Shawez17/iseg_6kV_controlSystem/data/README.md

# Data

This folder contains the information about calibration and characterization measurements made while building the supply.

```
calibration/ # Contains the calibration data for vmon, imon and vset
stability/   # Stability characterization of the power supply with analog and remote control settings.
```
