Shawez17/iseg_6kV_controlSystem/pico-raspi/plot.md

Vset expected  : 2.52828 V
Vdac measured  : 2.48955 V
Vset - Vdac    : 0.03873 V

Vset expected  : 2.53096 V
Vdac measured  : 2.49222 V
Vset - Vdac    : 0.03874 V

Vset expected  : 2.53106 V
Vdac measured  : 2.49195 V
Vset - Vdac    : 0.03911 V

Vset expected  : 2.53162 V
Vdac measured  : 2.49264 V
Vset - Vdac    : 0.03898 V

Vset expected  : 2.53133 V
Vdac measured  : 2.49225 V
Vset - Vdac    : 0.03908 V

Vset expected  : 2.53127 V
Vdac measured  : 2.49279 V
Vset - Vdac    : 0.03848 V

Vset expected  : 2.53156 V
Vdac measured  : 2.49267 V
Vset - Vdac    : 0.03889 V

Vset expected  : 2.53184 V
Vdac measured  : 2.49276 V
Vset - Vdac    : 0.03908 V

Vset expected  : 2.53172 V
Vdac measured  : 2.49255 V
Vset - Vdac    : 0.03917 V

Vset expected  : 2.53184 V
Vdac measured  : 2.49303 V
Vset - Vdac    : 0.03881 V

Vset expected  : 2.53172 V
Vdac measured  : 2.49315 V
Vset - Vdac    : 0.03857 V

Vset expected  : 2.53160 V
Vdac measured  : 2.49264 V
Vset - Vdac    : 0.03896 V

Vset expected  : 2.53199 V
Vdac measured  : 2.49318 V
Vset - Vdac    : 0.03881 V

Vset expected  : 2.53182 V
Vdac measured  : 2.49300 V
Vset - Vdac    : 0.03882 V

Vset expected  : 2.53166 V
Vdac measured  : 2.49288 V
Vset - Vdac    : 0.03878 V

Vset expected  : 2.53121 V
Vdac measured  : 2.49279 V
Vset - Vdac    : 0.03842 V

Vset expected  : 2.53106 V
Vdac measured  : 2.49294 V
Vset - Vdac    : 0.03812 V

Vset expected  : 2.53177 V
Vdac measured  : 2.49318 V
Vset - Vdac    : 0.03859 V

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
Vset - Vdac    : 0.03888 V

Vset expected  : 2.53206 V
Vdac measured  : 2.49369 V
Vset - Vdac    : 0.03837 V

Vset expected  : 2.53187 V
Vdac measured  : 2.49309 V
Vset - Vdac    : 0.03878 V

Vset expected  : 2.53196 V
Vdac measured  : 2.49390 V
Vset - Vdac    : 0.03806 V
