Shawez17/iseg_6kV_controlSystem/data/blockdiagram.png

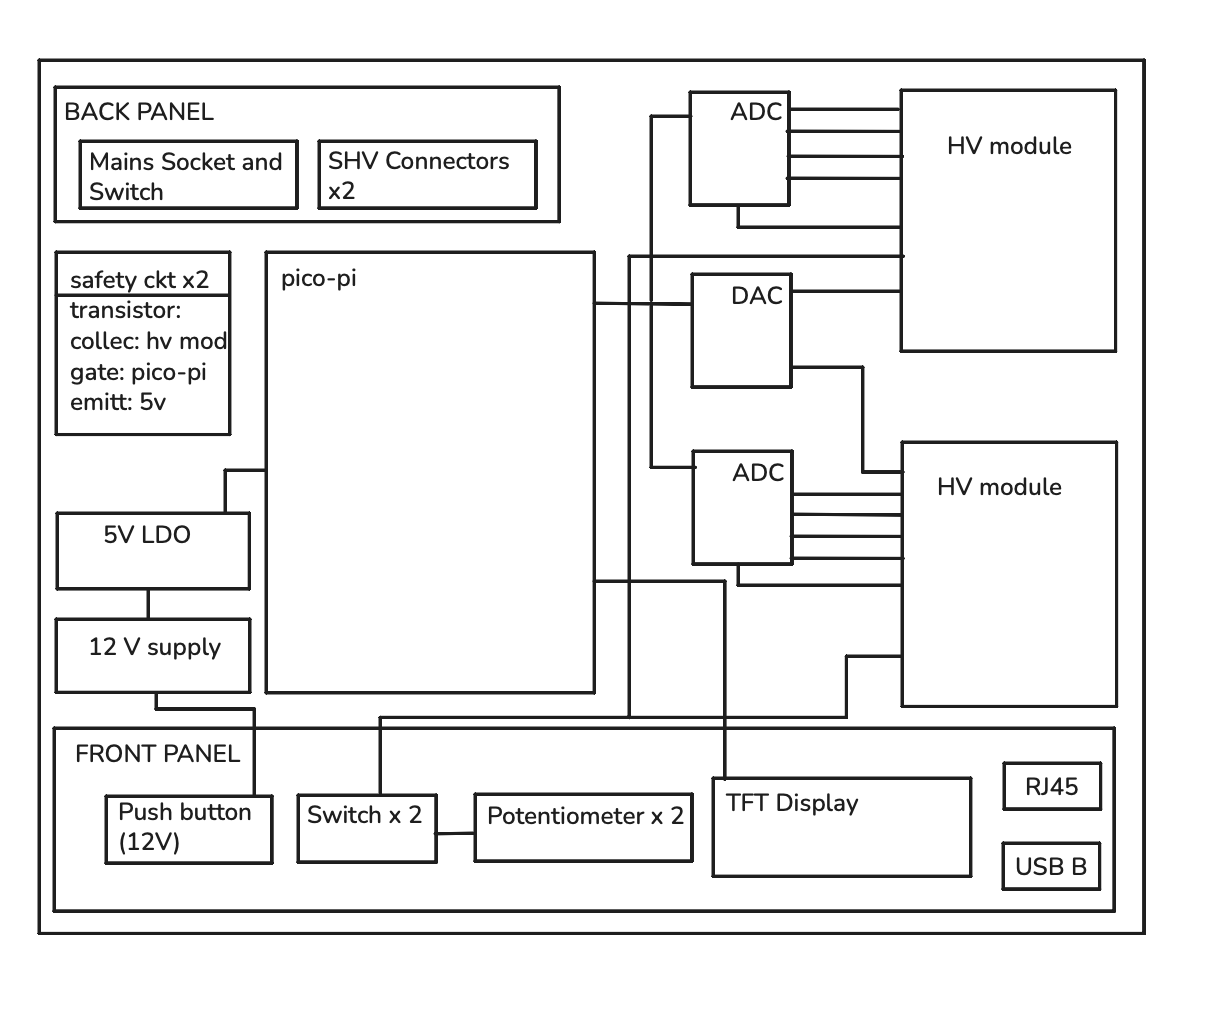
data/blockdiagram.png
