Shawez17/iseg_6kV_controlSystem/images/pinout.png

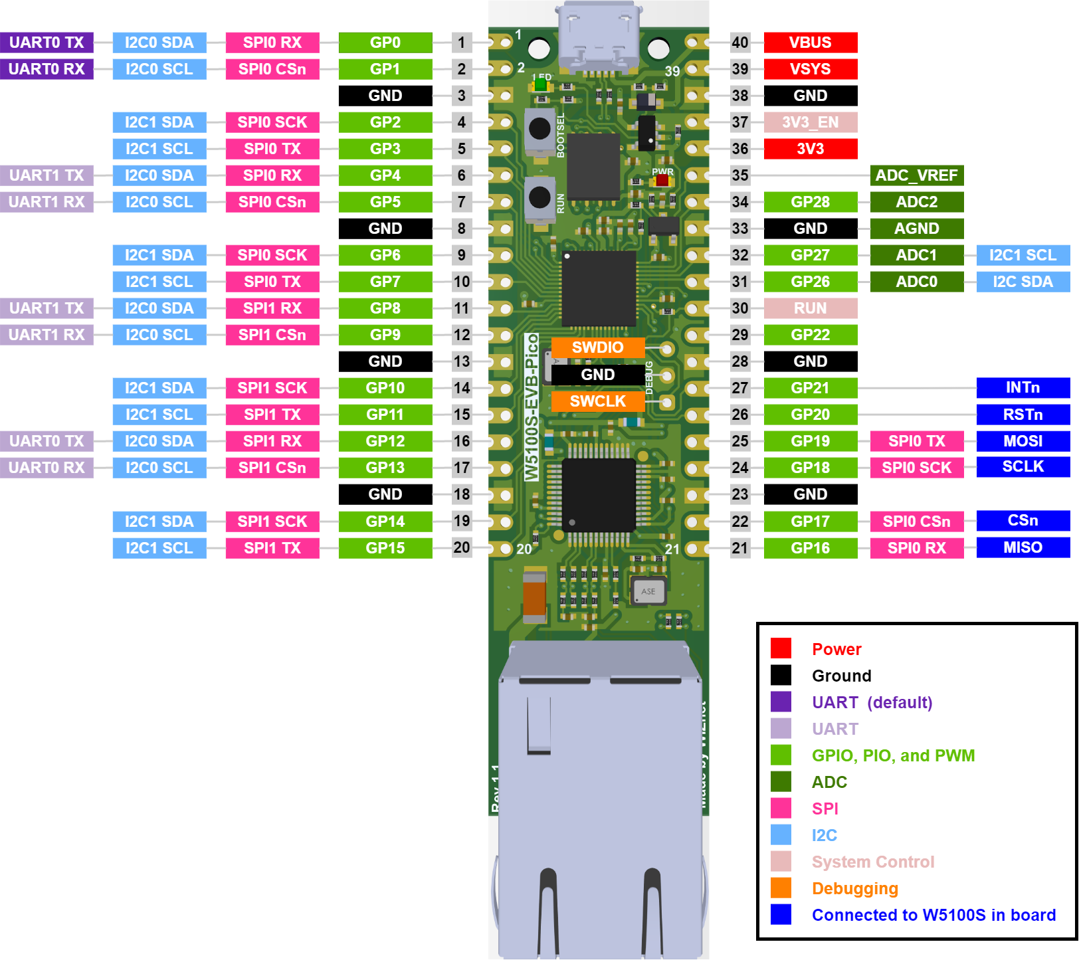
images/pinout.png
