Shawez17/iseg_6kV_controlSystem/references/shq222-front-panel.png

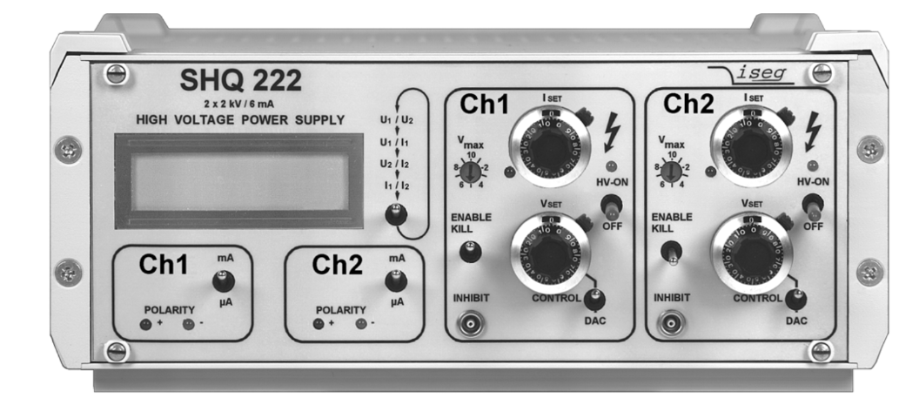
references/shq222-front-panel.png
