Shawez17/iseg_6kV_controlSystem/references/shq222_schematic.png

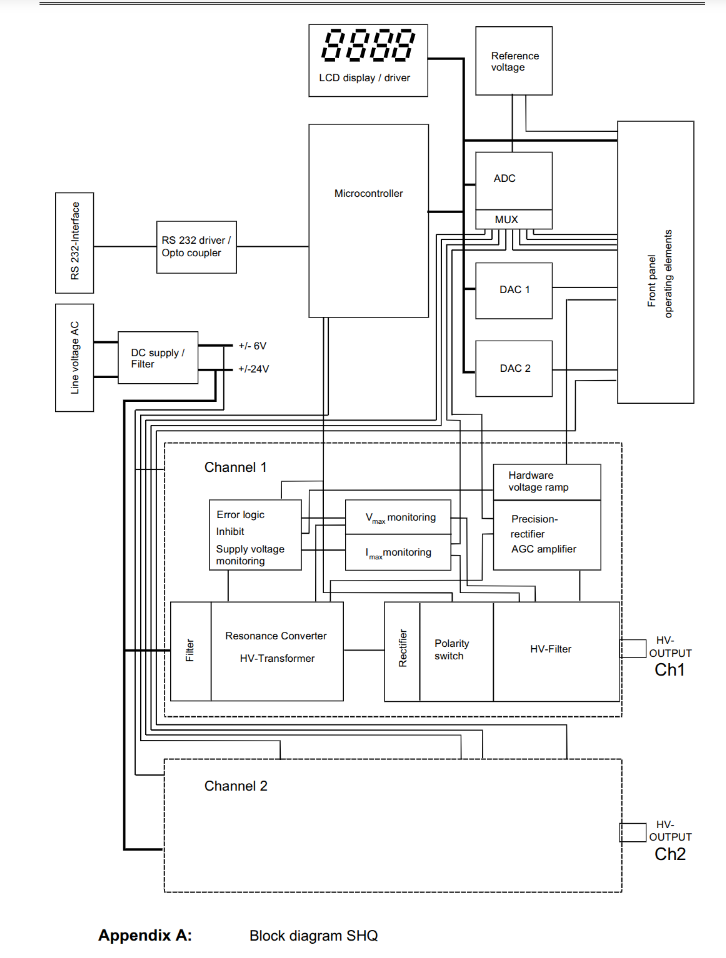
references/shq222_schematic.png
