Shawez17/iseg_6kV_controlSystem/references/shr_back_panel.png

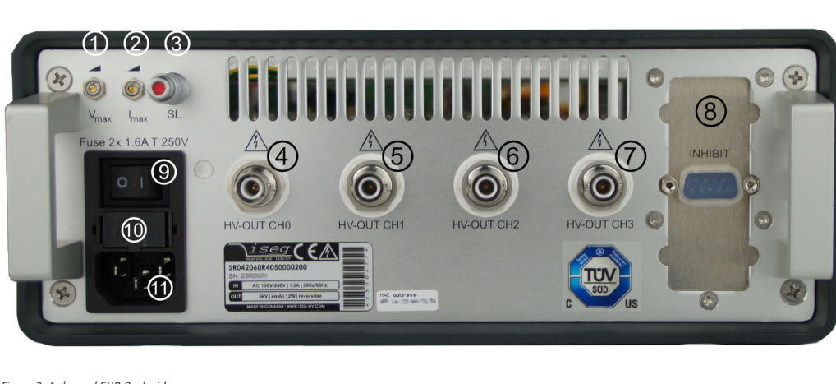
references/shr_back_panel.png
