Shawez17/iseg_6kV_controlSystem/references/shr_lcd_front_panel.png

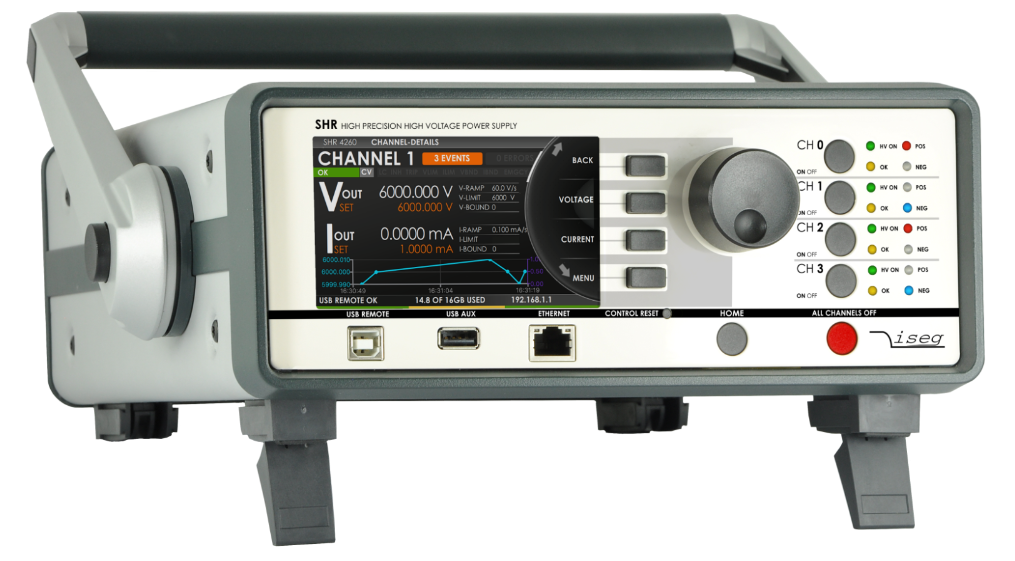
references/shr_lcd_front_panel.png
