Shawez17/iseg_6kV_controlSystem/meta/2.4inch_SPI_Module_ILI9341_MSP2402_V1.1/1-Demo/Demo_Arduino/Install libraries/LCDWIKI_SPI/Document/LCDWIKI SPI lib Supported display modules&controllers.pdf

# LCDWIKI KBV lib Supported display modules&controllers

### 1. IMPORTANT

Please note that if you use this library with display modules that are not on this

list,it won't work.so when using display modules,you should confirm it is on this list

or not.

### 2. Supported display modules&controllers

controller Mode for LCDWIKI KBV

Supported mode

SPI
ILI9325 | ID_932x | YES
ILI9328 | ID_932x | YES
ILI9341 | ID_9341 | YES
HX8357D | ID_HX8357D | YES
HX8347G | ID_7575 | YES
HX8347I | ID_7575 | YES
ILI9486 | ID_9486 | YES
ST7735S | ID_7735 | YES
SSD1283A | ID_1283 | YES
