Shawez17/iseg_6kV_controlSystem/meta/test_from_scratch/README.md

# Control System Code

### W5100S-EVB-Pico

Ethernet module pins

```
PIN 16: SPI RX 
PIN 17: Chip-select SPI
PIN 18: SPI SCK 
PIN 19: SPI TX 
PIN 20: Reset pin 
PIN 21: Interrupt pin 
```

Pinout diagram
