Shawez17/iseg_6kV_controlSystem/mcu_tests/pico-raspi/plot_data_1000.md

Vset expected  : 1.26499 V
Vdac measured  : 1.24323 V
Vset - Vdac    : 0.02176 V

Vset expected  : 1.26537 V
Vdac measured  : 1.24278 V
Vset - Vdac    : 0.02259 V
