Shawez17/iseg_6kV_controlSystem/mcu_tests/pico-raspi/plot_data_3000.md

V_mm : 3.750V

Vset expected  : 3.79593 V
Vdac measured  : 3.75906 V
Vset - Vdac    : 0.03687 V

Vset expected  : 3.79569 V
Vdac measured  : 3.75927 V
Vset - Vdac    : 0.03642 V

Vset expected  : 3.79207 V
Vdac measured  : 3.75576 V
Vset - Vdac    : 0.03631 V
