Shawez17/iseg_6kV_controlSystem/mcu_tests/pico-raspi/plot_data_4095.md

Vset expected  : 5.18202 V
Vdac measured  : 5.15835 V
Vset - Vdac    : 0.02367 V

Vset expected  : 5.18133 V
Vdac measured  : 5.15607 V
Vset - Vdac    : 0.02526 V

Vset expected  : 5.18124 V
Vdac measured  : 5.15688 V
Vset - Vdac    : 0.02436 V
