Shawez17/iseg_6kV_controlSystem/mcu_tests/pico-raspi/plot_data_span.md

Vset expected  : 0.11359 V
Vdac measured  : 0.11202 V
Vset - Vdac    : 0.00157 V
Dac bits       : 90

Vset expected  : 0.17043 V
Vdac measured  : 0.16707 V
Vset - Vdac    : 0.00336 V
Dac bits       : 135

Vset expected  : 0.22725 V
Vdac measured  : 0.22359 V
Vset - Vdac    : 0.00366 V
Dac bits       : 180

Vset expected  : 0.28405 V
Vdac measured  : 0.27882 V
Vset - Vdac    : 0.00523 V
Dac bits       : 225

Vset expected  : 0.34076 V
Vdac measured  : 0.33585 V
Vset - Vdac    : 0.00491 V
Dac bits       : 270

Vset expected  : 0.39763 V
Vdac measured  : 0.39036 V
Vset - Vdac    : 0.00727 V
Dac bits       : 315

Vset expected  : 0.45444 V
Vdac measured  : 0.44676 V
Vset - Vdac    : 0.00768 V
Dac bits       : 360

Vset expected  : 0.51115 V
Vdac measured  : 0.50067 V
Vset - Vdac    : 0.01048 V
Dac bits       : 405

Vset expected  : 0.56810 V
Vdac measured  : 0.55563 V
Vset - Vdac    : 0.01247 V
Dac bits       : 450

Vset expected  : 0.62468 V
Vdac measured  : 0.61383 V
Vset - Vdac    : 0.01085 V
Dac bits       : 495

Vset expected  : 0.68173 V
Vdac measured  : 0.66960 V
Vset - Vdac    : 0.01213 V
Dac bits       : 540

Vset expected  : 0.73847 V
Vdac measured  : 0.72582 V
Vset - Vdac    : 0.01265 V
Dac bits       : 585

Vset expected  : 0.79546 V
Vdac measured  : 0.78147 V
Vset - Vdac    : 0.01399 V
Dac bits       : 630

Vset expected  : 0.85206 V
Vdac measured  : 0.83739 V
Vset - Vdac    : 0.01467 V
Dac bits       : 675

Vset expected  : 0.90867 V
Vdac measured  : 0.89190 V
Vset - Vdac    : 0.01677 V
Dac bits       : 720

Vset expected  : 0.96572 V
Vdac measured  : 0.94797 V
Vset - Vdac    : 0.01775 V
Dac bits       : 765

Vset expected  : 1.02233 V
Vdac measured  : 1.00305 V
Vset - Vdac    : 0.01928 V
Dac bits       : 810
