Shawez17/iseg_6kV_controlSystem/mcu_tests/pico-raspi/plot_data_span_trice.md

Panther,~/D/k/c/c/m/pico-raspi>arduino-cli monitor -p /dev/cu.usbmodem11201 -c baudrate=9600            17:39:59
Monitor port settings:
  baudrate=9600
  bits=8
  dtr=on
  parity=none
  rts=on
  stop_bits=1

Connecting to /dev/cu.usbmodem11201. Press CTRL-C to exit.
Vset expected  : 0.11392 V
Vdac measured  : 0.11175 V
Vset - Vdac    : 0.00217 V
Dac bits       : 90

Vset expected  : 0.17084 V
Vdac measured  : 0.16743 V
Vset - Vdac    : 0.00341 V
Dac bits       : 135

Vset expected  : 0.22788 V
Vdac measured  : 0.22524 V
Vset - Vdac    : 0.00264 V
Dac bits       : 180

Vset expected  : 0.28486 V
Vdac measured  : 0.28005 V
Vset - Vdac    : 0.00481 V
Dac bits       : 225

Vset expected  : 0.34180 V
Vdac measured  : 0.33669 V
Vset - Vdac    : 0.00511 V
Dac bits       : 270

Vset expected  : 0.39877 V
Vdac measured  : 0.39234 V
Vset - Vdac    : 0.00643 V
Dac bits       : 315

Vset expected  : 0.45563 V
Vdac measured  : 0.44829 V
Vset - Vdac    : 0.00734 V
Dac bits       : 360

Vset expected  : 0.51268 V
Vdac measured  : 0.50241 V
Vset - Vdac    : 0.01027 V
Dac bits       : 405

Vset expected  : 0.56841 V
Vdac measured  : 0.55575 V
Vset - Vdac    : 0.01266 V
Dac bits       : 450

Vset expected  : 0.62560 V
Vdac measured  : 0.61461 V
Vset - Vdac    : 0.01099 V
Dac bits       : 495

Vset expected  : 0.68269 V
Vdac measured  : 0.67050 V
Vset - Vdac    : 0.01219 V
Dac bits       : 540

Vset expected  : 0.73946 V
Vdac measured  : 0.72702 V
Vset - Vdac    : 0.01244 V
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
Vdac measured  : 5.08371 V
Vset - Vdac    : 0.03051 V
Dac bits       : 4050

Vset expected  : 0.05682 V
Vdac measured  : 0.05493 V
Vset - Vdac    : 0.00189 V
Dac bits       : 45

Vset expected  : 0.11367 V
Vdac measured  : 0.11175 V
Vset - Vdac    : 0.00192 V
Dac bits       : 90
