Shawez17/iseg_6kV_controlSystem/mcu_tests/pico-raspi/final_final_dac_stability_2_60minute.md

Connecting to /dev/cu.usbmodem11301. Press CTRL-C to exit.
ADS1(0x48) A0 avg raw: 13474.85	V: 2.52653 V	Diff_vs_DAC: 0.08453 V
ADS2(0x49) A0 avg raw: 13236.32	V: 2.48181 V	Diff_vs_DAC: 0.03981 V
V_set_dac: 2.4420 V

ADS1(0x48) A0 avg raw: 13475.03	V: 2.52657 V	Diff_vs_DAC: 0.08457 V
ADS2(0x49) A0 avg raw: 13236.82	V: 2.48190 V	Diff_vs_DAC: 0.03990 V
V_set_dac: 2.4420 V
ADS1(0x48) A0 avg raw: 13462.91	V: 2.52430 V	Diff_vs_DAC: 0.08229 V
ADS2(0x49) A0 avg raw: 13233.76	V: 2.48133 V	Diff_vs_DAC: 0.03933 V
V_set_dac: 2.4420 V

ADS1(0x48) A0 avg raw: 13465.80	V: 2.52484 V	Diff_vs_DAC: 0.08284 V
ADS2(0x49) A0 avg raw: 13236.43	V: 2.48183 V	Diff_vs_DAC: 0.03983 V
V_set_dac: 2.4420 V

ADS1(0x48) A0 avg raw: 13465.83	V: 2.52484 V	Diff_vs_DAC: 0.08284 V
ADS2(0x49) A0 avg raw: 13236.48	V: 2.48184 V	Diff_vs_DAC: 0.03984 V
V_set_dac: 2.4420 V

ADS1(0x48) A0 avg raw: 13465.98	V: 2.52487 V	Diff_vs_DAC: 0.08287 V
ADS2(0x49) A0 avg raw: 13236.32	V: 2.48181 V	Diff_vs_DAC: 0.03981 V
V_set_dac: 2.4420 V

ADS1(0x48) A0 avg raw: 13465.93	V: 2.52486 V	Diff_vs_DAC: 0.08286 V
ADS2(0x49) A0 avg raw: 13237.20	V: 2.48198 V	Diff_vs_DAC: 0.03997 V
V_set_dac: 2.4420 V

ADS1(0x48) A0 avg raw: 13466.16	V: 2.52490 V	Diff_vs_DAC: 0.08290 V
ADS2(0x49) A0 avg raw: 13236.42	V: 2.48183 V	Diff_vs_DAC: 0.03983 V
V_set_dac: 2.4420 V

ADS1(0x48) A0 avg raw: 13466.24	V: 2.52492 V	Diff_vs_DAC: 0.08292 V
ADS2(0x49) A0 avg raw: 13236.24	V: 2.48180 V	Diff_vs_DAC: 0.03979 V
V_set_dac: 2.4420 V

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
ADS2(0x49) A0 avg raw: 13236.56	V: 2.48185 V	Diff_vs_DAC: 0.03985 V
V_set_dac: 2.4420 V

ADS1(0x48) A0 avg raw: 13467.51	V: 2.52516 V	Diff_vs_DAC: 0.08316 V
ADS2(0x49) A0 avg raw: 13236.88	V: 2.48191 V	Diff_vs_DAC: 0.03991 V
V_set_dac: 2.4420 V
