Shawez17/iseg_6kV_controlSystem/mcu_tests/esp32-dev1/Data_map_pot_dac.md

________________________________________________________
Executed in  242.06 secs    fish           external
   usr time    1.14 secs    0.35 millis    1.14 secs
   sys time    1.25 secs    1.69 millis    1.25 secs

Position: 72	DAC_Bits: 2978	V_set_dac: 3.636 V	V_set_pot: 3.636 V	ADC_A0_raw: 19489	V_adc_a0: 3.654 V	ADC_A1_raw: 19402	V_adc_a1: 3.638 V
Position: 71	DAC_Bits: 2936	V_set_dac: 3.585 V	V_set_pot: 3.586 V	ADC_A0_raw: 19223	V_adc_a0: 3.604 V	ADC_A1_raw: 19131	V_adc_a1: 3.587 V
Position: 70	DAC_Bits: 2895	V_set_dac: 3.535 V	V_set_pot: 3.535 V	ADC_A0_raw: 18952	V_adc_a0: 3.553 V	ADC_A1_raw: 18865	V_adc_a1: 3.537 V
Position: 69	DAC_Bits: 2854	V_set_dac: 3.485 V	V_set_pot: 3.485 V	ADC_A0_raw: 18678	V_adc_a0: 3.502 V	ADC_A1_raw: 18601	V_adc_a1: 3.488 V
Position: 68	DAC_Bits: 2812	V_set_dac: 3.433 V	V_set_pot: 3.434 V	ADC_A0_raw: 18407	V_adc_a0: 3.451 V	ADC_A1_raw: 18330	V_adc_a1: 3.437 V
Position: 67	DAC_Bits: 2771	V_set_dac: 3.383 V	V_set_pot: 3.384 V	ADC_A0_raw: 18134	V_adc_a0: 3.400 V	ADC_A1_raw: 18064	V_adc_a1: 3.387 V
Position: 66	DAC_Bits: 2730	V_set_dac: 3.333 V	V_set_pot: 3.333 V	ADC_A0_raw: 17868	V_adc_a0: 3.350 V	ADC_A1_raw: 17796	V_adc_a1: 3.337 V
Position: 65	DAC_Bits: 2688	V_set_dac: 3.282 V	V_set_pot: 3.283 V	ADC_A0_raw: 17593	V_adc_a0: 3.299 V	ADC_A1_raw: 17518	V_adc_a1: 3.285 V
Position: 64	DAC_Bits: 2647	V_set_dac: 3.232 V	V_set_pot: 3.232 V	ADC_A0_raw: 17321	V_adc_a0: 3.248 V	ADC_A1_raw: 17250	V_adc_a1: 3.234 V
Position: 63	DAC_Bits: 2605	V_set_dac: 3.181 V	V_set_pot: 3.182 V	ADC_A0_raw: 17049	V_adc_a0: 3.197 V	ADC_A1_raw: 16975	V_adc_a1: 3.183 V
Position: 62	DAC_Bits: 2564	V_set_dac: 3.131 V	V_set_pot: 3.131 V	ADC_A0_raw: 16782	V_adc_a0: 3.147 V	ADC_A1_raw: 16710	V_adc_a1: 3.133 V
Position: 61	DAC_Bits: 2523	V_set_dac: 3.081 V	V_set_pot: 3.081 V	ADC_A0_raw: 16511	V_adc_a0: 3.096 V	ADC_A1_raw: 16433	V_adc_a1: 3.081 V
Position: 60	DAC_Bits: 2481	V_set_dac: 3.029 V	V_set_pot: 3.030 V	ADC_A0_raw: 16237	V_adc_a0: 3.044 V	ADC_A1_raw: 16153	V_adc_a1: 3.029 V
Position: 59	DAC_Bits: 2440	V_set_dac: 2.979 V	V_set_pot: 2.980 V	ADC_A0_raw: 15966	V_adc_a0: 2.994 V	ADC_A1_raw: 15882	V_adc_a1: 2.978 V
Position: 58	DAC_Bits: 2399	V_set_dac: 2.929 V	V_set_pot: 2.929 V	ADC_A0_raw: 15698	V_adc_a0: 2.943 V	ADC_A1_raw: 15611	V_adc_a1: 2.927 V
Position: 57	DAC_Bits: 2357	V_set_dac: 2.878 V	V_set_pot: 2.879 V	ADC_A0_raw: 15423	V_adc_a0: 2.892 V	ADC_A1_raw: 15339	V_adc_a1: 2.876 V
Position: 56	DAC_Bits: 2316	V_set_dac: 2.828 V	V_set_pot: 2.828 V	ADC_A0_raw: 15149	V_adc_a0: 2.840 V	ADC_A1_raw: 15074	V_adc_a1: 2.826 V
Position: 55	DAC_Bits: 2275	V_set_dac: 2.778 V	V_set_pot: 2.778 V	ADC_A0_raw: 14883	V_adc_a0: 2.791 V	ADC_A1_raw: 14808	V_adc_a1: 2.776 V
Position: 54	DAC_Bits: 2233	V_set_dac: 2.726 V	V_set_pot: 2.727 V	ADC_A0_raw: 14616	V_adc_a0: 2.740 V	ADC_A1_raw: 14537	V_adc_a1: 2.726 V
Position: 53	DAC_Bits: 2192	V_set_dac: 2.676 V	V_set_pot: 2.677 V	ADC_A0_raw: 14347	V_adc_a0: 2.690 V	ADC_A1_raw: 14274	V_adc_a1: 2.676 V
Position: 52	DAC_Bits: 2150	V_set_dac: 2.625 V	V_set_pot: 2.626 V	ADC_A0_raw: 14072	V_adc_a0: 2.638 V	ADC_A1_raw: 13999	V_adc_a1: 2.625 V
Position: 51	DAC_Bits: 2109	V_set_dac: 2.575 V	V_set_pot: 2.576 V	ADC_A0_raw: 13801	V_adc_a0: 2.588 V	ADC_A1_raw: 13728	V_adc_a1: 2.574 V
Position: 50	DAC_Bits: 2068	V_set_dac: 2.525 V	V_set_pot: 2.525 V	ADC_A0_raw: 13528	V_adc_a0: 2.536 V	ADC_A1_raw: 13459	V_adc_a1: 2.524 V
Position: 49	DAC_Bits: 2026	V_set_dac: 2.474 V	V_set_pot: 2.475 V	ADC_A0_raw: 13258	V_adc_a0: 2.486 V	ADC_A1_raw: 13180	V_adc_a1: 2.471 V
Position: 48	DAC_Bits: 1985	V_set_dac: 2.424 V	V_set_pot: 2.424 V	ADC_A0_raw: 12990	V_adc_a0: 2.436 V	ADC_A1_raw: 12906	V_adc_a1: 2.420 V
Position: 47	DAC_Bits: 1944	V_set_dac: 2.374 V	V_set_pot: 2.374 V	ADC_A0_raw: 12717	V_adc_a0: 2.384 V	ADC_A1_raw: 12641	V_adc_a1: 2.370 V
Position: 46	DAC_Bits: 1902	V_set_dac: 2.322 V	V_set_pot: 2.323 V	ADC_A0_raw: 12447	V_adc_a0: 2.334 V	ADC_A1_raw: 12369	V_adc_a1: 2.319 V
Position: 45	DAC_Bits: 1861	V_set_dac: 2.272 V	V_set_pot: 2.273 V	ADC_A0_raw: 12176	V_adc_a0: 2.283 V	ADC_A1_raw: 12103	V_adc_a1: 2.269 V
Position: 44	DAC_Bits: 1820	V_set_dac: 2.222 V	V_set_pot: 2.222 V	ADC_A0_raw: 11902	V_adc_a0: 2.232 V	ADC_A1_raw: 11834	V_adc_a1: 2.219 V
Position: 43	DAC_Bits: 1778	V_set_dac: 2.171 V	V_set_pot: 2.172 V	ADC_A0_raw: 11633	V_adc_a0: 2.181 V	ADC_A1_raw: 11560	V_adc_a1: 2.168 V
Position: 42	DAC_Bits: 1737	V_set_dac: 2.121 V	V_set_pot: 2.121 V	ADC_A0_raw: 11362	V_adc_a0: 2.130 V	ADC_A1_raw: 11296	V_adc_a1: 2.118 V
Position: 41	DAC_Bits: 1695	V_set_dac: 2.070 V	V_set_pot: 2.071 V	ADC_A0_raw: 11095	V_adc_a0: 2.080 V	ADC_A1_raw: 11023	V_adc_a1: 2.067 V
Position: 40	DAC_Bits: 1654	V_set_dac: 2.020 V	V_set_pot: 2.020 V	ADC_A0_raw: 10821	V_adc_a0: 2.029 V	ADC_A1_raw: 10755	V_adc_a1: 2.017 V
Position: 39	DAC_Bits: 1613	V_set_dac: 1.969 V	V_set_pot: 1.970 V	ADC_A0_raw: 10554	V_adc_a0: 1.979 V	ADC_A1_raw: 10491	V_adc_a1: 1.967 V
Position: 38	DAC_Bits: 1571	V_set_dac: 1.918 V	V_set_pot: 1.919 V	ADC_A0_raw: 10285	V_adc_a0: 1.928 V	ADC_A1_raw: 10225	V_adc_a1: 1.917 V
Position: 37	DAC_Bits: 1530	V_set_dac: 1.868 V	V_set_pot: 1.869 V	ADC_A0_raw: 10013	V_adc_a0: 1.877 V	ADC_A1_raw: 9960	V_adc_a1: 1.868 V
Position: 36	DAC_Bits: 1489	V_set_dac: 1.818 V	V_set_pot: 1.818 V	ADC_A0_raw: 9745	V_adc_a0: 1.827 V	ADC_A1_raw: 9688	V_adc_a1: 1.817 V
Position: 35	DAC_Bits: 1447	V_set_dac: 1.767 V	V_set_pot: 1.768 V	ADC_A0_raw: 9475	V_adc_a0: 1.777 V	ADC_A1_raw: 9413	V_adc_a1: 1.765 V
Position: 34	DAC_Bits: 1406	V_set_dac: 1.717 V	V_set_pot: 1.717 V	ADC_A0_raw: 9204	V_adc_a0: 1.726 V	ADC_A1_raw: 9145	V_adc_a1: 1.715 V
Position: 33	DAC_Bits: 1365	V_set_dac: 1.667 V	V_set_pot: 1.667 V	ADC_A0_raw: 8932	V_adc_a0: 1.675 V	ADC_A1_raw: 8877	V_adc_a1: 1.664 V
Position: 32	DAC_Bits: 1323	V_set_dac: 1.615 V	V_set_pot: 1.616 V	ADC_A0_raw: 8657	V_adc_a0: 1.623 V	ADC_A1_raw: 8603	V_adc_a1: 1.613 V
Position: 31	DAC_Bits: 1282	V_set_dac: 1.565 V	V_set_pot: 1.566 V	ADC_A0_raw: 8386	V_adc_a0: 1.572 V	ADC_A1_raw: 8338	V_adc_a1: 1.563 V
Position: 30	DAC_Bits: 1240	V_set_dac: 1.514 V	V_set_pot: 1.515 V	ADC_A0_raw: 8114	V_adc_a0: 1.521 V	ADC_A1_raw: 8066	V_adc_a1: 1.512 V
Position: 29	DAC_Bits: 1199	V_set_dac: 1.464 V	V_set_pot: 1.465 V	ADC_A0_raw: 7847	V_adc_a0: 1.471 V	ADC_A1_raw: 7802	V_adc_a1: 1.463 V
Position: 28	DAC_Bits: 1158	V_set_dac: 1.414 V	V_set_pot: 1.414 V	ADC_A0_raw: 7577	V_adc_a0: 1.421 V	ADC_A1_raw: 7537	V_adc_a1: 1.413 V
Position: 27	DAC_Bits: 1116	V_set_dac: 1.363 V	V_set_pot: 1.364 V	ADC_A0_raw: 7307	V_adc_a0: 1.370 V	ADC_A1_raw: 7263	V_adc_a1: 1.362 V
Position: 26	DAC_Bits: 1075	V_set_dac: 1.313 V	V_set_pot: 1.313 V	ADC_A0_raw: 7032	V_adc_a0: 1.319 V	ADC_A1_raw: 6997	V_adc_a1: 1.312 V
Position: 25	DAC_Bits: 1034	V_set_dac: 1.263 V	V_set_pot: 1.263 V	ADC_A0_raw: 6763	V_adc_a0: 1.268 V	ADC_A1_raw: 6727	V_adc_a1: 1.261 V
Position: 24	DAC_Bits: 992	V_set_dac: 1.211 V	V_set_pot: 1.212 V	ADC_A0_raw: 6496	V_adc_a0: 1.218 V	ADC_A1_raw: 6446	V_adc_a1: 1.209 V
Position: 23	DAC_Bits: 951	V_set_dac: 1.161 V	V_set_pot: 1.162 V	ADC_A0_raw: 6225	V_adc_a0: 1.167 V	ADC_A1_raw: 6173	V_adc_a1: 1.157 V
Position: 22	DAC_Bits: 910	V_set_dac: 1.111 V	V_set_pot: 1.111 V	ADC_A0_raw: 5954	V_adc_a0: 1.116 V	ADC_A1_raw: 5910	V_adc_a1: 1.108 V
Position: 21	DAC_Bits: 868	V_set_dac: 1.060 V	V_set_pot: 1.061 V	ADC_A0_raw: 5686	V_adc_a0: 1.066 V	ADC_A1_raw: 5636	V_adc_a1: 1.057 V
Position: 20	DAC_Bits: 827	V_set_dac: 1.010 V	V_set_pot: 1.010 V	ADC_A0_raw: 5409	V_adc_a0: 1.014 V	ADC_A1_raw: 5365	V_adc_a1: 1.006 V
Position: 19	DAC_Bits: 785	V_set_dac: 0.958 V	V_set_pot: 0.960 V	ADC_A0_raw: 5141	V_adc_a0: 0.964 V	ADC_A1_raw: 5092	V_adc_a1: 0.955 V
Position: 18	DAC_Bits: 744	V_set_dac: 0.908 V	V_set_pot: 0.909 V	ADC_A0_raw: 4868	V_adc_a0: 0.913 V	ADC_A1_raw: 4826	V_adc_a1: 0.905 V
Position: 17	DAC_Bits: 703	V_set_dac: 0.858 V	V_set_pot: 0.859 V	ADC_A0_raw: 4597	V_adc_a0: 0.862 V	ADC_A1_raw: 4562	V_adc_a1: 0.855 V
Position: 16	DAC_Bits: 661	V_set_dac: 0.807 V	V_set_pot: 0.808 V	ADC_A0_raw: 4327	V_adc_a0: 0.811 V	ADC_A1_raw: 4293	V_adc_a1: 0.805 V
Position: 15	DAC_Bits: 620	V_set_dac: 0.757 V	V_set_pot: 0.758 V	ADC_A0_raw: 4057	V_adc_a0: 0.761 V	ADC_A1_raw: 4027	V_adc_a1: 0.755 V
Position: 14	DAC_Bits: 579	V_set_dac: 0.707 V	V_set_pot: 0.707 V	ADC_A0_raw: 3786	V_adc_a0: 0.710 V	ADC_A1_raw: 3761	V_adc_a1: 0.705 V
Position: 13	DAC_Bits: 537	V_set_dac: 0.656 V	V_set_pot: 0.657 V	ADC_A0_raw: 3512	V_adc_a0: 0.659 V	ADC_A1_raw: 3489	V_adc_a1: 0.654 V
Position: 12	DAC_Bits: 496	V_set_dac: 0.606 V	V_set_pot: 0.606 V	ADC_A0_raw: 3246	V_adc_a0: 0.609 V	ADC_A1_raw: 3220	V_adc_a1: 0.604 V
Position: 11	DAC_Bits: 455	V_set_dac: 0.556 V	V_set_pot: 0.556 V	ADC_A0_raw: 2974	V_adc_a0: 0.558 V	ADC_A1_raw: 2946	V_adc_a1: 0.552 V
Position: 10	DAC_Bits: 413	V_set_dac: 0.504 V	V_set_pot: 0.505 V	ADC_A0_raw: 2703	V_adc_a0: 0.507 V	ADC_A1_raw: 2675	V_adc_a1: 0.502 V
Position: 9	DAC_Bits: 372	V_set_dac: 0.454 V	V_set_pot: 0.455 V	ADC_A0_raw: 2432	V_adc_a0: 0.456 V	ADC_A1_raw: 2412	V_adc_a1: 0.452 V
Position: 8	DAC_Bits: 330	V_set_dac: 0.403 V	V_set_pot: 0.404 V	ADC_A0_raw: 2162	V_adc_a0: 0.405 V	ADC_A1_raw: 2142	V_adc_a1: 0.402 V
Position: 7	DAC_Bits: 289	V_set_dac: 0.353 V	V_set_pot: 0.354 V	ADC_A0_raw: 1891	V_adc_a0: 0.355 V	ADC_A1_raw: 1877	V_adc_a1: 0.352 V
Position: 6	DAC_Bits: 248	V_set_dac: 0.303 V	V_set_pot: 0.303 V	ADC_A0_raw: 1619	V_adc_a0: 0.304 V	ADC_A1_raw: 1611	V_adc_a1: 0.302 V
Position: 5	DAC_Bits: 206	V_set_dac: 0.252 V	V_set_pot: 0.253 V	ADC_A0_raw: 1348	V_adc_a0: 0.253 V	ADC_A1_raw: 1338	V_adc_a1: 0.251 V
Position: 4	DAC_Bits: 165	V_set_dac: 0.201 V	V_set_pot: 0.202 V	ADC_A0_raw: 1078	V_adc_a0: 0.202 V	ADC_A1_raw: 1069	V_adc_a1: 0.200 V
Position: 3	DAC_Bits: 124	V_set_dac: 0.151 V	V_set_pot: 0.152 V	ADC_A0_raw: 808	V_adc_a0: 0.152 V	ADC_A1_raw: 798	V_adc_a1: 0.150 V
Position: 2	DAC_Bits: 82	V_set_dac: 0.100 V	V_set_pot: 0.101 V	ADC_A0_raw: 535	V_adc_a0: 0.100 V	ADC_A1_raw: 527	V_adc_a1: 0.099 V
Position: 1	DAC_Bits: 41	V_set_dac: 0.050 V	V_set_pot: 0.051 V	ADC_A0_raw: 263	V_adc_a0: 0.049 V	ADC_A1_raw: 262	V_adc_a1: 0.049 V
Position: 0	DAC_Bits: 0	V_set_dac: 0.000 V	V_set_pot: 0.000 V	ADC_A0_raw: -6	V_adc_a0: -0.001 V	ADC_A1_raw: -1	V_adc_a1: -0.000 V
Position: 0	DAC_Bits: 0	V_set_dac: 0.000 V	V_set_pot: 0.000 V	ADC_A0_raw: -7	V_adc_a0: -0.001 V	ADC_A1_raw: 0	V_adc_a1: 0.000 V
Position: 1	DAC_Bits: 41	V_set_dac: 0.050 V	V_set_pot: 0.051 V	ADC_A0_raw: 263	V_adc_a0: 0.049 V	ADC_A1_raw: 262	V_adc_a1: 0.049 V
Position: 2	DAC_Bits: 82	V_set_dac: 0.100 V	V_set_pot: 0.101 V	ADC_A0_raw: 536	V_adc_a0: 0.101 V	ADC_A1_raw: 526	V_adc_a1: 0.099 V
Position: 3	DAC_Bits: 124	V_set_dac: 0.151 V	V_set_pot: 0.152 V	ADC_A0_raw: 807	V_adc_a0: 0.151 V	ADC_A1_raw: 798	V_adc_a1: 0.150 V
Position: 4	DAC_Bits: 165	V_set_dac: 0.201 V	V_set_pot: 0.202 V	ADC_A0_raw: 1079	V_adc_a0: 0.202 V	ADC_A1_raw: 1069	V_adc_a1: 0.200 V
Position: 5	DAC_Bits: 206	V_set_dac: 0.252 V	V_set_pot: 0.253 V	ADC_A0_raw: 1349	V_adc_a0: 0.253 V	ADC_A1_raw: 1338	V_adc_a1: 0.251 V
Position: 6	DAC_Bits: 248	V_set_dac: 0.303 V	V_set_pot: 0.303 V	ADC_A0_raw: 1622	V_adc_a0: 0.304 V	ADC_A1_raw: 1610	V_adc_a1: 0.302 V
Position: 7	DAC_Bits: 289	V_set_dac: 0.353 V	V_set_pot: 0.354 V	ADC_A0_raw: 1891	V_adc_a0: 0.355 V	ADC_A1_raw: 1877	V_adc_a1: 0.352 V
Position: 8	DAC_Bits: 330	V_set_dac: 0.403 V	V_set_pot: 0.404 V	ADC_A0_raw: 2160	V_adc_a0: 0.405 V	ADC_A1_raw: 2142	V_adc_a1: 0.402 V
Position: 9	DAC_Bits: 372	V_set_dac: 0.454 V	V_set_pot: 0.455 V	ADC_A0_raw: 2436	V_adc_a0: 0.457 V	ADC_A1_raw: 2412	V_adc_a1: 0.452 V
Position: 10	DAC_Bits: 413	V_set_dac: 0.504 V	V_set_pot: 0.505 V	ADC_A0_raw: 2702	V_adc_a0: 0.507 V	ADC_A1_raw: 2675	V_adc_a1: 0.502 V
Position: 11	DAC_Bits: 455	V_set_dac: 0.556 V	V_set_pot: 0.556 V	ADC_A0_raw: 2974	V_adc_a0: 0.558 V	ADC_A1_raw: 2946	V_adc_a1: 0.552 V
Position: 12	DAC_Bits: 496	V_set_dac: 0.606 V	V_set_pot: 0.606 V	ADC_A0_raw: 3248	V_adc_a0: 0.609 V	ADC_A1_raw: 3220	V_adc_a1: 0.604 V
Position: 13	DAC_Bits: 537	V_set_dac: 0.656 V	V_set_pot: 0.657 V	ADC_A0_raw: 3514	V_adc_a0: 0.659 V	ADC_A1_raw: 3489	V_adc_a1: 0.654 V
Position: 14	DAC_Bits: 579	V_set_dac: 0.707 V	V_set_pot: 0.707 V	ADC_A0_raw: 3783	V_adc_a0: 0.709 V	ADC_A1_raw: 3762	V_adc_a1: 0.705 V
Position: 15	DAC_Bits: 620	V_set_dac: 0.757 V	V_set_pot: 0.758 V	ADC_A0_raw: 4055	V_adc_a0: 0.760 V	ADC_A1_raw: 4026	V_adc_a1: 0.755 V
Position: 16	DAC_Bits: 661	V_set_dac: 0.807 V	V_set_pot: 0.808 V	ADC_A0_raw: 4328	V_adc_a0: 0.812 V	ADC_A1_raw: 4292	V_adc_a1: 0.805 V
Position: 17	DAC_Bits: 703	V_set_dac: 0.858 V	V_set_pot: 0.859 V	ADC_A0_raw: 4598	V_adc_a0: 0.862 V	ADC_A1_raw: 4562	V_adc_a1: 0.855 V
Position: 18	DAC_Bits: 744	V_set_dac: 0.908 V	V_set_pot: 0.909 V	ADC_A0_raw: 4870	V_adc_a0: 0.913 V	ADC_A1_raw: 4827	V_adc_a1: 0.905 V
Position: 19	DAC_Bits: 785	V_set_dac: 0.958 V	V_set_pot: 0.960 V	ADC_A0_raw: 5142	V_adc_a0: 0.964 V	ADC_A1_raw: 5093	V_adc_a1: 0.955 V
Position: 20	DAC_Bits: 827	V_set_dac: 1.010 V	V_set_pot: 1.010 V	ADC_A0_raw: 5408	V_adc_a0: 1.014 V	ADC_A1_raw: 5366	V_adc_a1: 1.006 V
Position: 21	DAC_Bits: 868	V_set_dac: 1.060 V	V_set_pot: 1.061 V	ADC_A0_raw: 5683	V_adc_a0: 1.066 V	ADC_A1_raw: 5635	V_adc_a1: 1.057 V
Position: 22	DAC_Bits: 910	V_set_dac: 1.111 V	V_set_pot: 1.111 V	ADC_A0_raw: 5954	V_adc_a0: 1.116 V	ADC_A1_raw: 5910	V_adc_a1: 1.108 V
Position: 23	DAC_Bits: 951	V_set_dac: 1.161 V	V_set_pot: 1.162 V	ADC_A0_raw: 6225	V_adc_a0: 1.167 V	ADC_A1_raw: 6174	V_adc_a1: 1.158 V
Position: 24	DAC_Bits: 992	V_set_dac: 1.211 V	V_set_pot: 1.212 V	ADC_A0_raw: 6496	V_adc_a0: 1.218 V	ADC_A1_raw: 6446	V_adc_a1: 1.209 V
Position: 25	DAC_Bits: 1034	V_set_dac: 1.263 V	V_set_pot: 1.263 V	ADC_A0_raw: 6768	V_adc_a0: 1.269 V	ADC_A1_raw: 6729	V_adc_a1: 1.262 V
Position: 26	DAC_Bits: 1075	V_set_dac: 1.313 V	V_set_pot: 1.313 V	ADC_A0_raw: 7033	V_adc_a0: 1.319 V	ADC_A1_raw: 6997	V_adc_a1: 1.312 V
Position: 27	DAC_Bits: 1116	V_set_dac: 1.363 V	V_set_pot: 1.364 V	ADC_A0_raw: 7305	V_adc_a0: 1.370 V	ADC_A1_raw: 7264	V_adc_a1: 1.362 V
Position: 28	DAC_Bits: 1158	V_set_dac: 1.414 V	V_set_pot: 1.414 V	ADC_A0_raw: 7578	V_adc_a0: 1.421 V	ADC_A1_raw: 7538	V_adc_a1: 1.413 V
Position: 29	DAC_Bits: 1199	V_set_dac: 1.464 V	V_set_pot: 1.465 V	ADC_A0_raw: 7846	V_adc_a0: 1.471 V	ADC_A1_raw: 7803	V_adc_a1: 1.463 V
Position: 30	DAC_Bits: 1240	V_set_dac: 1.514 V	V_set_pot: 1.515 V	ADC_A0_raw: 8116	V_adc_a0: 1.522 V	ADC_A1_raw: 8068	V_adc_a1: 1.513 V
Position: 31	DAC_Bits: 1282	V_set_dac: 1.565 V	V_set_pot: 1.566 V	ADC_A0_raw: 8389	V_adc_a0: 1.573 V	ADC_A1_raw: 8338	V_adc_a1: 1.563 V
Position: 32	DAC_Bits: 1323	V_set_dac: 1.615 V	V_set_pot: 1.616 V	ADC_A0_raw: 8655	V_adc_a0: 1.623 V	ADC_A1_raw: 8604	V_adc_a1: 1.613 V
Position: 33	DAC_Bits: 1365	V_set_dac: 1.667 V	V_set_pot: 1.667 V	ADC_A0_raw: 8930	V_adc_a0: 1.674 V	ADC_A1_raw: 8877	V_adc_a1: 1.664 V
Position: 34	DAC_Bits: 1406	V_set_dac: 1.717 V	V_set_pot: 1.717 V	ADC_A0_raw: 9203	V_adc_a0: 1.726 V	ADC_A1_raw: 9146	V_adc_a1: 1.715 V
Position: 35	DAC_Bits: 1447	V_set_dac: 1.767 V	V_set_pot: 1.768 V	ADC_A0_raw: 9473	V_adc_a0: 1.776 V	ADC_A1_raw: 9414	V_adc_a1: 1.765 V
Position: 36	DAC_Bits: 1489	V_set_dac: 1.818 V	V_set_pot: 1.818 V	ADC_A0_raw: 9744	V_adc_a0: 1.827 V	ADC_A1_raw: 9690	V_adc_a1: 1.817 V
Position: 37	DAC_Bits: 1530	V_set_dac: 1.868 V	V_set_pot: 1.869 V	ADC_A0_raw: 10014	V_adc_a0: 1.878 V	ADC_A1_raw: 9960	V_adc_a1: 1.868 V
Position: 38	DAC_Bits: 1571	V_set_dac: 1.918 V	V_set_pot: 1.919 V	ADC_A0_raw: 10285	V_adc_a0: 1.928 V	ADC_A1_raw: 10225	V_adc_a1: 1.917 V
Position: 39	DAC_Bits: 1613	V_set_dac: 1.969 V	V_set_pot: 1.970 V	ADC_A0_raw: 10555	V_adc_a0: 1.979 V	ADC_A1_raw: 10493	V_adc_a1: 1.967 V
Position: 40	DAC_Bits: 1654	V_set_dac: 2.020 V	V_set_pot: 2.020 V	ADC_A0_raw: 10826	V_adc_a0: 2.030 V	ADC_A1_raw: 10756	V_adc_a1: 2.017 V
Position: 41	DAC_Bits: 1695	V_set_dac: 2.070 V	V_set_pot: 2.071 V	ADC_A0_raw: 11092	V_adc_a0: 2.080 V	ADC_A1_raw: 11022	V_adc_a1: 2.067 V
Position: 42	DAC_Bits: 1737	V_set_dac: 2.121 V	V_set_pot: 2.121 V	ADC_A0_raw: 11362	V_adc_a0: 2.130 V	ADC_A1_raw: 11296	V_adc_a1: 2.118 V
Position: 43	DAC_Bits: 1778	V_set_dac: 2.171 V	V_set_pot: 2.172 V	ADC_A0_raw: 11635	V_adc_a0: 2.182 V	ADC_A1_raw: 11560	V_adc_a1: 2.168 V
Position: 44	DAC_Bits: 1820	V_set_dac: 2.222 V	V_set_pot: 2.222 V	ADC_A0_raw: 11905	V_adc_a0: 2.232 V	ADC_A1_raw: 11835	V_adc_a1: 2.219 V
Position: 45	DAC_Bits: 1861	V_set_dac: 2.272 V	V_set_pot: 2.273 V	ADC_A0_raw: 12175	V_adc_a0: 2.283 V	ADC_A1_raw: 12103	V_adc_a1: 2.269 V
Position: 46	DAC_Bits: 1902	V_set_dac: 2.322 V	V_set_pot: 2.323 V	ADC_A0_raw: 12449	V_adc_a0: 2.334 V	ADC_A1_raw: 12370	V_adc_a1: 2.319 V
Position: 47	DAC_Bits: 1944	V_set_dac: 2.374 V	V_set_pot: 2.374 V	ADC_A0_raw: 12715	V_adc_a0: 2.384 V	ADC_A1_raw: 12642	V_adc_a1: 2.370 V
Position: 48	DAC_Bits: 1985	V_set_dac: 2.424 V	V_set_pot: 2.424 V	ADC_A0_raw: 12988	V_adc_a0: 2.435 V	ADC_A1_raw: 12906	V_adc_a1: 2.420 V
Position: 49	DAC_Bits: 2026	V_set_dac: 2.474 V	V_set_pot: 2.475 V	ADC_A0_raw: 13260	V_adc_a0: 2.486 V	ADC_A1_raw: 13182	V_adc_a1: 2.472 V
Position: 50	DAC_Bits: 2068	V_set_dac: 2.525 V	V_set_pot: 2.525 V	ADC_A0_raw: 13533	V_adc_a0: 2.537 V	ADC_A1_raw: 13460	V_adc_a1: 2.524 V
Position: 51	DAC_Bits: 2109	V_set_dac: 2.575 V	V_set_pot: 2.576 V	ADC_A0_raw: 13807	V_adc_a0: 2.589 V	ADC_A1_raw: 13730	V_adc_a1: 2.574 V
Position: 52	DAC_Bits: 2150	V_set_dac: 2.625 V	V_set_pot: 2.626 V	ADC_A0_raw: 14077	V_adc_a0: 2.639 V	ADC_A1_raw: 14002	V_adc_a1: 2.625 V
Position: 53	DAC_Bits: 2192	V_set_dac: 2.676 V	V_set_pot: 2.677 V	ADC_A0_raw: 14350	V_adc_a0: 2.691 V	ADC_A1_raw: 14276	V_adc_a1: 2.677 V
Position: 54	DAC_Bits: 2233	V_set_dac: 2.726 V	V_set_pot: 2.727 V	ADC_A0_raw: 14624	V_adc_a0: 2.742 V	ADC_A1_raw: 14541	V_adc_a1: 2.726 V
Position: 55	DAC_Bits: 2275	V_set_dac: 2.778 V	V_set_pot: 2.778 V	ADC_A0_raw: 14890	V_adc_a0: 2.792 V	ADC_A1_raw: 14815	V_adc_a1: 2.778 V
Position: 56	DAC_Bits: 2316	V_set_dac: 2.828 V	V_set_pot: 2.828 V	ADC_A0_raw: 15161	V_adc_a0: 2.843 V	ADC_A1_raw: 15086	V_adc_a1: 2.829 V
Position: 57	DAC_Bits: 2357	V_set_dac: 2.878 V	V_set_pot: 2.879 V	ADC_A0_raw: 15434	V_adc_a0: 2.894 V	ADC_A1_raw: 15354	V_adc_a1: 2.879 V
Position: 58	DAC_Bits: 2399	V_set_dac: 2.929 V	V_set_pot: 2.929 V	ADC_A0_raw: 15710	V_adc_a0: 2.946 V	ADC_A1_raw: 15626	V_adc_a1: 2.930 V
Position: 59	DAC_Bits: 2440	V_set_dac: 2.979 V	V_set_pot: 2.980 V	ADC_A0_raw: 15983	V_adc_a0: 2.997 V	ADC_A1_raw: 15896	V_adc_a1: 2.980 V
Position: 60	DAC_Bits: 2481	V_set_dac: 3.029 V	V_set_pot: 3.030 V	ADC_A0_raw: 16251	V_adc_a0: 3.047 V	ADC_A1_raw: 16167	V_adc_a1: 3.031 V
Position: 61	DAC_Bits: 2523	V_set_dac: 3.081 V	V_set_pot: 3.081 V	ADC_A0_raw: 16523	V_adc_a0: 3.098 V	ADC_A1_raw: 16448	V_adc_a1: 3.084 V
Position: 62	DAC_Bits: 2564	V_set_dac: 3.131 V	V_set_pot: 3.131 V	ADC_A0_raw: 16795	V_adc_a0: 3.149 V	ADC_A1_raw: 16724	V_adc_a1: 3.136 V
Position: 63	DAC_Bits: 2605	V_set_dac: 3.181 V	V_set_pot: 3.182 V	ADC_A0_raw: 17066	V_adc_a0: 3.200 V	ADC_A1_raw: 16992	V_adc_a1: 3.186 V
Position: 64	DAC_Bits: 2647	V_set_dac: 3.232 V	V_set_pot: 3.232 V	ADC_A0_raw: 17336	V_adc_a0: 3.250 V	ADC_A1_raw: 17265	V_adc_a1: 3.237 V
Position: 65	DAC_Bits: 2688	V_set_dac: 3.282 V	V_set_pot: 3.283 V	ADC_A0_raw: 17609	V_adc_a0: 3.302 V	ADC_A1_raw: 17535	V_adc_a1: 3.288 V
Position: 66	DAC_Bits: 2730	V_set_dac: 3.333 V	V_set_pot: 3.333 V	ADC_A0_raw: 17880	V_adc_a0: 3.352 V	ADC_A1_raw: 17810	V_adc_a1: 3.339 V
Position: 67	DAC_Bits: 2771	V_set_dac: 3.383 V	V_set_pot: 3.384 V	ADC_A0_raw: 18153	V_adc_a0: 3.404 V	ADC_A1_raw: 18079	V_adc_a1: 3.390 V
Position: 68	DAC_Bits: 2812	V_set_dac: 3.433 V	V_set_pot: 3.434 V	ADC_A0_raw: 18427	V_adc_a0: 3.455 V	ADC_A1_raw: 18349	V_adc_a1: 3.440 V
Position: 69	DAC_Bits: 2854	V_set_dac: 3.485 V	V_set_pot: 3.485 V	ADC_A0_raw: 18698	V_adc_a0: 3.506 V	ADC_A1_raw: 18619	V_adc_a1: 3.491 V
Position: 70	DAC_Bits: 2895	V_set_dac: 3.535 V	V_set_pot: 3.535 V	ADC_A0_raw: 18969	V_adc_a0: 3.557 V	ADC_A1_raw: 18884	V_adc_a1: 3.541 V
Position: 71	DAC_Bits: 2936	V_set_dac: 3.585 V	V_set_pot: 3.586 V	ADC_A0_raw: 19240	V_adc_a0: 3.608 V	ADC_A1_raw: 19150	V_adc_a1: 3.591 V
Position: 72	DAC_Bits: 2978	V_set_dac: 3.636 V	V_set_pot: 3.636 V	ADC_A0_raw: 19503	V_adc_a0: 3.657 V	ADC_A1_raw: 19421	V_adc_a1: 3.641 V
Position: 73	DAC_Bits: 3019	V_set_dac: 3.686 V	V_set_pot: 3.687 V	ADC_A0_raw: 19759	V_adc_a0: 3.705 V	ADC_A1_raw: 19685	V_adc_a1: 3.691 V
Position: 74	DAC_Bits: 3060	V_set_dac: 3.736 V	V_set_pot: 3.737 V	ADC_A0_raw: 19968	V_adc_a0: 3.744 V	ADC_A1_raw: 19928	V_adc_a1: 3.737 V
Position: 75	DAC_Bits: 3102	V_set_dac: 3.788 V	V_set_pot: 3.788 V	ADC_A0_raw: 20110	V_adc_a0: 3.771 V	ADC_A1_raw: 20117	V_adc_a1: 3.772 V
Position: 76	DAC_Bits: 3143	V_set_dac: 3.838 V	V_set_pot: 3.838 V	ADC_A0_raw: 20184	V_adc_a0: 3.785 V	ADC_A1_raw: 20217	V_adc_a1: 3.791 V
Position: 77	DAC_Bits: 3185	V_set_dac: 3.889 V	V_set_pot: 3.889 V	ADC_A0_raw: 20230	V_adc_a0: 3.793 V	ADC_A1_raw: 20250	V_adc_a1: 3.797 V
Position: 78	DAC_Bits: 3226	V_set_dac: 3.939 V	V_set_pot: 3.939 V	ADC_A0_raw: 20250	V_adc_a0: 3.797 V	ADC_A1_raw: 20250	V_adc_a1: 3.797 V
Position: 79	DAC_Bits: 3267	V_set_dac: 3.989 V	V_set_pot: 3.990 V	ADC_A0_raw: 20230	V_adc_a0: 3.793 V	ADC_A1_raw: 20230	V_adc_a1: 3.793 V
Position: 80	DAC_Bits: 3309	V_set_dac: 4.040 V	V_set_pot: 4.040 V	ADC_A0_raw: 20189	V_adc_a0: 3.785 V	ADC_A1_raw: 20149	V_adc_a1: 3.778 V
Position: 81	DAC_Bits: 3350	V_set_dac: 4.090 V	V_set_pot: 4.091 V	ADC_A0_raw: 20169	V_adc_a0: 3.782 V	ADC_A1_raw: 20108	V_adc_a1: 3.770 V
Position: 82	DAC_Bits: 3391	V_set_dac: 4.140 V	V_set_pot: 4.141 V	ADC_A0_raw: 20149	V_adc_a0: 3.778 V	ADC_A1_raw: 20007	V_adc_a1: 3.751 V
Position: 83	DAC_Bits: 3433	V_set_dac: 4.192 V	V_set_pot: 4.192 V	ADC_A0_raw: 20149	V_adc_a0: 3.778 V	ADC_A1_raw: 19987	V_adc_a1: 3.748 V
Position: 84	DAC_Bits: 3474	V_set_dac: 4.242 V	V_set_pot: 4.242 V	ADC_A0_raw: 20149	V_adc_a0: 3.778 V	ADC_A1_raw: 19967	V_adc_a1: 3.744 V
Position: 85	DAC_Bits: 3515	V_set_dac: 4.292 V	V_set_pot: 4.293 V	ADC_A0_raw: 20129	V_adc_a0: 3.774 V	ADC_A1_raw: 19946	V_adc_a1: 3.740 V
Position: 86	DAC_Bits: 3557	V_set_dac: 4.343 V	V_set_pot: 4.343 V	ADC_A0_raw: 20108	V_adc_a0: 3.770 V	ADC_A1_raw: 19946	V_adc_a1: 3.740 V
Position: 87	DAC_Bits: 3598	V_set_dac: 4.393 V	V_set_pot: 4.394 V	ADC_A0_raw: 20088	V_adc_a0: 3.766 V	ADC_A1_raw: 19926	V_adc_a1: 3.736 V
Position: 88	DAC_Bits: 3640	V_set_dac: 4.444 V	V_set_pot: 4.444 V	ADC_A0_raw: 20088	V_adc_a0: 3.766 V	ADC_A1_raw: 19926	V_adc_a1: 3.736 V
Position: 89	DAC_Bits: 3681	V_set_dac: 4.495 V	V_set_pot: 4.495 V	ADC_A0_raw: 20088	V_adc_a0: 3.766 V	ADC_A1_raw: 19906	V_adc_a1: 3.732 V
Position: 90	DAC_Bits: 3722	V_set_dac: 4.545 V	V_set_pot: 4.545 V	ADC_A0_raw: 20088	V_adc_a0: 3.766 V	ADC_A1_raw: 19906	V_adc_a1: 3.732 V
Position: 91	DAC_Bits: 3764	V_set_dac: 4.596 V	V_set_pot: 4.596 V	ADC_A0_raw: 20048	V_adc_a0: 3.759 V	ADC_A1_raw: 19886	V_adc_a1: 3.729 V
Position: 92	DAC_Bits: 3805	V_set_dac: 4.646 V	V_set_pot: 4.646 V	ADC_A0_raw: 20027	V_adc_a0: 3.755 V	ADC_A1_raw: 19865	V_adc_a1: 3.725 V
Position: 93	DAC_Bits: 3846	V_set_dac: 4.696 V	V_set_pot: 4.697 V	ADC_A0_raw: 19987	V_adc_a0: 3.748 V	ADC_A1_raw: 19865	V_adc_a1: 3.725 V
Position: 94	DAC_Bits: 3888	V_set_dac: 4.747 V	V_set_pot: 4.747 V	ADC_A0_raw: 19967	V_adc_a0: 3.744 V	ADC_A1_raw: 19865	V_adc_a1: 3.725 V
Position: 95	DAC_Bits: 3929	V_set_dac: 4.797 V	V_set_pot: 4.798 V	ADC_A0_raw: 19946	V_adc_a0: 3.740 V	ADC_A1_raw: 19845	V_adc_a1: 3.721 V
Position: 96	DAC_Bits: 3970	V_set_dac: 4.847 V	V_set_pot: 4.848 V	ADC_A0_raw: 19926	V_adc_a0: 3.736 V	ADC_A1_raw: 19825	V_adc_a1: 3.717 V
Position: 97	DAC_Bits: 4012	V_set_dac: 4.899 V	V_set_pot: 4.899 V	ADC_A0_raw: 19886	V_adc_a0: 3.729 V	ADC_A1_raw: 19805	V_adc_a1: 3.713 V
Position: 98	DAC_Bits: 4053	V_set_dac: 4.949 V	V_set_pot: 4.949 V	ADC_A0_raw: 19825	V_adc_a0: 3.717 V	ADC_A1_raw: 19784	V_adc_a1: 3.710 V
Position: 99	DAC_Bits: 4095	V_set_dac: 5.000 V	V_set_pot: 5.000 V	ADC_A0_raw: 19541	V_adc_a0: 3.664 V	ADC_A1_raw: 19703	V_adc_a1: 3.694 V
Position: 99	DAC_Bits: 4095	V_set_dac: 5.000 V	V_set_pot: 5.000 V	ADC_A0_raw: 19602	V_adc_a0: 3.675 V	ADC_A1_raw: 19724	V_adc_a1: 3.698 V
Position: 98	DAC_Bits: 4053	V_set_dac: 4.949 V	V_set_pot: 4.949 V	ADC_A0_raw: 19805	V_adc_a0: 3.713 V	ADC_A1_raw: 19784	V_adc_a1: 3.710 V
Position: 97	DAC_Bits: 4012	V_set_dac: 4.899 V	V_set_pot: 4.899 V	ADC_A0_raw: 19865	V_adc_a0: 3.725 V	ADC_A1_raw: 19784	V_adc_a1: 3.710 V
Position: 96	DAC_Bits: 3970	V_set_dac: 4.847 V	V_set_pot: 4.848 V	ADC_A0_raw: 19886	V_adc_a0: 3.729 V	ADC_A1_raw: 19825	V_adc_a1: 3.717 V
Position: 95	DAC_Bits: 3929	V_set_dac: 4.797 V	V_set_pot: 4.798 V	ADC_A0_raw: 19926	V_adc_a0: 3.736 V	ADC_A1_raw: 19845	V_adc_a1: 3.721 V
Position: 94	DAC_Bits: 3888	V_set_dac: 4.747 V	V_set_pot: 4.747 V	ADC_A0_raw: 19967	V_adc_a0: 3.744 V	ADC_A1_raw: 19845	V_adc_a1: 3.721 V
Position: 93	DAC_Bits: 3846	V_set_dac: 4.696 V	V_set_pot: 4.697 V	ADC_A0_raw: 19987	V_adc_a0: 3.748 V	ADC_A1_raw: 19845	V_adc_a1: 3.721 V
Position: 92	DAC_Bits: 3805	V_set_dac: 4.646 V	V_set_pot: 4.646 V	ADC_A0_raw: 20007	V_adc_a0: 3.751 V	ADC_A1_raw: 19865	V_adc_a1: 3.725 V
Position: 91	DAC_Bits: 3764	V_set_dac: 4.596 V	V_set_pot: 4.596 V	ADC_A0_raw: 20048	V_adc_a0: 3.759 V	ADC_A1_raw: 19886	V_adc_a1: 3.729 V
Position: 90	DAC_Bits: 3722	V_set_dac: 4.545 V	V_set_pot: 4.545 V	ADC_A0_raw: 20088	V_adc_a0: 3.766 V	ADC_A1_raw: 19886	V_adc_a1: 3.729 V
Position: 89	DAC_Bits: 3681	V_set_dac: 4.495 V	V_set_pot: 4.495 V	ADC_A0_raw: 20088	V_adc_a0: 3.766 V	ADC_A1_raw: 19906	V_adc_a1: 3.732 V
Position: 88	DAC_Bits: 3640	V_set_dac: 4.444 V	V_set_pot: 4.444 V	ADC_A0_raw: 20088	V_adc_a0: 3.766 V	ADC_A1_raw: 19906	V_adc_a1: 3.732 V
Position: 87	DAC_Bits: 3598	V_set_dac: 4.393 V	V_set_pot: 4.394 V	ADC_A0_raw: 20068	V_adc_a0: 3.763 V	ADC_A1_raw: 19926	V_adc_a1: 3.736 V
Position: 86	DAC_Bits: 3557	V_set_dac: 4.343 V	V_set_pot: 4.343 V	ADC_A0_raw: 20048	V_adc_a0: 3.759 V	ADC_A1_raw: 19926	V_adc_a1: 3.736 V
Position: 85	DAC_Bits: 3515	V_set_dac: 4.292 V	V_set_pot: 4.293 V	ADC_A0_raw: 20088	V_adc_a0: 3.766 V	ADC_A1_raw: 19946	V_adc_a1: 3.740 V
Position: 84	DAC_Bits: 3474	V_set_dac: 4.242 V	V_set_pot: 4.242 V	ADC_A0_raw: 20088	V_adc_a0: 3.766 V	ADC_A1_raw: 19946	V_adc_a1: 3.740 V
Position: 83	DAC_Bits: 3433	V_set_dac: 4.192 V	V_set_pot: 4.192 V	ADC_A0_raw: 20129	V_adc_a0: 3.774 V	ADC_A1_raw: 19967	V_adc_a1: 3.744 V
Position: 82	DAC_Bits: 3391	V_set_dac: 4.140 V	V_set_pot: 4.141 V	ADC_A0_raw: 20129	V_adc_a0: 3.774 V	ADC_A1_raw: 19987	V_adc_a1: 3.748 V
Position: 81	DAC_Bits: 3350	V_set_dac: 4.090 V	V_set_pot: 4.091 V	ADC_A0_raw: 20129	V_adc_a0: 3.774 V	ADC_A1_raw: 20088	V_adc_a1: 3.766 V
Position: 80	DAC_Bits: 3309	V_set_dac: 4.040 V	V_set_pot: 4.040 V	ADC_A0_raw: 20169	V_adc_a0: 3.782 V	ADC_A1_raw: 20129	V_adc_a1: 3.774 V
Position: 79	DAC_Bits: 3267	V_set_dac: 3.989 V	V_set_pot: 3.990 V	ADC_A0_raw: 20210	V_adc_a0: 3.789 V	ADC_A1_raw: 20189	V_adc_a1: 3.785 V
Position: 78	DAC_Bits: 3226	V_set_dac: 3.939 V	V_set_pot: 3.939 V	ADC_A0_raw: 20210	V_adc_a0: 3.789 V	ADC_A1_raw: 20230	V_adc_a1: 3.793 V
Position: 77	DAC_Bits: 3185	V_set_dac: 3.889 V	V_set_pot: 3.889 V	ADC_A0_raw: 20189	V_adc_a0: 3.785 V	ADC_A1_raw: 20230	V_adc_a1: 3.793 V
Position: 76	DAC_Bits: 3143	V_set_dac: 3.838 V	V_set_pot: 3.838 V	ADC_A0_raw: 20168	V_adc_a0: 3.782 V	ADC_A1_raw: 20204	V_adc_a1: 3.788 V
Position: 75	DAC_Bits: 3102	V_set_dac: 3.788 V	V_set_pot: 3.788 V	ADC_A0_raw: 20098	V_adc_a0: 3.768 V	ADC_A1_raw: 20108	V_adc_a1: 3.770 V
Position: 74	DAC_Bits: 3060	V_set_dac: 3.736 V	V_set_pot: 3.737 V	ADC_A0_raw: 19963	V_adc_a0: 3.743 V	ADC_A1_raw: 19926	V_adc_a1: 3.736 V
Position: 73	DAC_Bits: 3019	V_set_dac: 3.686 V	V_set_pot: 3.687 V	ADC_A0_raw: 19757	V_adc_a0: 3.704 V	ADC_A1_raw: 19685	V_adc_a1: 3.691 V
Position: 72	DAC_Bits: 2978	V_set_dac: 3.636 V	V_set_pot: 3.636 V	ADC_A0_raw: 19505	V_adc_a0: 3.657 V	ADC_A1_raw: 19424	V_adc_a1: 3.642 V
Position: 71	DAC_Bits: 2936	V_set_dac: 3.585 V	V_set_pot: 3.586 V	ADC_A0_raw: 19239	V_adc_a0: 3.607 V	ADC_A1_raw: 19151	V_adc_a1: 3.591 V
Position: 70	DAC_Bits: 2895	V_set_dac: 3.535 V	V_set_pot: 3.535 V	ADC_A0_raw: 18967	V_adc_a0: 3.556 V	ADC_A1_raw: 18885	V_adc_a1: 3.541 V
Position: 69	DAC_Bits: 2854	V_set_dac: 3.485 V	V_set_pot: 3.485 V	ADC_A0_raw: 18696	V_adc_a0: 3.506 V	ADC_A1_raw: 18620	V_adc_a1: 3.491 V
Position: 68	DAC_Bits: 2812	V_set_dac: 3.433 V	V_set_pot: 3.434 V	ADC_A0_raw: 18425	V_adc_a0: 3.455 V	ADC_A1_raw: 18349	V_adc_a1: 3.440 V
Position: 67	DAC_Bits: 2771	V_set_dac: 3.383 V	V_set_pot: 3.384 V	ADC_A0_raw: 18153	V_adc_a0: 3.404 V	ADC_A1_raw: 18081	V_adc_a1: 3.390 V
Position: 66	DAC_Bits: 2730	V_set_dac: 3.333 V	V_set_pot: 3.333 V	ADC_A0_raw: 17881	V_adc_a0: 3.353 V	ADC_A1_raw: 17814	V_adc_a1: 3.340 V
Position: 65	DAC_Bits: 2688	V_set_dac: 3.282 V	V_set_pot: 3.283 V	ADC_A0_raw: 17613	V_adc_a0: 3.302 V	ADC_A1_raw: 17536	V_adc_a1: 3.288 V
Position: 64	DAC_Bits: 2647	V_set_dac: 3.232 V	V_set_pot: 3.232 V	ADC_A0_raw: 17343	V_adc_a0: 3.252 V	ADC_A1_raw: 17267	V_adc_a1: 3.238 V
Position: 63	DAC_Bits: 2605	V_set_dac: 3.181 V	V_set_pot: 3.182 V	ADC_A0_raw: 17066	V_adc_a0: 3.200 V	ADC_A1_raw: 16993	V_adc_a1: 3.186 V
Position: 62	DAC_Bits: 2564	V_set_dac: 3.131 V	V_set_pot: 3.131 V	ADC_A0_raw: 16795	V_adc_a0: 3.149 V	ADC_A1_raw: 16724	V_adc_a1: 3.136 V
Position: 61	DAC_Bits: 2523	V_set_dac: 3.081 V	V_set_pot: 3.081 V	ADC_A0_raw: 16529	V_adc_a0: 3.099 V	ADC_A1_raw: 16451	V_adc_a1: 3.085 V
Position: 60	DAC_Bits: 2481	V_set_dac: 3.029 V	V_set_pot: 3.030 V	ADC_A0_raw: 16251	V_adc_a0: 3.047 V	ADC_A1_raw: 16168	V_adc_a1: 3.032 V
Position: 59	DAC_Bits: 2440	V_set_dac: 2.979 V	V_set_pot: 2.980 V	ADC_A0_raw: 15982	V_adc_a0: 2.997 V	ADC_A1_raw: 15897	V_adc_a1: 2.981 V
Position: 58	DAC_Bits: 2399	V_set_dac: 2.929 V	V_set_pot: 2.929 V	ADC_A0_raw: 15714	V_adc_a0: 2.946 V	ADC_A1_raw: 15628	V_adc_a1: 2.930 V
Position: 57	DAC_Bits: 2357	V_set_dac: 2.878 V	V_set_pot: 2.879 V	ADC_A0_raw: 15437	V_adc_a0: 2.894 V	ADC_A1_raw: 15351	V_adc_a1: 2.878 V
Position: 56	DAC_Bits: 2316	V_set_dac: 2.828 V	V_set_pot: 2.828 V	ADC_A0_raw: 15164	V_adc_a0: 2.843 V	ADC_A1_raw: 15087	V_adc_a1: 2.829 V
Position: 55	DAC_Bits: 2275	V_set_dac: 2.778 V	V_set_pot: 2.778 V	ADC_A0_raw: 14894	V_adc_a0: 2.793 V	ADC_A1_raw: 14818	V_adc_a1: 2.778 V
Position: 54	DAC_Bits: 2233	V_set_dac: 2.726 V	V_set_pot: 2.727 V	ADC_A0_raw: 14620	V_adc_a0: 2.741 V	ADC_A1_raw: 14542	V_adc_a1: 2.727 V
Position: 53	DAC_Bits: 2192	V_set_dac: 2.676 V	V_set_pot: 2.677 V	ADC_A0_raw: 14349	V_adc_a0: 2.690 V	ADC_A1_raw: 14279	V_adc_a1: 2.677 V
Position: 52	DAC_Bits: 2150	V_set_dac: 2.625 V	V_set_pot: 2.626 V	ADC_A0_raw: 14076	V_adc_a0: 2.639 V	ADC_A1_raw: 14002	V_adc_a1: 2.625 V
Position: 51	DAC_Bits: 2109	V_set_dac: 2.575 V	V_set_pot: 2.576 V	ADC_A0_raw: 13806	V_adc_a0: 2.589 V	ADC_A1_raw: 13730	V_adc_a1: 2.574 V
Position: 50	DAC_Bits: 2068	V_set_dac: 2.525 V	V_set_pot: 2.525 V	ADC_A0_raw: 13531	V_adc_a0: 2.537 V	ADC_A1_raw: 13461	V_adc_a1: 2.524 V
Position: 49	DAC_Bits: 2026	V_set_dac: 2.474 V	V_set_pot: 2.475 V	ADC_A0_raw: 13260	V_adc_a0: 2.486 V	ADC_A1_raw: 13182	V_adc_a1: 2.472 V
Position: 48	DAC_Bits: 1985	V_set_dac: 2.424 V	V_set_pot: 2.424 V	ADC_A0_raw: 12987	V_adc_a0: 2.435 V	ADC_A1_raw: 12908	V_adc_a1: 2.420 V
Position: 47	DAC_Bits: 1944	V_set_dac: 2.374 V	V_set_pot: 2.374 V	ADC_A0_raw: 12720	V_adc_a0: 2.385 V	ADC_A1_raw: 12644	V_adc_a1: 2.371 V
Position: 46	DAC_Bits: 1902	V_set_dac: 2.322 V	V_set_pot: 2.323 V	ADC_A0_raw: 12446	V_adc_a0: 2.334 V	ADC_A1_raw: 12371	V_adc_a1: 2.320 V
Position: 45	DAC_Bits: 1861	V_set_dac: 2.272 V	V_set_pot: 2.273 V	ADC_A0_raw: 12179	V_adc_a0: 2.284 V	ADC_A1_raw: 12105	V_adc_a1: 2.270 V
Position: 44	DAC_Bits: 1820	V_set_dac: 2.222 V	V_set_pot: 2.222 V	ADC_A0_raw: 11909	V_adc_a0: 2.233 V	ADC_A1_raw: 11837	V_adc_a1: 2.219 V
Position: 43	DAC_Bits: 1778	V_set_dac: 2.171 V	V_set_pot: 2.172 V	ADC_A0_raw: 11634	V_adc_a0: 2.181 V	ADC_A1_raw: 11562	V_adc_a1: 2.168 V
Position: 42	DAC_Bits: 1737	V_set_dac: 2.121 V	V_set_pot: 2.121 V	ADC_A0_raw: 11368	V_adc_a0: 2.132 V	ADC_A1_raw: 11299	V_adc_a1: 2.119 V
Position: 41	DAC_Bits: 1695	V_set_dac: 2.070 V	V_set_pot: 2.071 V	ADC_A0_raw: 11100	V_adc_a0: 2.081 V	ADC_A1_raw: 11025	V_adc_a1: 2.067 V
Position: 40	DAC_Bits: 1654	V_set_dac: 2.020 V	V_set_pot: 2.020 V	ADC_A0_raw: 10826	V_adc_a0: 2.030 V	ADC_A1_raw: 10757	V_adc_a1: 2.017 V
Position: 39	DAC_Bits: 1613	V_set_dac: 1.969 V	V_set_pot: 1.970 V	ADC_A0_raw: 10557	V_adc_a0: 1.979 V	ADC_A1_raw: 10495	V_adc_a1: 1.968 V
Position: 38	DAC_Bits: 1571	V_set_dac: 1.918 V	V_set_pot: 1.919 V	ADC_A0_raw: 10286	V_adc_a0: 1.929 V	ADC_A1_raw: 10225	V_adc_a1: 1.917 V
Position: 37	DAC_Bits: 1530	V_set_dac: 1.868 V	V_set_pot: 1.869 V	ADC_A0_raw: 10016	V_adc_a0: 1.878 V	ADC_A1_raw: 9962	V_adc_a1: 1.868 V
Position: 36	DAC_Bits: 1489	V_set_dac: 1.818 V	V_set_pot: 1.818 V	ADC_A0_raw: 9748	V_adc_a0: 1.828 V	ADC_A1_raw: 9691	V_adc_a1: 1.817 V
Position: 35	DAC_Bits: 1447	V_set_dac: 1.767 V	V_set_pot: 1.768 V	ADC_A0_raw: 9476	V_adc_a0: 1.777 V	ADC_A1_raw: 9416	V_adc_a1: 1.766 V
Position: 34	DAC_Bits: 1406	V_set_dac: 1.717 V	V_set_pot: 1.717 V	ADC_A0_raw: 9205	V_adc_a0: 1.726 V	ADC_A1_raw: 9147	V_adc_a1: 1.715 V
Position: 33	DAC_Bits: 1365	V_set_dac: 1.667 V	V_set_pot: 1.667 V	ADC_A0_raw: 8932	V_adc_a0: 1.675 V	ADC_A1_raw: 8878	V_adc_a1: 1.665 V
Position: 32	DAC_Bits: 1323	V_set_dac: 1.615 V	V_set_pot: 1.616 V	ADC_A0_raw: 8657	V_adc_a0: 1.623 V	ADC_A1_raw: 8605	V_adc_a1: 1.613 V
Position: 31	DAC_Bits: 1282	V_set_dac: 1.565 V	V_set_pot: 1.566 V	ADC_A0_raw: 8386	V_adc_a0: 1.572 V	ADC_A1_raw: 8340	V_adc_a1: 1.564 V
Position: 30	DAC_Bits: 1240	V_set_dac: 1.514 V	V_set_pot: 1.515 V	ADC_A0_raw: 8120	V_adc_a0: 1.523 V	ADC_A1_raw: 8069	V_adc_a1: 1.513 V
Position: 29	DAC_Bits: 1199	V_set_dac: 1.464 V	V_set_pot: 1.465 V	ADC_A0_raw: 7850	V_adc_a0: 1.472 V	ADC_A1_raw: 7804	V_adc_a1: 1.463 V
Position: 28	DAC_Bits: 1158	V_set_dac: 1.414 V	V_set_pot: 1.414 V	ADC_A0_raw: 7579	V_adc_a0: 1.421 V	ADC_A1_raw: 7538	V_adc_a1: 1.413 V
Position: 27	DAC_Bits: 1116	V_set_dac: 1.363 V	V_set_pot: 1.364 V	ADC_A0_raw: 7306	V_adc_a0: 1.370 V	ADC_A1_raw: 7265	V_adc_a1: 1.362 V
Position: 26	DAC_Bits: 1075	V_set_dac: 1.313 V	V_set_pot: 1.313 V	ADC_A0_raw: 7036	V_adc_a0: 1.319 V	ADC_A1_raw: 6998	V_adc_a1: 1.312 V
Position: 25	DAC_Bits: 1034	V_set_dac: 1.263 V	V_set_pot: 1.263 V	ADC_A0_raw: 6765	V_adc_a0: 1.268 V	ADC_A1_raw: 6730	V_adc_a1: 1.262 V
Position: 24	DAC_Bits: 992	V_set_dac: 1.211 V	V_set_pot: 1.212 V	ADC_A0_raw: 6492	V_adc_a0: 1.217 V	ADC_A1_raw: 6448	V_adc_a1: 1.209 V
Position: 23	DAC_Bits: 951	V_set_dac: 1.161 V	V_set_pot: 1.162 V	ADC_A0_raw: 6224	V_adc_a0: 1.167 V	ADC_A1_raw: 6175	V_adc_a1: 1.158 V
Position: 22	DAC_Bits: 910	V_set_dac: 1.111 V	V_set_pot: 1.111 V	ADC_A0_raw: 5957	V_adc_a0: 1.117 V	ADC_A1_raw: 5912	V_adc_a1: 1.109 V
Position: 21	DAC_Bits: 868	V_set_dac: 1.060 V	V_set_pot: 1.061 V	ADC_A0_raw: 5686	V_adc_a0: 1.066 V	ADC_A1_raw: 5637	V_adc_a1: 1.057 V
Position: 20	DAC_Bits: 827	V_set_dac: 1.010 V	V_set_pot: 1.010 V	ADC_A0_raw: 5412	V_adc_a0: 1.015 V	ADC_A1_raw: 5368	V_adc_a1: 1.007 V
Position: 19	DAC_Bits: 785	V_set_dac: 0.958 V	V_set_pot: 0.960 V	ADC_A0_raw: 5140	V_adc_a0: 0.964 V	ADC_A1_raw: 5094	V_adc_a1: 0.955 V
Position: 18	DAC_Bits: 744	V_set_dac: 0.908 V	V_set_pot: 0.909 V	ADC_A0_raw: 4872	V_adc_a0: 0.914 V	ADC_A1_raw: 4828	V_adc_a1: 0.905 V
Position: 17	DAC_Bits: 703	V_set_dac: 0.858 V	V_set_pot: 0.859 V	ADC_A0_raw: 4598	V_adc_a0: 0.862 V	ADC_A1_raw: 4564	V_adc_a1: 0.856 V
Position: 16	DAC_Bits: 661	V_set_dac: 0.807 V	V_set_pot: 0.808 V	ADC_A0_raw: 4329	V_adc_a0: 0.812 V	ADC_A1_raw: 4294	V_adc_a1: 0.805 V
Position: 15	DAC_Bits: 620	V_set_dac: 0.757 V	V_set_pot: 0.758 V	ADC_A0_raw: 4053	V_adc_a0: 0.760 V	ADC_A1_raw: 4029	V_adc_a1: 0.755 V
Position: 14	DAC_Bits: 579	V_set_dac: 0.707 V	V_set_pot: 0.707 V	ADC_A0_raw: 3785	V_adc_a0: 0.710 V	ADC_A1_raw: 3763	V_adc_a1: 0.706 V
Position: 13	DAC_Bits: 537	V_set_dac: 0.656 V	V_set_pot: 0.657 V	ADC_A0_raw: 3514	V_adc_a0: 0.659 V	ADC_A1_raw: 3491	V_adc_a1: 0.655 V
Position: 12	DAC_Bits: 496	V_set_dac: 0.606 V	V_set_pot: 0.606 V	ADC_A0_raw: 3245	V_adc_a0: 0.608 V	ADC_A1_raw: 3221	V_adc_a1: 0.604 V
Position: 11	DAC_Bits: 455	V_set_dac: 0.556 V	V_set_pot: 0.556 V	ADC_A0_raw: 2974	V_adc_a0: 0.558 V	ADC_A1_raw: 2948	V_adc_a1: 0.553 V
Position: 10	DAC_Bits: 413	V_set_dac: 0.504 V	V_set_pot: 0.505 V	ADC_A0_raw: 2703	V_adc_a0: 0.507 V	ADC_A1_raw: 2677	V_adc_a1: 0.502 V
Position: 9	DAC_Bits: 372	V_set_dac: 0.454 V	V_set_pot: 0.455 V	ADC_A0_raw: 2433	V_adc_a0: 0.456 V	ADC_A1_raw: 2413	V_adc_a1: 0.452 V
Position: 8	DAC_Bits: 330	V_set_dac: 0.403 V	V_set_pot: 0.404 V	ADC_A0_raw: 2163	V_adc_a0: 0.406 V	ADC_A1_raw: 2144	V_adc_a1: 0.402 V
Position: 7	DAC_Bits: 289	V_set_dac: 0.353 V	V_set_pot: 0.354 V	ADC_A0_raw: 1892	V_adc_a0: 0.355 V	ADC_A1_raw: 1878	V_adc_a1: 0.352 V
Position: 6	DAC_Bits: 248	V_set_dac: 0.303 V	V_set_pot: 0.303 V	ADC_A0_raw: 1620	V_adc_a0: 0.304 V	ADC_A1_raw: 1611	V_adc_a1: 0.302 V
Position: 5	DAC_Bits: 206	V_set_dac: 0.252 V	V_set_pot: 0.253 V	ADC_A0_raw: 1348	V_adc_a0: 0.253 V	ADC_A1_raw: 1339	V_adc_a1: 0.251 V
Position: 4	DAC_Bits: 165	V_set_dac: 0.201 V	V_set_pot: 0.202 V	ADC_A0_raw: 1078	V_adc_a0: 0.202 V	ADC_A1_raw: 1070	V_adc_a1: 0.201 V
Position: 3	DAC_Bits: 124	V_set_dac: 0.151 V	V_set_pot: 0.152 V	ADC_A0_raw: 808	V_adc_a0: 0.152 V	ADC_A1_raw: 799	V_adc_a1: 0.150 V
Position: 2	DAC_Bits: 82	V_set_dac: 0.100 V	V_set_pot: 0.101 V	ADC_A0_raw: 536	V_adc_a0: 0.101 V	ADC_A1_raw: 527	V_adc_a1: 0.099 V
Position: 1	DAC_Bits: 41	V_set_dac: 0.050 V	V_set_pot: 0.051 V	ADC_A0_raw: 264	V_adc_a0: 0.049 V	ADC_A1_raw: 263	V_adc_a1: 0.049 V
Position: 0	DAC_Bits: 0	V_set_dac: 0.000 V	V_set_pot: 0.000 V	ADC_A0_raw: -7	V_adc_a0: -0.001 V	ADC_A1_raw: -1	V_adc_a1: -0.000 V
Position: 0	DAC_Bits: 0	V_set_dac: 0.000 V	V_set_pot: 0.000 V	ADC_A0_raw: -6	V_adc_a0: -0.001 V	ADC_A1_raw: 0	V_adc_a1: 0.000 V
Position: 1	DAC_Bits: 41	V_set_dac: 0.050 V	V_set_pot: 0.051 V	ADC_A0_raw: 263	V_adc_a0: 0.049 V	ADC_A1_raw: 263	V_adc_a1: 0.049 V
Position: 2	DAC_Bits: 82	V_set_dac: 0.100 V	V_set_pot: 0.101 V	ADC_A0_raw: 535	V_adc_a0: 0.100 V	ADC_A1_raw: 528	V_adc_a1: 0.099 V
Position: 3	DAC_Bits: 124	V_set_dac: 0.151 V	V_set_pot: 0.152 V	ADC_A0_raw: 807	V_adc_a0: 0.151 V	ADC_A1_raw: 799	V_adc_a1: 0.150 V
Position: 4	DAC_Bits: 165	V_set_dac: 0.201 V	V_set_pot: 0.202 V	ADC_A0_raw: 1078	V_adc_a0: 0.202 V	ADC_A1_raw: 1070	V_adc_a1: 0.201 V
Position: 5	DAC_Bits: 206	V_set_dac: 0.252 V	V_set_pot: 0.253 V	ADC_A0_raw: 1346	V_adc_a0: 0.252 V	ADC_A1_raw: 1339	V_adc_a1: 0.251 V
Position: 6	DAC_Bits: 248	V_set_dac: 0.303 V	V_set_pot: 0.303 V	ADC_A0_raw: 1620	V_adc_a0: 0.304 V	ADC_A1_raw: 1611	V_adc_a1: 0.302 V
Position: 7	DAC_Bits: 289	V_set_dac: 0.353 V	V_set_pot: 0.354 V	ADC_A0_raw: 1892	V_adc_a0: 0.355 V	ADC_A1_raw: 1878	V_adc_a1: 0.352 V
Position: 8	DAC_Bits: 330	V_set_dac: 0.403 V	V_set_pot: 0.404 V	ADC_A0_raw: 2162	V_adc_a0: 0.405 V	ADC_A1_raw: 2143	V_adc_a1: 0.402 V
Position: 9	DAC_Bits: 372	V_set_dac: 0.454 V	V_set_pot: 0.455 V	ADC_A0_raw: 2435	V_adc_a0: 0.457 V	ADC_A1_raw: 2413	V_adc_a1: 0.452 V
Position: 10	DAC_Bits: 413	V_set_dac: 0.504 V	V_set_pot: 0.505 V	ADC_A0_raw: 2703	V_adc_a0: 0.507 V	ADC_A1_raw: 2677	V_adc_a1: 0.502 V
Position: 11	DAC_Bits: 455	V_set_dac: 0.556 V	V_set_pot: 0.556 V	ADC_A0_raw: 2975	V_adc_a0: 0.558 V	ADC_A1_raw: 2947	V_adc_a1: 0.553 V
Position: 12	DAC_Bits: 496	V_set_dac: 0.606 V	V_set_pot: 0.606 V	ADC_A0_raw: 3249	V_adc_a0: 0.609 V	ADC_A1_raw: 3220	V_adc_a1: 0.604 V
Position: 13	DAC_Bits: 537	V_set_dac: 0.656 V	V_set_pot: 0.657 V	ADC_A0_raw: 3514	V_adc_a0: 0.659 V	ADC_A1_raw: 3490	V_adc_a1: 0.654 V
Position: 14	DAC_Bits: 579	V_set_dac: 0.707 V	V_set_pot: 0.707 V	ADC_A0_raw: 3786	V_adc_a0: 0.710 V	ADC_A1_raw: 3764	V_adc_a1: 0.706 V
Position: 15	DAC_Bits: 620	V_set_dac: 0.757 V	V_set_pot: 0.758 V	ADC_A0_raw: 4055	V_adc_a0: 0.760 V	ADC_A1_raw: 4029	V_adc_a1: 0.755 V
Position: 16	DAC_Bits: 661	V_set_dac: 0.807 V	V_set_pot: 0.808 V	ADC_A0_raw: 4331	V_adc_a0: 0.812 V	ADC_A1_raw: 4294	V_adc_a1: 0.805 V
Position: 17	DAC_Bits: 703	V_set_dac: 0.858 V	V_set_pot: 0.859 V	ADC_A0_raw: 4596	V_adc_a0: 0.862 V	ADC_A1_raw: 4564	V_adc_a1: 0.856 V
Position: 18	DAC_Bits: 744	V_set_dac: 0.908 V	V_set_pot: 0.909 V	ADC_A0_raw: 4873	V_adc_a0: 0.914 V	ADC_A1_raw: 4828	V_adc_a1: 0.905 V
Position: 19	DAC_Bits: 785	V_set_dac: 0.958 V	V_set_pot: 0.960 V	ADC_A0_raw: 5142	V_adc_a0: 0.964 V	ADC_A1_raw: 5094	V_adc_a1: 0.955 V
Position: 20	DAC_Bits: 827	V_set_dac: 1.010 V	V_set_pot: 1.010 V	ADC_A0_raw: 5412	V_adc_a0: 1.015 V	ADC_A1_raw: 5368	V_adc_a1: 1.007 V
Position: 21	DAC_Bits: 868	V_set_dac: 1.060 V	V_set_pot: 1.061 V	ADC_A0_raw: 5682	V_adc_a0: 1.065 V	ADC_A1_raw: 5637	V_adc_a1: 1.057 V
Position: 22	DAC_Bits: 910	V_set_dac: 1.111 V	V_set_pot: 1.111 V	ADC_A0_raw: 5954	V_adc_a0: 1.116 V	ADC_A1_raw: 5912	V_adc_a1: 1.109 V
Position: 23	DAC_Bits: 951	V_set_dac: 1.161 V	V_set_pot: 1.162 V	ADC_A0_raw: 6227	V_adc_a0: 1.168 V	ADC_A1_raw: 6176	V_adc_a1: 1.158 V
Position: 24	DAC_Bits: 992	V_set_dac: 1.211 V	V_set_pot: 1.212 V	ADC_A0_raw: 6497	V_adc_a0: 1.218 V	ADC_A1_raw: 6449	V_adc_a1: 1.209 V
Position: 25	DAC_Bits: 1034	V_set_dac: 1.263 V	V_set_pot: 1.263 V	ADC_A0_raw: 6766	V_adc_a0: 1.269 V	ADC_A1_raw: 6731	V_adc_a1: 1.262 V
Position: 26	DAC_Bits: 1075	V_set_dac: 1.313 V	V_set_pot: 1.313 V	ADC_A0_raw: 7035	V_adc_a0: 1.319 V	ADC_A1_raw: 6998	V_adc_a1: 1.312 V
Position: 27	DAC_Bits: 1116	V_set_dac: 1.363 V	V_set_pot: 1.364 V	ADC_A0_raw: 7306	V_adc_a0: 1.370 V	ADC_A1_raw: 7266	V_adc_a1: 1.362 V
Position: 28	DAC_Bits: 1158	V_set_dac: 1.414 V	V_set_pot: 1.414 V	ADC_A0_raw: 7583	V_adc_a0: 1.422 V	ADC_A1_raw: 7540	V_adc_a1: 1.414 V
Position: 29	DAC_Bits: 1199	V_set_dac: 1.464 V	V_set_pot: 1.465 V	ADC_A0_raw: 7851	V_adc_a0: 1.472 V	ADC_A1_raw: 7805	V_adc_a1: 1.463 V
Position: 30	DAC_Bits: 1240	V_set_dac: 1.514 V	V_set_pot: 1.515 V	ADC_A0_raw: 8119	V_adc_a0: 1.522 V	ADC_A1_raw: 8070	V_adc_a1: 1.513 V
Position: 31	DAC_Bits: 1282	V_set_dac: 1.565 V	V_set_pot: 1.566 V	ADC_A0_raw: 8389	V_adc_a0: 1.573 V	ADC_A1_raw: 8340	V_adc_a1: 1.564 V
Position: 32	DAC_Bits: 1323	V_set_dac: 1.615 V	V_set_pot: 1.616 V	ADC_A0_raw: 8661	V_adc_a0: 1.624 V	ADC_A1_raw: 8607	V_adc_a1: 1.614 V
Position: 33	DAC_Bits: 1365	V_set_dac: 1.667 V	V_set_pot: 1.667 V	ADC_A0_raw: 8929	V_adc_a0: 1.674 V	ADC_A1_raw: 8879	V_adc_a1: 1.665 V
Position: 34	DAC_Bits: 1406	V_set_dac: 1.717 V	V_set_pot: 1.717 V	ADC_A0_raw: 9202	V_adc_a0: 1.725 V	ADC_A1_raw: 9149	V_adc_a1: 1.715 V
Position: 35	DAC_Bits: 1447	V_set_dac: 1.767 V	V_set_pot: 1.768 V	ADC_A0_raw: 9476	V_adc_a0: 1.777 V	ADC_A1_raw: 9416	V_adc_a1: 1.766 V
Position: 36	DAC_Bits: 1489	V_set_dac: 1.818 V	V_set_pot: 1.818 V	ADC_A0_raw: 9750	V_adc_a0: 1.828 V	ADC_A1_raw: 9692	V_adc_a1: 1.817 V
Position: 37	DAC_Bits: 1530	V_set_dac: 1.868 V	V_set_pot: 1.869 V	ADC_A0_raw: 10017	V_adc_a0: 1.878 V	ADC_A1_raw: 9963	V_adc_a1: 1.868 V
Position: 38	DAC_Bits: 1571	V_set_dac: 1.918 V	V_set_pot: 1.919 V	ADC_A0_raw: 10286	V_adc_a0: 1.929 V	ADC_A1_raw: 10227	V_adc_a1: 1.918 V
Position: 39	DAC_Bits: 1613	V_set_dac: 1.969 V	V_set_pot: 1.970 V	ADC_A0_raw: 10557	V_adc_a0: 1.979 V	ADC_A1_raw: 10496	V_adc_a1: 1.968 V
Position: 40	DAC_Bits: 1654	V_set_dac: 2.020 V	V_set_pot: 2.020 V	ADC_A0_raw: 10830	V_adc_a0: 2.031 V	ADC_A1_raw: 10758	V_adc_a1: 2.017 V
Position: 41	DAC_Bits: 1695	V_set_dac: 2.070 V	V_set_pot: 2.071 V	ADC_A0_raw: 11098	V_adc_a0: 2.081 V	ADC_A1_raw: 11025	V_adc_a1: 2.067 V
Position: 42	DAC_Bits: 1737	V_set_dac: 2.121 V	V_set_pot: 2.121 V	ADC_A0_raw: 11368	V_adc_a0: 2.132 V	ADC_A1_raw: 11298	V_adc_a1: 2.118 V
Position: 43	DAC_Bits: 1778	V_set_dac: 2.171 V	V_set_pot: 2.172 V	ADC_A0_raw: 11639	V_adc_a0: 2.182 V	ADC_A1_raw: 11563	V_adc_a1: 2.168 V
Position: 44	DAC_Bits: 1820	V_set_dac: 2.222 V	V_set_pot: 2.222 V	ADC_A0_raw: 11909	V_adc_a0: 2.233 V	ADC_A1_raw: 11837	V_adc_a1: 2.219 V
Position: 45	DAC_Bits: 1861	V_set_dac: 2.272 V	V_set_pot: 2.273 V	ADC_A0_raw: 12179	V_adc_a0: 2.284 V	ADC_A1_raw: 12105	V_adc_a1: 2.270 V
Position: 46	DAC_Bits: 1902	V_set_dac: 2.322 V	V_set_pot: 2.323 V	ADC_A0_raw: 12451	V_adc_a0: 2.335 V	ADC_A1_raw: 12372	V_adc_a1: 2.320 V
Position: 47	DAC_Bits: 1944	V_set_dac: 2.374 V	V_set_pot: 2.374 V	ADC_A0_raw: 12718	V_adc_a0: 2.385 V	ADC_A1_raw: 12645	V_adc_a1: 2.371 V
Position: 48	DAC_Bits: 1985	V_set_dac: 2.424 V	V_set_pot: 2.424 V	ADC_A0_raw: 12993	V_adc_a0: 2.436 V	ADC_A1_raw: 12909	V_adc_a1: 2.420 V
Position: 49	DAC_Bits: 2026	V_set_dac: 2.474 V	V_set_pot: 2.475 V	ADC_A0_raw: 13259	V_adc_a0: 2.486 V	ADC_A1_raw: 13184	V_adc_a1: 2.472 V
Position: 50	DAC_Bits: 2068	V_set_dac: 2.525 V	V_set_pot: 2.525 V	ADC_A0_raw: 13536	V_adc_a0: 2.538 V	ADC_A1_raw: 13461	V_adc_a1: 2.524 V
Position: 51	DAC_Bits: 2109	V_set_dac: 2.575 V	V_set_pot: 2.576 V	ADC_A0_raw: 13803	V_adc_a0: 2.588 V	ADC_A1_raw: 13732	V_adc_a1: 2.575 V
Position: 52	DAC_Bits: 2150	V_set_dac: 2.625 V	V_set_pot: 2.626 V	ADC_A0_raw: 14079	V_adc_a0: 2.640 V	ADC_A1_raw: 14004	V_adc_a1: 2.626 V
Position: 53	DAC_Bits: 2192	V_set_dac: 2.676 V	V_set_pot: 2.677 V	ADC_A0_raw: 14352	V_adc_a0: 2.691 V	ADC_A1_raw: 14280	V_adc_a1: 2.678 V
Position: 54	DAC_Bits: 2233	V_set_dac: 2.726 V	V_set_pot: 2.727 V	ADC_A0_raw: 14625	V_adc_a0: 2.742 V	ADC_A1_raw: 14542	V_adc_a1: 2.727 V
Position: 55	DAC_Bits: 2275	V_set_dac: 2.778 V	V_set_pot: 2.778 V	ADC_A0_raw: 14894	V_adc_a0: 2.793 V	ADC_A1_raw: 14816	V_adc_a1: 2.778 V
Position: 56	DAC_Bits: 2316	V_set_dac: 2.828 V	V_set_pot: 2.828 V	ADC_A0_raw: 15161	V_adc_a0: 2.843 V	ADC_A1_raw: 15088	V_adc_a1: 2.829 V
Position: 57	DAC_Bits: 2357	V_set_dac: 2.878 V	V_set_pot: 2.879 V	ADC_A0_raw: 15434	V_adc_a0: 2.894 V	ADC_A1_raw: 15356	V_adc_a1: 2.879 V
Position: 58	DAC_Bits: 2399	V_set_dac: 2.929 V	V_set_pot: 2.929 V	ADC_A0_raw: 15713	V_adc_a0: 2.946 V	ADC_A1_raw: 15630	V_adc_a1: 2.931 V
Position: 59	DAC_Bits: 2440	V_set_dac: 2.979 V	V_set_pot: 2.980 V	ADC_A0_raw: 15984	V_adc_a0: 2.997 V	ADC_A1_raw: 15897	V_adc_a1: 2.981 V
Position: 60	DAC_Bits: 2481	V_set_dac: 3.029 V	V_set_pot: 3.030 V	ADC_A0_raw: 16255	V_adc_a0: 3.048 V	ADC_A1_raw: 16169	V_adc_a1: 3.032 V
Position: 61	DAC_Bits: 2523	V_set_dac: 3.081 V	V_set_pot: 3.081 V	ADC_A0_raw: 16529	V_adc_a0: 3.099 V	ADC_A1_raw: 16450	V_adc_a1: 3.084 V
Position: 62	DAC_Bits: 2564	V_set_dac: 3.131 V	V_set_pot: 3.131 V	ADC_A0_raw: 16794	V_adc_a0: 3.149 V	ADC_A1_raw: 16727	V_adc_a1: 3.136 V
Position: 63	DAC_Bits: 2605	V_set_dac: 3.181 V	V_set_pot: 3.182 V	ADC_A0_raw: 17067	V_adc_a0: 3.200 V	ADC_A1_raw: 16995	V_adc_a1: 3.187 V
Position: 64	DAC_Bits: 2647	V_set_dac: 3.232 V	V_set_pot: 3.232 V	ADC_A0_raw: 17341	V_adc_a0: 3.251 V	ADC_A1_raw: 17267	V_adc_a1: 3.238 V
Position: 65	DAC_Bits: 2688	V_set_dac: 3.282 V	V_set_pot: 3.283 V	ADC_A0_raw: 17614	V_adc_a0: 3.303 V	ADC_A1_raw: 17538	V_adc_a1: 3.288 V
Position: 66	DAC_Bits: 2730	V_set_dac: 3.333 V	V_set_pot: 3.333 V	ADC_A0_raw: 17887	V_adc_a0: 3.354 V	ADC_A1_raw: 17814	V_adc_a1: 3.340 V
Position: 67	DAC_Bits: 2771	V_set_dac: 3.383 V	V_set_pot: 3.384 V	ADC_A0_raw: 18156	V_adc_a0: 3.404 V	ADC_A1_raw: 18083	V_adc_a1: 3.391 V
Position: 68	DAC_Bits: 2812	V_set_dac: 3.433 V	V_set_pot: 3.434 V	ADC_A0_raw: 18431	V_adc_a0: 3.456 V	ADC_A1_raw: 18352	V_adc_a1: 3.441 V
Position: 69	DAC_Bits: 2854	V_set_dac: 3.485 V	V_set_pot: 3.485 V	ADC_A0_raw: 18696	V_adc_a0: 3.506 V	ADC_A1_raw: 18622	V_adc_a1: 3.492 V
Position: 70	DAC_Bits: 2895	V_set_dac: 3.535 V	V_set_pot: 3.535 V	ADC_A0_raw: 18968	V_adc_a0: 3.556 V	ADC_A1_raw: 18888	V_adc_a1: 3.542 V
Position: 71	DAC_Bits: 2936	V_set_dac: 3.585 V	V_set_pot: 3.586 V	ADC_A0_raw: 19242	V_adc_a0: 3.608 V	ADC_A1_raw: 19152	V_adc_a1: 3.591 V
Position: 72	DAC_Bits: 2978	V_set_dac: 3.636 V	V_set_pot: 3.636 V	ADC_A0_raw: 19509	V_adc_a0: 3.658 V	ADC_A1_raw: 19425	V_adc_a1: 3.642 V
Position: 73	DAC_Bits: 3019	V_set_dac: 3.686 V	V_set_pot: 3.687 V	ADC_A0_raw: 19765	V_adc_a0: 3.706 V	ADC_A1_raw: 19687	V_adc_a1: 3.691 V
Position: 74	DAC_Bits: 3060	V_set_dac: 3.736 V	V_set_pot: 3.737 V	ADC_A0_raw: 19964	V_adc_a0: 3.743 V	ADC_A1_raw: 19929	V_adc_a1: 3.737 V
Position: 75	DAC_Bits: 3102	V_set_dac: 3.788 V	V_set_pot: 3.788 V	ADC_A0_raw: 20109	V_adc_a0: 3.770 V	ADC_A1_raw: 20120	V_adc_a1: 3.773 V
Position: 76	DAC_Bits: 3143	V_set_dac: 3.838 V	V_set_pot: 3.838 V	ADC_A0_raw: 20187	V_adc_a0: 3.785 V	ADC_A1_raw: 20219	V_adc_a1: 3.791 V
Position: 77	DAC_Bits: 3185	V_set_dac: 3.889 V	V_set_pot: 3.889 V	ADC_A0_raw: 20230	V_adc_a0: 3.793 V	ADC_A1_raw: 20270	V_adc_a1: 3.801 V
Position: 78	DAC_Bits: 3226	V_set_dac: 3.939 V	V_set_pot: 3.939 V	ADC_A0_raw: 20250	V_adc_a0: 3.797 V	ADC_A1_raw: 20250	V_adc_a1: 3.797 V
Position: 79	DAC_Bits: 3267	V_set_dac: 3.989 V	V_set_pot: 3.990 V	ADC_A0_raw: 20230	V_adc_a0: 3.793 V	ADC_A1_raw: 20230	V_adc_a1: 3.793 V
Position: 80	DAC_Bits: 3309	V_set_dac: 4.040 V	V_set_pot: 4.040 V	ADC_A0_raw: 20189	V_adc_a0: 3.785 V	ADC_A1_raw: 20149	V_adc_a1: 3.778 V
Position: 81	DAC_Bits: 3350	V_set_dac: 4.090 V	V_set_pot: 4.091 V	ADC_A0_raw: 20169	V_adc_a0: 3.782 V	ADC_A1_raw: 20108	V_adc_a1: 3.770 V
Position: 82	DAC_Bits: 3391	V_set_dac: 4.140 V	V_set_pot: 4.141 V	ADC_A0_raw: 20149	V_adc_a0: 3.778 V	ADC_A1_raw: 20027	V_adc_a1: 3.755 V
Position: 83	DAC_Bits: 3433	V_set_dac: 4.192 V	V_set_pot: 4.192 V	ADC_A0_raw: 20149	V_adc_a0: 3.778 V	ADC_A1_raw: 19967	V_adc_a1: 3.744 V
Position: 84	DAC_Bits: 3474	V_set_dac: 4.242 V	V_set_pot: 4.242 V	ADC_A0_raw: 20149	V_adc_a0: 3.778 V	ADC_A1_raw: 19967	V_adc_a1: 3.744 V
Position: 85	DAC_Bits: 3515	V_set_dac: 4.292 V	V_set_pot: 4.293 V	ADC_A0_raw: 20129	V_adc_a0: 3.774 V	ADC_A1_raw: 19946	V_adc_a1: 3.740 V
Position: 86	DAC_Bits: 3557	V_set_dac: 4.343 V	V_set_pot: 4.343 V	ADC_A0_raw: 20108	V_adc_a0: 3.770 V	ADC_A1_raw: 19946	V_adc_a1: 3.740 V
Position: 87	DAC_Bits: 3598	V_set_dac: 4.393 V	V_set_pot: 4.394 V	ADC_A0_raw: 20088	V_adc_a0: 3.766 V	ADC_A1_raw: 19926	V_adc_a1: 3.736 V
Position: 88	DAC_Bits: 3640	V_set_dac: 4.444 V	V_set_pot: 4.444 V	ADC_A0_raw: 20088	V_adc_a0: 3.766 V	ADC_A1_raw: 19926	V_adc_a1: 3.736 V
Position: 89	DAC_Bits: 3681	V_set_dac: 4.495 V	V_set_pot: 4.495 V	ADC_A0_raw: 20088	V_adc_a0: 3.766 V	ADC_A1_raw: 19906	V_adc_a1: 3.732 V
Position: 90	DAC_Bits: 3722	V_set_dac: 4.545 V	V_set_pot: 4.545 V	ADC_A0_raw: 20088	V_adc_a0: 3.766 V	ADC_A1_raw: 19906	V_adc_a1: 3.732 V
Position: 91	DAC_Bits: 3764	V_set_dac: 4.596 V	V_set_pot: 4.596 V	ADC_A0_raw: 20048	V_adc_a0: 3.759 V	ADC_A1_raw: 19886	V_adc_a1: 3.729 V
Position: 92	DAC_Bits: 3805	V_set_dac: 4.646 V	V_set_pot: 4.646 V	ADC_A0_raw: 20007	V_adc_a0: 3.751 V	ADC_A1_raw: 19865	V_adc_a1: 3.725 V
Position: 93	DAC_Bits: 3846	V_set_dac: 4.696 V	V_set_pot: 4.697 V	ADC_A0_raw: 19987	V_adc_a0: 3.748 V	ADC_A1_raw: 19865	V_adc_a1: 3.725 V
Position: 94	DAC_Bits: 3888	V_set_dac: 4.747 V	V_set_pot: 4.747 V	ADC_A0_raw: 19967	V_adc_a0: 3.744 V	ADC_A1_raw: 19865	V_adc_a1: 3.725 V
Position: 95	DAC_Bits: 3929	V_set_dac: 4.797 V	V_set_pot: 4.798 V	ADC_A0_raw: 19946	V_adc_a0: 3.740 V	ADC_A1_raw: 19845	V_adc_a1: 3.721 V
Position: 96	DAC_Bits: 3970	V_set_dac: 4.847 V	V_set_pot: 4.848 V	ADC_A0_raw: 19926	V_adc_a0: 3.736 V	ADC_A1_raw: 19825	V_adc_a1: 3.717 V
Position: 97	DAC_Bits: 4012	V_set_dac: 4.899 V	V_set_pot: 4.899 V	ADC_A0_raw: 19886	V_adc_a0: 3.729 V	ADC_A1_raw: 19805	V_adc_a1: 3.713 V
Position: 98	DAC_Bits: 4053	V_set_dac: 4.949 V	V_set_pot: 4.949 V	ADC_A0_raw: 19805	V_adc_a0: 3.713 V	ADC_A1_raw: 19784	V_adc_a1: 3.710 V
Position: 99	DAC_Bits: 4095	V_set_dac: 5.000 V	V_set_pot: 5.000 V	ADC_A0_raw: 19541	V_adc_a0: 3.664 V	ADC_A1_raw: 19703	V_adc_a1: 3.694 V
Position: 99	DAC_Bits: 4095	V_set_dac: 5.000 V	V_set_pot: 5.000 V	ADC_A0_raw: 19602	V_adc_a0: 3.675 V	ADC_A1_raw: 19724	V_adc_a1: 3.698 V
Position: 98	DAC_Bits: 4053	V_set_dac: 4.949 V	V_set_pot: 4.949 V	ADC_A0_raw: 19805	V_adc_a0: 3.713 V	ADC_A1_raw: 19784	V_adc_a1: 3.710 V
Position: 97	DAC_Bits: 4012	V_set_dac: 4.899 V	V_set_pot: 4.899 V	ADC_A0_raw: 19865	V_adc_a0: 3.725 V	ADC_A1_raw: 19784	V_adc_a1: 3.710 V
Position: 96	DAC_Bits: 3970	V_set_dac: 4.847 V	V_set_pot: 4.848 V	ADC_A0_raw: 19886	V_adc_a0: 3.729 V	ADC_A1_raw: 19825	V_adc_a1: 3.717 V
Position: 95	DAC_Bits: 3929	V_set_dac: 4.797 V	V_set_pot: 4.798 V	ADC_A0_raw: 19926	V_adc_a0: 3.736 V	ADC_A1_raw: 19845	V_adc_a1: 3.721 V
Position: 94	DAC_Bits: 3888	V_set_dac: 4.747 V	V_set_pot: 4.747 V	ADC_A0_raw: 19967	V_adc_a0: 3.744 V	ADC_A1_raw: 19845	V_adc_a1: 3.721 V
Position: 93	DAC_Bits: 3846	V_set_dac: 4.696 V	V_set_pot: 4.697 V	ADC_A0_raw: 19987	V_adc_a0: 3.748 V	ADC_A1_raw: 19845	V_adc_a1: 3.721 V
Position: 92	DAC_Bits: 3805	V_set_dac: 4.646 V	V_set_pot: 4.646 V	ADC_A0_raw: 20027	V_adc_a0: 3.755 V	ADC_A1_raw: 19865	V_adc_a1: 3.725 V
Position: 91	DAC_Bits: 3764	V_set_dac: 4.596 V	V_set_pot: 4.596 V	ADC_A0_raw: 20048	V_adc_a0: 3.759 V	ADC_A1_raw: 19886	V_adc_a1: 3.729 V
Position: 90	DAC_Bits: 3722	V_set_dac: 4.545 V	V_set_pot: 4.545 V	ADC_A0_raw: 20088	V_adc_a0: 3.766 V	ADC_A1_raw: 19886	V_adc_a1: 3.729 V
Position: 89	DAC_Bits: 3681	V_set_dac: 4.495 V	V_set_pot: 4.495 V	ADC_A0_raw: 20088	V_adc_a0: 3.766 V	ADC_A1_raw: 19906	V_adc_a1: 3.732 V
Position: 88	DAC_Bits: 3640	V_set_dac: 4.444 V	V_set_pot: 4.444 V	ADC_A0_raw: 20088	V_adc_a0: 3.766 V	ADC_A1_raw: 19906	V_adc_a1: 3.732 V
Position: 87	DAC_Bits: 3598	V_set_dac: 4.393 V	V_set_pot: 4.394 V	ADC_A0_raw: 20068	V_adc_a0: 3.763 V	ADC_A1_raw: 19926	V_adc_a1: 3.736 V
Position: 86	DAC_Bits: 3557	V_set_dac: 4.343 V	V_set_pot: 4.343 V	ADC_A0_raw: 20068	V_adc_a0: 3.763 V	ADC_A1_raw: 19926	V_adc_a1: 3.736 V
Position: 85	DAC_Bits: 3515	V_set_dac: 4.292 V	V_set_pot: 4.293 V	ADC_A0_raw: 20088	V_adc_a0: 3.766 V	ADC_A1_raw: 19946	V_adc_a1: 3.740 V
Position: 84	DAC_Bits: 3474	V_set_dac: 4.242 V	V_set_pot: 4.242 V	ADC_A0_raw: 20108	V_adc_a0: 3.770 V	ADC_A1_raw: 19946	V_adc_a1: 3.740 V
Position: 83	DAC_Bits: 3433	V_set_dac: 4.192 V	V_set_pot: 4.192 V	ADC_A0_raw: 20129	V_adc_a0: 3.774 V	ADC_A1_raw: 19967	V_adc_a1: 3.744 V
Position: 82	DAC_Bits: 3391	V_set_dac: 4.140 V	V_set_pot: 4.141 V	ADC_A0_raw: 20129	V_adc_a0: 3.774 V	ADC_A1_raw: 19987	V_adc_a1: 3.748 V
Position: 81	DAC_Bits: 3350	V_set_dac: 4.090 V	V_set_pot: 4.091 V	ADC_A0_raw: 20129	V_adc_a0: 3.774 V	ADC_A1_raw: 20088	V_adc_a1: 3.766 V
Position: 80	DAC_Bits: 3309	V_set_dac: 4.040 V	V_set_pot: 4.040 V	ADC_A0_raw: 20169	V_adc_a0: 3.782 V	ADC_A1_raw: 20129	V_adc_a1: 3.774 V
Position: 79	DAC_Bits: 3267	V_set_dac: 3.989 V	V_set_pot: 3.990 V	ADC_A0_raw: 20210	V_adc_a0: 3.789 V	ADC_A1_raw: 20189	V_adc_a1: 3.785 V
Position: 78	DAC_Bits: 3226	V_set_dac: 3.939 V	V_set_pot: 3.939 V	ADC_A0_raw: 20210	V_adc_a0: 3.789 V	ADC_A1_raw: 20230	V_adc_a1: 3.793 V
Position: 77	DAC_Bits: 3185	V_set_dac: 3.889 V	V_set_pot: 3.889 V	ADC_A0_raw: 20189	V_adc_a0: 3.785 V	ADC_A1_raw: 20230	V_adc_a1: 3.793 V
Position: 76	DAC_Bits: 3143	V_set_dac: 3.838 V	V_set_pot: 3.838 V	ADC_A0_raw: 20172	V_adc_a0: 3.782 V	ADC_A1_raw: 20205	V_adc_a1: 3.788 V
Position: 75	DAC_Bits: 3102	V_set_dac: 3.788 V	V_set_pot: 3.788 V	ADC_A0_raw: 20095	V_adc_a0: 3.768 V	ADC_A1_raw: 20111	V_adc_a1: 3.771 V
Position: 74	DAC_Bits: 3060	V_set_dac: 3.736 V	V_set_pot: 3.737 V	ADC_A0_raw: 19964	V_adc_a0: 3.743 V	ADC_A1_raw: 19925	V_adc_a1: 3.736 V
Position: 73	DAC_Bits: 3019	V_set_dac: 3.686 V	V_set_pot: 3.687 V	ADC_A0_raw: 19760	V_adc_a0: 3.705 V	ADC_A1_raw: 19688	V_adc_a1: 3.691 V
Position: 72	DAC_Bits: 2978	V_set_dac: 3.636 V	V_set_pot: 3.636 V	ADC_A0_raw: 19504	V_adc_a0: 3.657 V	ADC_A1_raw: 19426	V_adc_a1: 3.642 V
Position: 71	DAC_Bits: 2936	V_set_dac: 3.585 V	V_set_pot: 3.586 V	ADC_A0_raw: 19240	V_adc_a0: 3.608 V	ADC_A1_raw: 19154	V_adc_a1: 3.591 V
Position: 70	DAC_Bits: 2895	V_set_dac: 3.535 V	V_set_pot: 3.535 V	ADC_A0_raw: 18969	V_adc_a0: 3.557 V	ADC_A1_raw: 18888	V_adc_a1: 3.542 V
Position: 69	DAC_Bits: 2854	V_set_dac: 3.485 V	V_set_pot: 3.485 V	ADC_A0_raw: 18697	V_adc_a0: 3.506 V	ADC_A1_raw: 18621	V_adc_a1: 3.491 V
Position: 68	DAC_Bits: 2812	V_set_dac: 3.433 V	V_set_pot: 3.434 V	ADC_A0_raw: 18427	V_adc_a0: 3.455 V	ADC_A1_raw: 18352	V_adc_a1: 3.441 V
Position: 67	DAC_Bits: 2771	V_set_dac: 3.383 V	V_set_pot: 3.384 V	ADC_A0_raw: 18155	V_adc_a0: 3.404 V	ADC_A1_raw: 18084	V_adc_a1: 3.391 V
Position: 66	DAC_Bits: 2730	V_set_dac: 3.333 V	V_set_pot: 3.333 V	ADC_A0_raw: 17883	V_adc_a0: 3.353 V	ADC_A1_raw: 17816	V_adc_a1: 3.341 V
Position: 65	DAC_Bits: 2688	V_set_dac: 3.282 V	V_set_pot: 3.283 V	ADC_A0_raw: 17610	V_adc_a0: 3.302 V	ADC_A1_raw: 17539	V_adc_a1: 3.289 V
Position: 64	DAC_Bits: 2647	V_set_dac: 3.232 V	V_set_pot: 3.232 V	ADC_A0_raw: 17345	V_adc_a0: 3.252 V	ADC_A1_raw: 17267	V_adc_a1: 3.238 V
Position: 63	DAC_Bits: 2605	V_set_dac: 3.181 V	V_set_pot: 3.182 V	ADC_A0_raw: 17065	V_adc_a0: 3.200 V	ADC_A1_raw: 16995	V_adc_a1: 3.187 V
Position: 62	DAC_Bits: 2564	V_set_dac: 3.131 V	V_set_pot: 3.131 V	ADC_A0_raw: 16799	V_adc_a0: 3.150 V	ADC_A1_raw: 16728	V_adc_a1: 3.137 V
Position: 61	DAC_Bits: 2523	V_set_dac: 3.081 V	V_set_pot: 3.081 V	ADC_A0_raw: 16529	V_adc_a0: 3.099 V	ADC_A1_raw: 16452	V_adc_a1: 3.085 V
Position: 60	DAC_Bits: 2481	V_set_dac: 3.029 V	V_set_pot: 3.030 V	ADC_A0_raw: 16252	V_adc_a0: 3.047 V	ADC_A1_raw: 16170	V_adc_a1: 3.032 V
Position: 59	DAC_Bits: 2440	V_set_dac: 2.979 V	V_set_pot: 2.980 V	ADC_A0_raw: 15989	V_adc_a0: 2.998 V	ADC_A1_raw: 15898	V_adc_a1: 2.981 V
Position: 58	DAC_Bits: 2399	V_set_dac: 2.929 V	V_set_pot: 2.929 V	ADC_A0_raw: 15715	V_adc_a0: 2.947 V	ADC_A1_raw: 15629	V_adc_a1: 2.930 V
Position: 57	DAC_Bits: 2357	V_set_dac: 2.878 V	V_set_pot: 2.879 V	ADC_A0_raw: 15439	V_adc_a0: 2.895 V	ADC_A1_raw: 15354	V_adc_a1: 2.879 V
Position: 56	DAC_Bits: 2316	V_set_dac: 2.828 V	V_set_pot: 2.828 V	ADC_A0_raw: 15168	V_adc_a0: 2.844 V	ADC_A1_raw: 15088	V_adc_a1: 2.829 V
Position: 55	DAC_Bits: 2275	V_set_dac: 2.778 V	V_set_pot: 2.778 V	ADC_A0_raw: 14896	V_adc_a0: 2.793 V	ADC_A1_raw: 14818	V_adc_a1: 2.778 V
Position: 54	DAC_Bits: 2233	V_set_dac: 2.726 V	V_set_pot: 2.727 V	ADC_A0_raw: 14625	V_adc_a0: 2.742 V	ADC_A1_raw: 14544	V_adc_a1: 2.727 V
Position: 53	DAC_Bits: 2192	V_set_dac: 2.676 V	V_set_pot: 2.677 V	ADC_A0_raw: 14353	V_adc_a0: 2.691 V	ADC_A1_raw: 14280	V_adc_a1: 2.678 V
Position: 52	DAC_Bits: 2150	V_set_dac: 2.625 V	V_set_pot: 2.626 V	ADC_A0_raw: 14078	V_adc_a0: 2.640 V	ADC_A1_raw: 14004	V_adc_a1: 2.626 V
Position: 51	DAC_Bits: 2109	V_set_dac: 2.575 V	V_set_pot: 2.576 V	ADC_A0_raw: 13803	V_adc_a0: 2.588 V	ADC_A1_raw: 13732	V_adc_a1: 2.575 V
Position: 50	DAC_Bits: 2068	V_set_dac: 2.525 V	V_set_pot: 2.525 V	ADC_A0_raw: 13534	V_adc_a0: 2.538 V	ADC_A1_raw: 13462	V_adc_a1: 2.524 V
Position: 49	DAC_Bits: 2026	V_set_dac: 2.474 V	V_set_pot: 2.475 V	ADC_A0_raw: 13267	V_adc_a0: 2.488 V	ADC_A1_raw: 13184	V_adc_a1: 2.472 V
Position: 48	DAC_Bits: 1985	V_set_dac: 2.424 V	V_set_pot: 2.424 V	ADC_A0_raw: 12996	V_adc_a0: 2.437 V	ADC_A1_raw: 12909	V_adc_a1: 2.420 V
Position: 47	DAC_Bits: 1944	V_set_dac: 2.374 V	V_set_pot: 2.374 V	ADC_A0_raw: 12721	V_adc_a0: 2.385 V	ADC_A1_raw: 12645	V_adc_a1: 2.371 V
Position: 46	DAC_Bits: 1902	V_set_dac: 2.322 V	V_set_pot: 2.323 V	ADC_A0_raw: 12453	V_adc_a0: 2.335 V	ADC_A1_raw: 12374	V_adc_a1: 2.320 V
Position: 45	DAC_Bits: 1861	V_set_dac: 2.272 V	V_set_pot: 2.273 V	ADC_A0_raw: 12179	V_adc_a0: 2.284 V	ADC_A1_raw: 12105	V_adc_a1: 2.270 V
Position: 44	DAC_Bits: 1820	V_set_dac: 2.222 V	V_set_pot: 2.222 V	ADC_A0_raw: 11910	V_adc_a0: 2.233 V	ADC_A1_raw: 11838	V_adc_a1: 2.220 V
Position: 43	DAC_Bits: 1778	V_set_dac: 2.171 V	V_set_pot: 2.172 V	ADC_A0_raw: 11641	V_adc_a0: 2.183 V	ADC_A1_raw: 11564	V_adc_a1: 2.168 V
Position: 42	DAC_Bits: 1737	V_set_dac: 2.121 V	V_set_pot: 2.121 V	ADC_A0_raw: 11368	V_adc_a0: 2.132 V	ADC_A1_raw: 11299	V_adc_a1: 2.119 V
Position: 41	DAC_Bits: 1695	V_set_dac: 2.070 V	V_set_pot: 2.071 V	ADC_A0_raw: 11098	V_adc_a0: 2.081 V	ADC_A1_raw: 11026	V_adc_a1: 2.067 V
Position: 40	DAC_Bits: 1654	V_set_dac: 2.020 V	V_set_pot: 2.020 V	ADC_A0_raw: 10827	V_adc_a0: 2.030 V	ADC_A1_raw: 10758	V_adc_a1: 2.017 V
Position: 39	DAC_Bits: 1613	V_set_dac: 1.969 V	V_set_pot: 1.970 V	ADC_A0_raw: 10559	V_adc_a0: 1.980 V	ADC_A1_raw: 10496	V_adc_a1: 1.968 V
Position: 38	DAC_Bits: 1571	V_set_dac: 1.918 V	V_set_pot: 1.919 V	ADC_A0_raw: 10288	V_adc_a0: 1.929 V	ADC_A1_raw: 10227	V_adc_a1: 1.918 V
Position: 37	DAC_Bits: 1530	V_set_dac: 1.868 V	V_set_pot: 1.869 V	ADC_A0_raw: 10014	V_adc_a0: 1.878 V	ADC_A1_raw: 9963	V_adc_a1: 1.868 V
Position: 36	DAC_Bits: 1489	V_set_dac: 1.818 V	V_set_pot: 1.818 V	ADC_A0_raw: 9743	V_adc_a0: 1.827 V	ADC_A1_raw: 9691	V_adc_a1: 1.817 V
Position: 35	DAC_Bits: 1447	V_set_dac: 1.767 V	V_set_pot: 1.768 V	ADC_A0_raw: 9474	V_adc_a0: 1.776 V	ADC_A1_raw: 9415	V_adc_a1: 1.765 V
Position: 34	DAC_Bits: 1406	V_set_dac: 1.717 V	V_set_pot: 1.717 V	ADC_A0_raw: 9206	V_adc_a0: 1.726 V	ADC_A1_raw: 9148	V_adc_a1: 1.715 V
Position: 33	DAC_Bits: 1365	V_set_dac: 1.667 V	V_set_pot: 1.667 V	ADC_A0_raw: 8929	V_adc_a0: 1.674 V	ADC_A1_raw: 8879	V_adc_a1: 1.665 V
Position: 32	DAC_Bits: 1323	V_set_dac: 1.615 V	V_set_pot: 1.616 V	ADC_A0_raw: 8657	V_adc_a0: 1.623 V	ADC_A1_raw: 8606	V_adc_a1: 1.614 V
Position: 31	DAC_Bits: 1282	V_set_dac: 1.565 V	V_set_pot: 1.566 V	ADC_A0_raw: 8382	V_adc_a0: 1.572 V	ADC_A1_raw: 8341	V_adc_a1: 1.564 V
Position: 30	DAC_Bits: 1240	V_set_dac: 1.514 V	V_set_pot: 1.515 V	ADC_A0_raw: 8114	V_adc_a0: 1.521 V	ADC_A1_raw: 8070	V_adc_a1: 1.513 V
Position: 29	DAC_Bits: 1199	V_set_dac: 1.464 V	V_set_pot: 1.465 V	ADC_A0_raw: 7851	V_adc_a0: 1.472 V	ADC_A1_raw: 7805	V_adc_a1: 1.463 V
Position: 28	DAC_Bits: 1158	V_set_dac: 1.414 V	V_set_pot: 1.414 V	ADC_A0_raw: 7576	V_adc_a0: 1.421 V	ADC_A1_raw: 7540	V_adc_a1: 1.414 V
Position: 27	DAC_Bits: 1116	V_set_dac: 1.363 V	V_set_pot: 1.364 V	ADC_A0_raw: 7305	V_adc_a0: 1.370 V	ADC_A1_raw: 7265	V_adc_a1: 1.362 V
Position: 26	DAC_Bits: 1075	V_set_dac: 1.313 V	V_set_pot: 1.313 V	ADC_A0_raw: 7034	V_adc_a0: 1.319 V	ADC_A1_raw: 6999	V_adc_a1: 1.312 V
Position: 25	DAC_Bits: 1034	V_set_dac: 1.263 V	V_set_pot: 1.263 V	ADC_A0_raw: 6770	V_adc_a0: 1.269 V	ADC_A1_raw: 6730	V_adc_a1: 1.262 V
Position: 24	DAC_Bits: 992	V_set_dac: 1.211 V	V_set_pot: 1.212 V	ADC_A0_raw: 6494	V_adc_a0: 1.218 V	ADC_A1_raw: 6449	V_adc_a1: 1.209 V
Position: 23	DAC_Bits: 951	V_set_dac: 1.161 V	V_set_pot: 1.162 V	ADC_A0_raw: 6226	V_adc_a0: 1.167 V	ADC_A1_raw: 6175	V_adc_a1: 1.158 V
Position: 22	DAC_Bits: 910	V_set_dac: 1.111 V	V_set_pot: 1.111 V	ADC_A0_raw: 5953	V_adc_a0: 1.116 V	ADC_A1_raw: 5912	V_adc_a1: 1.109 V
Position: 21	DAC_Bits: 868	V_set_dac: 1.060 V	V_set_pot: 1.061 V	ADC_A0_raw: 5687	V_adc_a0: 1.066 V	ADC_A1_raw: 5637	V_adc_a1: 1.057 V
Position: 20	DAC_Bits: 827	V_set_dac: 1.010 V	V_set_pot: 1.010 V	ADC_A0_raw: 5415	V_adc_a0: 1.015 V	ADC_A1_raw: 5368	V_adc_a1: 1.007 V
Position: 19	DAC_Bits: 785	V_set_dac: 0.958 V	V_set_pot: 0.960 V	ADC_A0_raw: 5146	V_adc_a0: 0.965 V	ADC_A1_raw: 5094	V_adc_a1: 0.955 V
Position: 18	DAC_Bits: 744	V_set_dac: 0.908 V	V_set_pot: 0.909 V	ADC_A0_raw: 4867	V_adc_a0: 0.913 V	ADC_A1_raw: 4828	V_adc_a1: 0.905 V
Position: 17	DAC_Bits: 703	V_set_dac: 0.858 V	V_set_pot: 0.859 V	ADC_A0_raw: 4602	V_adc_a0: 0.863 V	ADC_A1_raw: 4564	V_adc_a1: 0.856 V
Position: 16	DAC_Bits: 661	V_set_dac: 0.807 V	V_set_pot: 0.808 V	ADC_A0_raw: 4326	V_adc_a0: 0.811 V	ADC_A1_raw: 4293	V_adc_a1: 0.805 V
Position: 15	DAC_Bits: 620	V_set_dac: 0.757 V	V_set_pot: 0.758 V	ADC_A0_raw: 4057	V_adc_a0: 0.761 V	ADC_A1_raw: 4029	V_adc_a1: 0.755 V
Position: 14	DAC_Bits: 579	V_set_dac: 0.707 V	V_set_pot: 0.707 V	ADC_A0_raw: 3785	V_adc_a0: 0.710 V	ADC_A1_raw: 3763	V_adc_a1: 0.706 V
Position: 13	DAC_Bits: 537	V_set_dac: 0.656 V	V_set_pot: 0.657 V	ADC_A0_raw: 3516	V_adc_a0: 0.659 V	ADC_A1_raw: 3490	V_adc_a1: 0.654 V
Position: 12	DAC_Bits: 496	V_set_dac: 0.606 V	V_set_pot: 0.606 V	ADC_A0_raw: 3243	V_adc_a0: 0.608 V	ADC_A1_raw: 3220	V_adc_a1: 0.604 V
Position: 11	DAC_Bits: 455	V_set_dac: 0.556 V	V_set_pot: 0.556 V	ADC_A0_raw: 2975	V_adc_a0: 0.558 V	ADC_A1_raw: 2947	V_adc_a1: 0.553 V
Position: 10	DAC_Bits: 413	V_set_dac: 0.504 V	V_set_pot: 0.505 V	ADC_A0_raw: 2703	V_adc_a0: 0.507 V	ADC_A1_raw: 2676	V_adc_a1: 0.502 V
Position: 9	DAC_Bits: 372	V_set_dac: 0.454 V	V_set_pot: 0.455 V	ADC_A0_raw: 2435	V_adc_a0: 0.457 V	ADC_A1_raw: 2413	V_adc_a1: 0.452 V
Position: 8	DAC_Bits: 330	V_set_dac: 0.403 V	V_set_pot: 0.404 V	ADC_A0_raw: 2162	V_adc_a0: 0.405 V	ADC_A1_raw: 2143	V_adc_a1: 0.402 V
Position: 7	DAC_Bits: 289	V_set_dac: 0.353 V	V_set_pot: 0.354 V	ADC_A0_raw: 1892	V_adc_a0: 0.355 V	ADC_A1_raw: 1878	V_adc_a1: 0.352 V
Position: 6	DAC_Bits: 248	V_set_dac: 0.303 V	V_set_pot: 0.303 V	ADC_A0_raw: 1621	V_adc_a0: 0.304 V	ADC_A1_raw: 1611	V_adc_a1: 0.302 V
Position: 5	DAC_Bits: 206	V_set_dac: 0.252 V	V_set_pot: 0.253 V	ADC_A0_raw: 1349	V_adc_a0: 0.253 V	ADC_A1_raw: 1338	V_adc_a1: 0.251 V
Position: 4	DAC_Bits: 165	V_set_dac: 0.201 V	V_set_pot: 0.202 V	ADC_A0_raw: 1078	V_adc_a0: 0.202 V	ADC_A1_raw: 1069	V_adc_a1: 0.200 V
Position: 3	DAC_Bits: 124	V_set_dac: 0.151 V	V_set_pot: 0.152 V	ADC_A0_raw: 808	V_adc_a0: 0.152 V	ADC_A1_raw: 798	V_adc_a1: 0.150 V
Position: 2	DAC_Bits: 82	V_set_dac: 0.100 V	V_set_pot: 0.101 V	ADC_A0_raw: 535	V_adc_a0: 0.100 V	ADC_A1_raw: 527	V_adc_a1: 0.099 V
Position: 1	DAC_Bits: 41	V_set_dac: 0.050 V	V_set_pot: 0.051 V	ADC_A0_raw: 263	V_adc_a0: 0.049 V	ADC_A1_raw: 262	V_adc_a1: 0.049 V
Position: 0	DAC_Bits: 0	V_set_dac: 0.000 V	V_set_pot: 0.000 V	ADC_A0_raw: -6	V_adc_a0: -0.001 V	ADC_A1_raw: -1	V_adc_a1: -0.000 V
Position: 0	DAC_Bits: 0	V_set_dac: 0.000 V	V_set_pot: 0.000 V	ADC_A0_raw: -6	V_adc_a0: -0.001 V	ADC_A1_raw: 0	V_adc_a1: 0.000 V
Position: 1	DAC_Bits: 41	V_set_dac: 0.050 V	V_set_pot: 0.051 V	ADC_A0_raw: 264	V_adc_a0: 0.049 V	ADC_A1_raw: 262	V_adc_a1: 0.049 V
Position: 2	DAC_Bits: 82	V_set_dac: 0.100 V	V_set_pot: 0.101 V	ADC_A0_raw: 537	V_adc_a0: 0.101 V	ADC_A1_raw: 527	V_adc_a1: 0.099 V
Position: 3	DAC_Bits: 124	V_set_dac: 0.151 V	V_set_pot: 0.152 V	ADC_A0_raw: 808	V_adc_a0: 0.152 V	ADC_A1_raw: 798	V_adc_a1: 0.150 V
Position: 4	DAC_Bits: 165	V_set_dac: 0.201 V	V_set_pot: 0.202 V	ADC_A0_raw: 1078	V_adc_a0: 0.202 V	ADC_A1_raw: 1070	V_adc_a1: 0.201 V
Position: 5	DAC_Bits: 206	V_set_dac: 0.252 V	V_set_pot: 0.253 V	ADC_A0_raw: 1349	V_adc_a0: 0.253 V	ADC_A1_raw: 1338	V_adc_a1: 0.251 V
Position: 6	DAC_Bits: 248	V_set_dac: 0.303 V	V_set_pot: 0.303 V	ADC_A0_raw: 1620	V_adc_a0: 0.304 V	ADC_A1_raw: 1610	V_adc_a1: 0.302 V
Position: 7	DAC_Bits: 289	V_set_dac: 0.353 V	V_set_pot: 0.354 V	ADC_A0_raw: 1892	V_adc_a0: 0.355 V	ADC_A1_raw: 1877	V_adc_a1: 0.352 V
Position: 8	DAC_Bits: 330	V_set_dac: 0.403 V	V_set_pot: 0.404 V	ADC_A0_raw: 2163	V_adc_a0: 0.406 V	ADC_A1_raw: 2143	V_adc_a1: 0.402 V
Position: 9	DAC_Bits: 372	V_set_dac: 0.454 V	V_set_pot: 0.455 V	ADC_A0_raw: 2436	V_adc_a0: 0.457 V	ADC_A1_raw: 2413	V_adc_a1: 0.452 V
Position: 10	DAC_Bits: 413	V_set_dac: 0.504 V	V_set_pot: 0.505 V	ADC_A0_raw: 2702	V_adc_a0: 0.507 V	ADC_A1_raw: 2676	V_adc_a1: 0.502 V
Position: 11	DAC_Bits: 455	V_set_dac: 0.556 V	V_set_pot: 0.556 V	ADC_A0_raw: 2973	V_adc_a0: 0.557 V	ADC_A1_raw: 2947	V_adc_a1: 0.553 V
Position: 12	DAC_Bits: 496	V_set_dac: 0.606 V	V_set_pot: 0.606 V	ADC_A0_raw: 3248	V_adc_a0: 0.609 V	ADC_A1_raw: 3220	V_adc_a1: 0.604 V
Position: 13	DAC_Bits: 537	V_set_dac: 0.656 V	V_set_pot: 0.657 V	ADC_A0_raw: 3516	V_adc_a0: 0.659 V	ADC_A1_raw: 3491	V_adc_a1: 0.655 V
Position: 14	DAC_Bits: 579	V_set_dac: 0.707 V	V_set_pot: 0.707 V	ADC_A0_raw: 3782	V_adc_a0: 0.709 V	ADC_A1_raw: 3762	V_adc_a1: 0.705 V
Position: 15	DAC_Bits: 620	V_set_dac: 0.757 V	V_set_pot: 0.758 V	ADC_A0_raw: 4058	V_adc_a0: 0.761 V	ADC_A1_raw: 4029	V_adc_a1: 0.755 V
Position: 16	DAC_Bits: 661	V_set_dac: 0.807 V	V_set_pot: 0.808 V	ADC_A0_raw: 4329	V_adc_a0: 0.812 V	ADC_A1_raw: 4293	V_adc_a1: 0.805 V
Position: 17	DAC_Bits: 703	V_set_dac: 0.858 V	V_set_pot: 0.859 V	ADC_A0_raw: 4597	V_adc_a0: 0.862 V	ADC_A1_raw: 4563	V_adc_a1: 0.856 V
Position: 18	DAC_Bits: 744	V_set_dac: 0.908 V	V_set_pot: 0.909 V	ADC_A0_raw: 4870	V_adc_a0: 0.913 V	ADC_A1_raw: 4829	V_adc_a1: 0.905 V
Position: 19	DAC_Bits: 785	V_set_dac: 0.958 V	V_set_pot: 0.960 V	ADC_A0_raw: 5140	V_adc_a0: 0.964 V	ADC_A1_raw: 5094	V_adc_a1: 0.955 V
Position: 20	DAC_Bits: 827	V_set_dac: 1.010 V	V_set_pot: 1.010 V	ADC_A0_raw: 5413	V_adc_a0: 1.015 V	ADC_A1_raw: 5368	V_adc_a1: 1.007 V
Position: 21	DAC_Bits: 868	V_set_dac: 1.060 V	V_set_pot: 1.061 V	ADC_A0_raw: 5685	V_adc_a0: 1.066 V	ADC_A1_raw: 5637	V_adc_a1: 1.057 V
Position: 22	DAC_Bits: 910	V_set_dac: 1.111 V	V_set_pot: 1.111 V	ADC_A0_raw: 5957	V_adc_a0: 1.117 V	ADC_A1_raw: 5911	V_adc_a1: 1.108 V
Position: 23	DAC_Bits: 951	V_set_dac: 1.161 V	V_set_pot: 1.162 V	ADC_A0_raw: 6228	V_adc_a0: 1.168 V	ADC_A1_raw: 6176	V_adc_a1: 1.158 V
Position: 24	DAC_Bits: 992	V_set_dac: 1.211 V	V_set_pot: 1.212 V	ADC_A0_raw: 6497	V_adc_a0: 1.218 V	ADC_A1_raw: 6449	V_adc_a1: 1.209 V
Position: 25	DAC_Bits: 1034	V_set_dac: 1.263 V	V_set_pot: 1.263 V	ADC_A0_raw: 6768	V_adc_a0: 1.269 V	ADC_A1_raw: 6731	V_adc_a1: 1.262 V
Position: 26	DAC_Bits: 1075	V_set_dac: 1.313 V	V_set_pot: 1.313 V	ADC_A0_raw: 7037	V_adc_a0: 1.319 V	ADC_A1_raw: 6999	V_adc_a1: 1.312 V
Position: 27	DAC_Bits: 1116	V_set_dac: 1.363 V	V_set_pot: 1.364 V	ADC_A0_raw: 7305	V_adc_a0: 1.370 V	ADC_A1_raw: 7266	V_adc_a1: 1.362 V
Position: 28	DAC_Bits: 1158	V_set_dac: 1.414 V	V_set_pot: 1.414 V	ADC_A0_raw: 7581	V_adc_a0: 1.421 V	ADC_A1_raw: 7540	V_adc_a1: 1.414 V
Position: 29	DAC_Bits: 1199	V_set_dac: 1.464 V	V_set_pot: 1.465 V	ADC_A0_raw: 7849	V_adc_a0: 1.472 V	ADC_A1_raw: 7806	V_adc_a1: 1.464 V
Position: 30	DAC_Bits: 1240	V_set_dac: 1.514 V	V_set_pot: 1.515 V	ADC_A0_raw: 8122	V_adc_a0: 1.523 V	ADC_A1_raw: 8071	V_adc_a1: 1.513 V
Position: 31	DAC_Bits: 1282	V_set_dac: 1.565 V	V_set_pot: 1.566 V	ADC_A0_raw: 8388	V_adc_a0: 1.573 V	ADC_A1_raw: 8341	V_adc_a1: 1.564 V
Position: 32	DAC_Bits: 1323	V_set_dac: 1.615 V	V_set_pot: 1.616 V	ADC_A0_raw: 8658	V_adc_a0: 1.623 V	ADC_A1_raw: 8607	V_adc_a1: 1.614 V
Position: 33	DAC_Bits: 1365	V_set_dac: 1.667 V	V_set_pot: 1.667 V	ADC_A0_raw: 8928	V_adc_a0: 1.674 V	ADC_A1_raw: 8880	V_adc_a1: 1.665 V
Position: 34	DAC_Bits: 1406	V_set_dac: 1.717 V	V_set_pot: 1.717 V	ADC_A0_raw: 9204	V_adc_a0: 1.726 V	ADC_A1_raw: 9148	V_adc_a1: 1.715 V
Position: 35	DAC_Bits: 1447	V_set_dac: 1.767 V	V_set_pot: 1.768 V	ADC_A0_raw: 9472	V_adc_a0: 1.776 V	ADC_A1_raw: 9417	V_adc_a1: 1.766 V
Position: 36	DAC_Bits: 1489	V_set_dac: 1.818 V	V_set_pot: 1.818 V	ADC_A0_raw: 9747	V_adc_a0: 1.828 V	ADC_A1_raw: 9692	V_adc_a1: 1.817 V
Position: 37	DAC_Bits: 1530	V_set_dac: 1.868 V	V_set_pot: 1.869 V	ADC_A0_raw: 10014	V_adc_a0: 1.878 V	ADC_A1_raw: 9963	V_adc_a1: 1.868 V
Position: 38	DAC_Bits: 1571	V_set_dac: 1.918 V	V_set_pot: 1.919 V	ADC_A0_raw: 10287	V_adc_a0: 1.929 V	ADC_A1_raw: 10228	V_adc_a1: 1.918 V
Position: 39	DAC_Bits: 1613	V_set_dac: 1.969 V	V_set_pot: 1.970 V	ADC_A0_raw: 10562	V_adc_a0: 1.980 V	ADC_A1_raw: 10496	V_adc_a1: 1.968 V
Position: 40	DAC_Bits: 1654	V_set_dac: 2.020 V	V_set_pot: 2.020 V	ADC_A0_raw: 10823	V_adc_a0: 2.029 V	ADC_A1_raw: 10759	V_adc_a1: 2.017 V
Position: 41	DAC_Bits: 1695	V_set_dac: 2.070 V	V_set_pot: 2.071 V	ADC_A0_raw: 11096	V_adc_a0: 2.081 V	ADC_A1_raw: 11025	V_adc_a1: 2.067 V
Position: 42	DAC_Bits: 1737	V_set_dac: 2.121 V	V_set_pot: 2.121 V	ADC_A0_raw: 11363	V_adc_a0: 2.131 V	ADC_A1_raw: 11300	V_adc_a1: 2.119 V
Position: 43	DAC_Bits: 1778	V_set_dac: 2.171 V	V_set_pot: 2.172 V	ADC_A0_raw: 11640	V_adc_a0: 2.183 V	ADC_A1_raw: 11564	V_adc_a1: 2.168 V
Position: 44	DAC_Bits: 1820	V_set_dac: 2.222 V	V_set_pot: 2.222 V	ADC_A0_raw: 11909	V_adc_a0: 2.233 V	ADC_A1_raw: 11839	V_adc_a1: 2.220 V
Position: 45	DAC_Bits: 1861	V_set_dac: 2.272 V	V_set_pot: 2.273 V	ADC_A0_raw: 12183	V_adc_a0: 2.284 V	ADC_A1_raw: 12106	V_adc_a1: 2.270 V
Position: 46	DAC_Bits: 1902	V_set_dac: 2.322 V	V_set_pot: 2.323 V	ADC_A0_raw: 12450	V_adc_a0: 2.334 V	ADC_A1_raw: 12374	V_adc_a1: 2.320 V
Position: 47	DAC_Bits: 1944	V_set_dac: 2.374 V	V_set_pot: 2.374 V	ADC_A0_raw: 12726	V_adc_a0: 2.386 V	ADC_A1_raw: 12647	V_adc_a1: 2.371 V
Position: 48	DAC_Bits: 1985	V_set_dac: 2.424 V	V_set_pot: 2.424 V	ADC_A0_raw: 12991	V_adc_a0: 2.436 V	ADC_A1_raw: 12910	V_adc_a1: 2.421 V
Position: 49	DAC_Bits: 2026	V_set_dac: 2.474 V	V_set_pot: 2.475 V	ADC_A0_raw: 13262	V_adc_a0: 2.487 V	ADC_A1_raw: 13186	V_adc_a1: 2.472 V
Position: 50	DAC_Bits: 2068	V_set_dac: 2.525 V	V_set_pot: 2.525 V	ADC_A0_raw: 13534	V_adc_a0: 2.538 V	ADC_A1_raw: 13464	V_adc_a1: 2.525 V
Position: 51	DAC_Bits: 2109	V_set_dac: 2.575 V	V_set_pot: 2.576 V	ADC_A0_raw: 13809	V_adc_a0: 2.589 V	ADC_A1_raw: 13732	V_adc_a1: 2.575 V
Position: 52	DAC_Bits: 2150	V_set_dac: 2.625 V	V_set_pot: 2.626 V	ADC_A0_raw: 14078	V_adc_a0: 2.640 V	ADC_A1_raw: 14005	V_adc_a1: 2.626 V
Position: 53	DAC_Bits: 2192	V_set_dac: 2.676 V	V_set_pot: 2.677 V	ADC_A0_raw: 14348	V_adc_a0: 2.690 V	ADC_A1_raw: 14280	V_adc_a1: 2.678 V
Position: 54	DAC_Bits: 2233	V_set_dac: 2.726 V	V_set_pot: 2.727 V	ADC_A0_raw: 14621	V_adc_a0: 2.741 V	ADC_A1_raw: 14544	V_adc_a1: 2.727 V
Position: 55	DAC_Bits: 2275	V_set_dac: 2.778 V	V_set_pot: 2.778 V	ADC_A0_raw: 14898	V_adc_a0: 2.793 V	ADC_A1_raw: 14820	V_adc_a1: 2.779 V
Position: 56	DAC_Bits: 2316	V_set_dac: 2.828 V	V_set_pot: 2.828 V	ADC_A0_raw: 15168	V_adc_a0: 2.844 V	ADC_A1_raw: 15090	V_adc_a1: 2.829 V
Position: 57	DAC_Bits: 2357	V_set_dac: 2.878 V	V_set_pot: 2.879 V	ADC_A0_raw: 15444	V_adc_a0: 2.896 V	ADC_A1_raw: 15358	V_adc_a1: 2.880 V
Position: 58	DAC_Bits: 2399	V_set_dac: 2.929 V	V_set_pot: 2.929 V	ADC_A0_raw: 15715	V_adc_a0: 2.947 V	ADC_A1_raw: 15629	V_adc_a1: 2.930 V
Position: 59	DAC_Bits: 2440	V_set_dac: 2.979 V	V_set_pot: 2.980 V	ADC_A0_raw: 15984	V_adc_a0: 2.997 V	ADC_A1_raw: 15901	V_adc_a1: 2.981 V
Position: 60	DAC_Bits: 2481	V_set_dac: 3.029 V	V_set_pot: 3.030 V	ADC_A0_raw: 16259	V_adc_a0: 3.049 V	ADC_A1_raw: 16171	V_adc_a1: 3.032 V
Position: 61	DAC_Bits: 2523	V_set_dac: 3.081 V	V_set_pot: 3.081 V	ADC_A0_raw: 16528	V_adc_a0: 3.099 V	ADC_A1_raw: 16452	V_adc_a1: 3.085 V
Position: 62	DAC_Bits: 2564	V_set_dac: 3.131 V	V_set_pot: 3.131 V	ADC_A0_raw: 16794	V_adc_a0: 3.149 V	ADC_A1_raw: 16729	V_adc_a1: 3.137 V
Position: 63	DAC_Bits: 2605	V_set_dac: 3.181 V	V_set_pot: 3.182 V	ADC_A0_raw: 17068	V_adc_a0: 3.200 V	ADC_A1_raw: 16994	V_adc_a1: 3.186 V
Position: 64	DAC_Bits: 2647	V_set_dac: 3.232 V	V_set_pot: 3.232 V	ADC_A0_raw: 17338	V_adc_a0: 3.251 V	ADC_A1_raw: 17270	V_adc_a1: 3.238 V
Position: 65	DAC_Bits: 2688	V_set_dac: 3.282 V	V_set_pot: 3.283 V	ADC_A0_raw: 17611	V_adc_a0: 3.302 V	ADC_A1_raw: 17540	V_adc_a1: 3.289 V
Position: 66	DAC_Bits: 2730	V_set_dac: 3.333 V	V_set_pot: 3.333 V	ADC_A0_raw: 17886	V_adc_a0: 3.354 V	ADC_A1_raw: 17816	V_adc_a1: 3.341 V
Position: 67	DAC_Bits: 2771	V_set_dac: 3.383 V	V_set_pot: 3.384 V	ADC_A0_raw: 18155	V_adc_a0: 3.404 V	ADC_A1_raw: 18086	V_adc_a1: 3.391 V
Position: 68	DAC_Bits: 2812	V_set_dac: 3.433 V	V_set_pot: 3.434 V	ADC_A0_raw: 18425	V_adc_a0: 3.455 V	ADC_A1_raw: 18351	V_adc_a1: 3.441 V
Position: 69	DAC_Bits: 2854	V_set_dac: 3.485 V	V_set_pot: 3.485 V	ADC_A0_raw: 18702	V_adc_a0: 3.507 V	ADC_A1_raw: 18625	V_adc_a1: 3.492 V
Position: 70	DAC_Bits: 2895	V_set_dac: 3.535 V	V_set_pot: 3.535 V	ADC_A0_raw: 18968	V_adc_a0: 3.556 V	ADC_A1_raw: 18889	V_adc_a1: 3.542 V
Position: 71	DAC_Bits: 2936	V_set_dac: 3.585 V	V_set_pot: 3.586 V	ADC_A0_raw: 19241	V_adc_a0: 3.608 V	ADC_A1_raw: 19153	V_adc_a1: 3.591 V
Position: 72	DAC_Bits: 2978	V_set_dac: 3.636 V	V_set_pot: 3.636 V	ADC_A0_raw: 19508	V_adc_a0: 3.658 V	ADC_A1_raw: 19427	V_adc_a1: 3.643 V
Position: 73	DAC_Bits: 3019	V_set_dac: 3.686 V	V_set_pot: 3.687 V	ADC_A0_raw: 19763	V_adc_a0: 3.706 V	ADC_A1_raw: 19687	V_adc_a1: 3.691 V
Position: 74	DAC_Bits: 3060	V_set_dac: 3.736 V	V_set_pot: 3.737 V	ADC_A0_raw: 19971	V_adc_a0: 3.745 V	ADC_A1_raw: 19932	V_adc_a1: 3.737 V
Position: 75	DAC_Bits: 3102	V_set_dac: 3.788 V	V_set_pot: 3.788 V	ADC_A0_raw: 20113	V_adc_a0: 3.771 V	ADC_A1_raw: 20120	V_adc_a1: 3.773 V
Position: 76	DAC_Bits: 3143	V_set_dac: 3.838 V	V_set_pot: 3.838 V	ADC_A0_raw: 20187	V_adc_a0: 3.785 V	ADC_A1_raw: 20220	V_adc_a1: 3.791 V
Position: 77	DAC_Bits: 3185	V_set_dac: 3.889 V	V_set_pot: 3.889 V	ADC_A0_raw: 20230	V_adc_a0: 3.793 V	ADC_A1_raw: 20250	V_adc_a1: 3.797 V
Position: 78	DAC_Bits: 3226	V_set_dac: 3.939 V	V_set_pot: 3.939 V	ADC_A0_raw: 20250	V_adc_a0: 3.797 V	ADC_A1_raw: 20250	V_adc_a1: 3.797 V
Position: 79	DAC_Bits: 3267	V_set_dac: 3.989 V	V_set_pot: 3.990 V	ADC_A0_raw: 20230	V_adc_a0: 3.793 V	ADC_A1_raw: 20230	V_adc_a1: 3.793 V
Position: 80	DAC_Bits: 3309	V_set_dac: 4.040 V	V_set_pot: 4.040 V	ADC_A0_raw: 20189	V_adc_a0: 3.785 V	ADC_A1_raw: 20149	V_adc_a1: 3.778 V
Position: 81	DAC_Bits: 3350	V_set_dac: 4.090 V	V_set_pot: 4.091 V	ADC_A0_raw: 20169	V_adc_a0: 3.782 V	ADC_A1_raw: 20108	V_adc_a1: 3.770 V
Position: 82	DAC_Bits: 3391	V_set_dac: 4.140 V	V_set_pot: 4.141 V	ADC_A0_raw: 20149	V_adc_a0: 3.778 V	ADC_A1_raw: 20007	V_adc_a1: 3.751 V
Position: 83	DAC_Bits: 3433	V_set_dac: 4.192 V	V_set_pot: 4.192 V	ADC_A0_raw: 20149	V_adc_a0: 3.778 V	ADC_A1_raw: 19967	V_adc_a1: 3.744 V
Position: 84	DAC_Bits: 3474	V_set_dac: 4.242 V	V_set_pot: 4.242 V	ADC_A0_raw: 20149	V_adc_a0: 3.778 V	ADC_A1_raw: 19967	V_adc_a1: 3.744 V
Position: 85	DAC_Bits: 3515	V_set_dac: 4.292 V	V_set_pot: 4.293 V	ADC_A0_raw: 20129	V_adc_a0: 3.774 V	ADC_A1_raw: 19946	V_adc_a1: 3.740 V
Position: 86	DAC_Bits: 3557	V_set_dac: 4.343 V	V_set_pot: 4.343 V	ADC_A0_raw: 20108	V_adc_a0: 3.770 V	ADC_A1_raw: 19946	V_adc_a1: 3.740 V
Position: 87	DAC_Bits: 3598	V_set_dac: 4.393 V	V_set_pot: 4.394 V	ADC_A0_raw: 20088	V_adc_a0: 3.766 V	ADC_A1_raw: 19926	V_adc_a1: 3.736 V
Position: 88	DAC_Bits: 3640	V_set_dac: 4.444 V	V_set_pot: 4.444 V	ADC_A0_raw: 20088	V_adc_a0: 3.766 V	ADC_A1_raw: 19926	V_adc_a1: 3.736 V
Position: 89	DAC_Bits: 3681	V_set_dac: 4.495 V	V_set_pot: 4.495 V	ADC_A0_raw: 20088	V_adc_a0: 3.766 V	ADC_A1_raw: 19906	V_adc_a1: 3.732 V
Position: 90	DAC_Bits: 3722	V_set_dac: 4.545 V	V_set_pot: 4.545 V	ADC_A0_raw: 20088	V_adc_a0: 3.766 V	ADC_A1_raw: 19906	V_adc_a1: 3.732 V
Position: 91	DAC_Bits: 3764	V_set_dac: 4.596 V	V_set_pot: 4.596 V	ADC_A0_raw: 20048	V_adc_a0: 3.759 V	ADC_A1_raw: 19886	V_adc_a1: 3.729 V
Position: 92	DAC_Bits: 3805	V_set_dac: 4.646 V	V_set_pot: 4.646 V	ADC_A0_raw: 20027	V_adc_a0: 3.755 V	ADC_A1_raw: 19865	V_adc_a1: 3.725 V
Position: 93	DAC_Bits: 3846	V_set_dac: 4.696 V	V_set_pot: 4.697 V	ADC_A0_raw: 19987	V_adc_a0: 3.748 V	ADC_A1_raw: 19865	V_adc_a1: 3.725 V
Position: 94	DAC_Bits: 3888	V_set_dac: 4.747 V	V_set_pot: 4.747 V	ADC_A0_raw: 19967	V_adc_a0: 3.744 V	ADC_A1_raw: 19865	V_adc_a1: 3.725 V
Position: 95	DAC_Bits: 3929	V_set_dac: 4.797 V	V_set_pot: 4.798 V	ADC_A0_raw: 19946	V_adc_a0: 3.740 V	ADC_A1_raw: 19845	V_adc_a1: 3.721 V
Position: 96	DAC_Bits: 3970	V_set_dac: 4.847 V	V_set_pot: 4.848 V	ADC_A0_raw: 19926	V_adc_a0: 3.736 V	ADC_A1_raw: 19825	V_adc_a1: 3.717 V
Position: 97	DAC_Bits: 4012	V_set_dac: 4.899 V	V_set_pot: 4.899 V	ADC_A0_raw: 19886	V_adc_a0: 3.729 V	ADC_A1_raw: 19805	V_adc_a1: 3.713 V
Position: 98	DAC_Bits: 4053	V_set_dac: 4.949 V	V_set_pot: 4.949 V	ADC_A0_raw: 19805	V_adc_a0: 3.713 V	ADC_A1_raw: 19784	V_adc_a1: 3.710 V
Position: 99	DAC_Bits: 4095	V_set_dac: 5.000 V	V_set_pot: 5.000 V	ADC_A0_raw: 19541	V_adc_a0: 3.664 V	ADC_A1_raw: 19703	V_adc_a1: 3.694 V
Position: 99	DAC_Bits: 4095	V_set_dac: 5.000 V	V_set_pot: 5.000 V	ADC_A0_raw: 19602	V_adc_a0: 3.675 V	ADC_A1_raw: 19724	V_adc_a1: 3.698 V
Position: 98	DAC_Bits: 4053	V_set_dac: 4.949 V	V_set_pot: 4.949 V	ADC_A0_raw: 19805	V_adc_a0: 3.713 V	ADC_A1_raw: 19784	V_adc_a1: 3.710 V
Position: 97	DAC_Bits: 4012	V_set_dac: 4.899 V	V_set_pot: 4.899 V	ADC_A0_raw: 19886	V_adc_a0: 3.729 V	ADC_A1_raw: 19784	V_adc_a1: 3.710 V
Position: 96	DAC_Bits: 3970	V_set_dac: 4.847 V	V_set_pot: 4.848 V	ADC_A0_raw: 19886	V_adc_a0: 3.729 V	ADC_A1_raw: 19825	V_adc_a1: 3.717 V
Position: 95	DAC_Bits: 3929	V_set_dac: 4.797 V	V_set_pot: 4.798 V	ADC_A0_raw: 19926	V_adc_a0: 3.736 V	ADC_A1_raw: 19845	V_adc_a1: 3.721 V
Position: 94	DAC_Bits: 3888	V_set_dac: 4.747 V	V_set_pot: 4.747 V	ADC_A0_raw: 19967	V_adc_a0: 3.744 V	ADC_A1_raw: 19845	V_adc_a1: 3.721 V
Position: 93	DAC_Bits: 3846	V_set_dac: 4.696 V	V_set_pot: 4.697 V	ADC_A0_raw: 19987	V_adc_a0: 3.748 V	ADC_A1_raw: 19845	V_adc_a1: 3.721 V
Position: 92	DAC_Bits: 3805	V_set_dac: 4.646 V	V_set_pot: 4.646 V	ADC_A0_raw: 20007	V_adc_a0: 3.751 V	ADC_A1_raw: 19865	V_adc_a1: 3.725 V
Position: 91	DAC_Bits: 3764	V_set_dac: 4.596 V	V_set_pot: 4.596 V	ADC_A0_raw: 20048	V_adc_a0: 3.759 V	ADC_A1_raw: 19886	V_adc_a1: 3.729 V
Position: 90	DAC_Bits: 3722	V_set_dac: 4.545 V	V_set_pot: 4.545 V	ADC_A0_raw: 20088	V_adc_a0: 3.766 V	ADC_A1_raw: 19886	V_adc_a1: 3.729 V
Position: 89	DAC_Bits: 3681	V_set_dac: 4.495 V	V_set_pot: 4.495 V	ADC_A0_raw: 20088	V_adc_a0: 3.766 V	ADC_A1_raw: 19906	V_adc_a1: 3.732 V
Position: 88	DAC_Bits: 3640	V_set_dac: 4.444 V	V_set_pot: 4.444 V	ADC_A0_raw: 20088	V_adc_a0: 3.766 V	ADC_A1_raw: 19906	V_adc_a1: 3.732 V
Position: 87	DAC_Bits: 3598	V_set_dac: 4.393 V	V_set_pot: 4.394 V	ADC_A0_raw: 20068	V_adc_a0: 3.763 V	ADC_A1_raw: 19926	V_adc_a1: 3.736 V
Position: 86	DAC_Bits: 3557	V_set_dac: 4.343 V	V_set_pot: 4.343 V	ADC_A0_raw: 20068	V_adc_a0: 3.763 V	ADC_A1_raw: 19926	V_adc_a1: 3.736 V
Position: 85	DAC_Bits: 3515	V_set_dac: 4.292 V	V_set_pot: 4.293 V	ADC_A0_raw: 20088	V_adc_a0: 3.766 V	ADC_A1_raw: 19946	V_adc_a1: 3.740 V
Position: 84	DAC_Bits: 3474	V_set_dac: 4.242 V	V_set_pot: 4.242 V	ADC_A0_raw: 20108	V_adc_a0: 3.770 V	ADC_A1_raw: 19946	V_adc_a1: 3.740 V
Position: 83	DAC_Bits: 3433	V_set_dac: 4.192 V	V_set_pot: 4.192 V	ADC_A0_raw: 20129	V_adc_a0: 3.774 V	ADC_A1_raw: 19967	V_adc_a1: 3.744 V
Position: 82	DAC_Bits: 3391	V_set_dac: 4.140 V	V_set_pot: 4.141 V	ADC_A0_raw: 20129	V_adc_a0: 3.774 V	ADC_A1_raw: 19987	V_adc_a1: 3.748 V
Position: 81	DAC_Bits: 3350	V_set_dac: 4.090 V	V_set_pot: 4.091 V	ADC_A0_raw: 20129	V_adc_a0: 3.774 V	ADC_A1_raw: 20088	V_adc_a1: 3.766 V
Position: 80	DAC_Bits: 3309	V_set_dac: 4.040 V	V_set_pot: 4.040 V	ADC_A0_raw: 20169	V_adc_a0: 3.782 V	ADC_A1_raw: 20129	V_adc_a1: 3.774 V
Position: 79	DAC_Bits: 3267	V_set_dac: 3.989 V	V_set_pot: 3.990 V	ADC_A0_raw: 20210	V_adc_a0: 3.789 V	ADC_A1_raw: 20189	V_adc_a1: 3.785 V
Position: 78	DAC_Bits: 3226	V_set_dac: 3.939 V	V_set_pot: 3.939 V	ADC_A0_raw: 20210	V_adc_a0: 3.789 V	ADC_A1_raw: 20230	V_adc_a1: 3.793 V
Position: 77	DAC_Bits: 3185	V_set_dac: 3.889 V	V_set_pot: 3.889 V	ADC_A0_raw: 20210	V_adc_a0: 3.789 V	ADC_A1_raw: 20230	V_adc_a1: 3.793 V
Position: 76	DAC_Bits: 3143	V_set_dac: 3.838 V	V_set_pot: 3.838 V	ADC_A0_raw: 20170	V_adc_a0: 3.782 V	ADC_A1_raw: 20206	V_adc_a1: 3.789 V
Position: 75	DAC_Bits: 3102	V_set_dac: 3.788 V	V_set_pot: 3.788 V	ADC_A0_raw: 20097	V_adc_a0: 3.768 V	ADC_A1_raw: 20110	V_adc_a1: 3.771 V
Position: 74	DAC_Bits: 3060	V_set_dac: 3.736 V	V_set_pot: 3.737 V	ADC_A0_raw: 19965	V_adc_a0: 3.743 V	ADC_A1_raw: 19929	V_adc_a1: 3.737 V
Position: 73	DAC_Bits: 3019	V_set_dac: 3.686 V	V_set_pot: 3.687 V	ADC_A0_raw: 19763	V_adc_a0: 3.706 V	ADC_A1_raw: 19689	V_adc_a1: 3.692 V
Position: 72	DAC_Bits: 2978	V_set_dac: 3.636 V	V_set_pot: 3.636 V	ADC_A0_raw: 19507	V_adc_a0: 3.658 V	ADC_A1_raw: 19427	V_adc_a1: 3.643 V
Position: 71	DAC_Bits: 2936	V_set_dac: 3.585 V	V_set_pot: 3.586 V	ADC_A0_raw: 19242	V_adc_a0: 3.608 V	ADC_A1_raw: 19155	V_adc_a1: 3.592 V
Position: 70	DAC_Bits: 2895	V_set_dac: 3.535 V	V_set_pot: 3.535 V	ADC_A0_raw: 18971	V_adc_a0: 3.557 V	ADC_A1_raw: 18887	V_adc_a1: 3.541 V
Position: 69	DAC_Bits: 2854	V_set_dac: 3.485 V	V_set_pot: 3.485 V	ADC_A0_raw: 18700	V_adc_a0: 3.506 V	ADC_A1_raw: 18625	V_adc_a1: 3.492 V
Position: 68	DAC_Bits: 2812	V_set_dac: 3.433 V	V_set_pot: 3.434 V	ADC_A0_raw: 18424	V_adc_a0: 3.454 V	ADC_A1_raw: 18353	V_adc_a1: 3.441 V
Position: 67	DAC_Bits: 2771	V_set_dac: 3.383 V	V_set_pot: 3.384 V	ADC_A0_raw: 18155	V_adc_a0: 3.404 V	ADC_A1_raw: 18084	V_adc_a1: 3.391 V
Position: 66	DAC_Bits: 2730	V_set_dac: 3.333 V	V_set_pot: 3.333 V	ADC_A0_raw: 17884	V_adc_a0: 3.353 V	ADC_A1_raw: 17816	V_adc_a1: 3.341 V
Position: 65	DAC_Bits: 2688	V_set_dac: 3.282 V	V_set_pot: 3.283 V	ADC_A0_raw: 17618	V_adc_a0: 3.303 V	ADC_A1_raw: 17539	V_adc_a1: 3.289 V
Position: 64	DAC_Bits: 2647	V_set_dac: 3.232 V	V_set_pot: 3.232 V	ADC_A0_raw: 17340	V_adc_a0: 3.251 V	ADC_A1_raw: 17270	V_adc_a1: 3.238 V
Position: 63	DAC_Bits: 2605	V_set_dac: 3.181 V	V_set_pot: 3.182 V	ADC_A0_raw: 17068	V_adc_a0: 3.200 V	ADC_A1_raw: 16996	V_adc_a1: 3.187 V
Position: 62	DAC_Bits: 2564	V_set_dac: 3.131 V	V_set_pot: 3.131 V	ADC_A0_raw: 16799	V_adc_a0: 3.150 V	ADC_A1_raw: 16729	V_adc_a1: 3.137 V
Position: 61	DAC_Bits: 2523	V_set_dac: 3.081 V	V_set_pot: 3.081 V	ADC_A0_raw: 16526	V_adc_a0: 3.099 V	ADC_A1_raw: 16452	V_adc_a1: 3.085 V
Position: 60	DAC_Bits: 2481	V_set_dac: 3.029 V	V_set_pot: 3.030 V	ADC_A0_raw: 16258	V_adc_a0: 3.048 V	ADC_A1_raw: 16170	V_adc_a1: 3.032 V
Position: 59	DAC_Bits: 2440	V_set_dac: 2.979 V	V_set_pot: 2.980 V	ADC_A0_raw: 15983	V_adc_a0: 2.997 V	ADC_A1_raw: 15899	V_adc_a1: 2.981 V
Position: 58	DAC_Bits: 2399	V_set_dac: 2.929 V	V_set_pot: 2.929 V	ADC_A0_raw: 15715	V_adc_a0: 2.947 V	ADC_A1_raw: 15630	V_adc_a1: 2.931 V
Position: 57	DAC_Bits: 2357	V_set_dac: 2.878 V	V_set_pot: 2.879 V	ADC_A0_raw: 15438	V_adc_a0: 2.895 V	ADC_A1_raw: 15356	V_adc_a1: 2.879 V
Position: 56	DAC_Bits: 2316	V_set_dac: 2.828 V	V_set_pot: 2.828 V	ADC_A0_raw: 15160	V_adc_a0: 2.842 V	ADC_A1_raw: 15090	V_adc_a1: 2.829 V
Position: 55	DAC_Bits: 2275	V_set_dac: 2.778 V	V_set_pot: 2.778 V	ADC_A0_raw: 14895	V_adc_a0: 2.793 V	ADC_A1_raw: 14820	V_adc_a1: 2.779 V
Position: 54	DAC_Bits: 2233	V_set_dac: 2.726 V	V_set_pot: 2.727 V	ADC_A0_raw: 14631	V_adc_a0: 2.743 V	ADC_A1_raw: 14545	V_adc_a1: 2.727 V
Position: 53	DAC_Bits: 2192	V_set_dac: 2.676 V	V_set_pot: 2.677 V	ADC_A0_raw: 14354	V_adc_a0: 2.691 V	ADC_A1_raw: 14281	V_adc_a1: 2.678 V
Position: 52	DAC_Bits: 2150	V_set_dac: 2.625 V	V_set_pot: 2.626 V	ADC_A0_raw: 14080	V_adc_a0: 2.640 V	ADC_A1_raw: 14005	V_adc_a1: 2.626 V
Position: 51	DAC_Bits: 2109	V_set_dac: 2.575 V	V_set_pot: 2.576 V	ADC_A0_raw: 13805	V_adc_a0: 2.588 V	ADC_A1_raw: 13732	V_adc_a1: 2.575 V
Position: 50	DAC_Bits: 2068	V_set_dac: 2.525 V	V_set_pot: 2.525 V	ADC_A0_raw: 13531	V_adc_a0: 2.537 V	ADC_A1_raw: 13464	V_adc_a1: 2.525 V
Position: 49	DAC_Bits: 2026	V_set_dac: 2.474 V	V_set_pot: 2.475 V	ADC_A0_raw: 13258	V_adc_a0: 2.486 V	ADC_A1_raw: 13185	V_adc_a1: 2.472 V
Position: 48	DAC_Bits: 1985	V_set_dac: 2.424 V	V_set_pot: 2.424 V	ADC_A0_raw: 12998	V_adc_a0: 2.437 V	ADC_A1_raw: 12911	V_adc_a1: 2.421 V
Position: 47	DAC_Bits: 1944	V_set_dac: 2.374 V	V_set_pot: 2.374 V	ADC_A0_raw: 12723	V_adc_a0: 2.386 V	ADC_A1_raw: 12646	V_adc_a1: 2.371 V
Position: 46	DAC_Bits: 1902	V_set_dac: 2.322 V	V_set_pot: 2.323 V	ADC_A0_raw: 12452	V_adc_a0: 2.335 V	ADC_A1_raw: 12374	V_adc_a1: 2.320 V
Position: 45	DAC_Bits: 1861	V_set_dac: 2.272 V	V_set_pot: 2.273 V	ADC_A0_raw: 12179	V_adc_a0: 2.284 V	ADC_A1_raw: 12108	V_adc_a1: 2.270 V
Position: 44	DAC_Bits: 1820	V_set_dac: 2.222 V	V_set_pot: 2.222 V	ADC_A0_raw: 11907	V_adc_a0: 2.233 V	ADC_A1_raw: 11840	V_adc_a1: 2.220 V
Position: 43	DAC_Bits: 1778	V_set_dac: 2.171 V	V_set_pot: 2.172 V	ADC_A0_raw: 11636	V_adc_a0: 2.182 V	ADC_A1_raw: 11564	V_adc_a1: 2.168 V
Position: 42	DAC_Bits: 1737	V_set_dac: 2.121 V	V_set_pot: 2.121 V	ADC_A0_raw: 11368	V_adc_a0: 2.132 V	ADC_A1_raw: 11301	V_adc_a1: 2.119 V
Position: 41	DAC_Bits: 1695	V_set_dac: 2.070 V	V_set_pot: 2.071 V	ADC_A0_raw: 11103	V_adc_a0: 2.082 V	ADC_A1_raw: 11025	V_adc_a1: 2.067 V
Position: 40	DAC_Bits: 1654	V_set_dac: 2.020 V	V_set_pot: 2.020 V	ADC_A0_raw: 10830	V_adc_a0: 2.031 V	ADC_A1_raw: 10759	V_adc_a1: 2.017 V
Position: 39	DAC_Bits: 1613	V_set_dac: 1.969 V	V_set_pot: 1.970 V	ADC_A0_raw: 10557	V_adc_a0: 1.979 V	ADC_A1_raw: 10496	V_adc_a1: 1.968 V
Position: 38	DAC_Bits: 1571	V_set_dac: 1.918 V	V_set_pot: 1.919 V	ADC_A0_raw: 10280	V_adc_a0: 1.928 V	ADC_A1_raw: 10228	V_adc_a1: 1.918 V
Position: 37	DAC_Bits: 1530	V_set_dac: 1.868 V	V_set_pot: 1.869 V	ADC_A0_raw: 10024	V_adc_a0: 1.880 V	ADC_A1_raw: 9964	V_adc_a1: 1.868 V
Position: 36	DAC_Bits: 1489	V_set_dac: 1.818 V	V_set_pot: 1.818 V	ADC_A0_raw: 9751	V_adc_a0: 1.828 V	ADC_A1_raw: 9692	V_adc_a1: 1.817 V
Position: 35	DAC_Bits: 1447	V_set_dac: 1.767 V	V_set_pot: 1.768 V	ADC_A0_raw: 9475	V_adc_a0: 1.777 V	ADC_A1_raw: 9417	V_adc_a1: 1.766 V
Position: 34	DAC_Bits: 1406	V_set_dac: 1.717 V	V_set_pot: 1.717 V	ADC_A0_raw: 9202	V_adc_a0: 1.725 V	ADC_A1_raw: 9149	V_adc_a1: 1.715 V
Position: 33	DAC_Bits: 1365	V_set_dac: 1.667 V	V_set_pot: 1.667 V	ADC_A0_raw: 8928	V_adc_a0: 1.674 V	ADC_A1_raw: 8880	V_adc_a1: 1.665 V
Position: 32	DAC_Bits: 1323	V_set_dac: 1.615 V	V_set_pot: 1.616 V	ADC_A0_raw: 8660	V_adc_a0: 1.624 V	ADC_A1_raw: 8607	V_adc_a1: 1.614 V
Position: 31	DAC_Bits: 1282	V_set_dac: 1.565 V	V_set_pot: 1.566 V	ADC_A0_raw: 8391	V_adc_a0: 1.573 V	ADC_A1_raw: 8341	V_adc_a1: 1.564 V
Position: 30	DAC_Bits: 1240	V_set_dac: 1.514 V	V_set_pot: 1.515 V	ADC_A0_raw: 8121	V_adc_a0: 1.523 V	ADC_A1_raw: 8069	V_adc_a1: 1.513 V
Position: 29	DAC_Bits: 1199	V_set_dac: 1.464 V	V_set_pot: 1.465 V	ADC_A0_raw: 7848	V_adc_a0: 1.472 V	ADC_A1_raw: 7805	V_adc_a1: 1.463 V
Position: 28	DAC_Bits: 1158	V_set_dac: 1.414 V	V_set_pot: 1.414 V	ADC_A0_raw: 7578	V_adc_a0: 1.421 V	ADC_A1_raw: 7540	V_adc_a1: 1.414 V
Position: 27	DAC_Bits: 1116	V_set_dac: 1.363 V	V_set_pot: 1.364 V	ADC_A0_raw: 7308	V_adc_a0: 1.370 V	ADC_A1_raw: 7266	V_adc_a1: 1.362 V
Position: 26	DAC_Bits: 1075	V_set_dac: 1.313 V	V_set_pot: 1.313 V	ADC_A0_raw: 7036	V_adc_a0: 1.319 V	ADC_A1_raw: 6999	V_adc_a1: 1.312 V
Position: 25	DAC_Bits: 1034	V_set_dac: 1.263 V	V_set_pot: 1.263 V	ADC_A0_raw: 6766	V_adc_a0: 1.269 V	ADC_A1_raw: 6731	V_adc_a1: 1.262 V
Position: 24	DAC_Bits: 992	V_set_dac: 1.211 V	V_set_pot: 1.212 V	ADC_A0_raw: 6496	V_adc_a0: 1.218 V	ADC_A1_raw: 6448	V_adc_a1: 1.209 V
Position: 23	DAC_Bits: 951	V_set_dac: 1.161 V	V_set_pot: 1.162 V	ADC_A0_raw: 6227	V_adc_a0: 1.168 V	ADC_A1_raw: 6176	V_adc_a1: 1.158 V
Position: 22	DAC_Bits: 910	V_set_dac: 1.111 V	V_set_pot: 1.111 V	ADC_A0_raw: 5957	V_adc_a0: 1.117 V	ADC_A1_raw: 5913	V_adc_a1: 1.109 V
Position: 21	DAC_Bits: 868	V_set_dac: 1.060 V	V_set_pot: 1.061 V	ADC_A0_raw: 5688	V_adc_a0: 1.067 V	ADC_A1_raw: 5638	V_adc_a1: 1.057 V
Position: 20	DAC_Bits: 827	V_set_dac: 1.010 V	V_set_pot: 1.010 V	ADC_A0_raw: 5411	V_adc_a0: 1.015 V	ADC_A1_raw: 5368	V_adc_a1: 1.007 V
Position: 19	DAC_Bits: 785	V_set_dac: 0.958 V	V_set_pot: 0.960 V	ADC_A0_raw: 5144	V_adc_a0: 0.965 V	ADC_A1_raw: 5094	V_adc_a1: 0.955 V
Position: 18	DAC_Bits: 744	V_set_dac: 0.908 V	V_set_pot: 0.909 V	ADC_A0_raw: 4873	V_adc_a0: 0.914 V	ADC_A1_raw: 4829	V_adc_a1: 0.905 V
Position: 17	DAC_Bits: 703	V_set_dac: 0.858 V	V_set_pot: 0.859 V	ADC_A0_raw: 4602	V_adc_a0: 0.863 V	ADC_A1_raw: 4564	V_adc_a1: 0.856 V
Position: 16	DAC_Bits: 661	V_set_dac: 0.807 V	V_set_pot: 0.808 V	ADC_A0_raw: 4332	V_adc_a0: 0.812 V	ADC_A1_raw: 4293	V_adc_a1: 0.805 V
Position: 15	DAC_Bits: 620	V_set_dac: 0.757 V	V_set_pot: 0.758 V	ADC_A0_raw: 4058	V_adc_a0: 0.761 V	ADC_A1_raw: 4029	V_adc_a1: 0.755 V
Position: 14	DAC_Bits: 579	V_set_dac: 0.707 V	V_set_pot: 0.707 V	ADC_A0_raw: 3785	V_adc_a0: 0.710 V	ADC_A1_raw: 3763	V_adc_a1: 0.706 V
Position: 13	DAC_Bits: 537	V_set_dac: 0.656 V	V_set_pot: 0.657 V	ADC_A0_raw: 3516	V_adc_a0: 0.659 V	ADC_A1_raw: 3490	V_adc_a1: 0.654 V
Position: 12	DAC_Bits: 496	V_set_dac: 0.606 V	V_set_pot: 0.606 V	ADC_A0_raw: 3245	V_adc_a0: 0.608 V	ADC_A1_raw: 3220	V_adc_a1: 0.604 V
Position: 11	DAC_Bits: 455	V_set_dac: 0.556 V	V_set_pot: 0.556 V	ADC_A0_raw: 2974	V_adc_a0: 0.558 V	ADC_A1_raw: 2948	V_adc_a1: 0.553 V
Position: 10	DAC_Bits: 413	V_set_dac: 0.504 V	V_set_pot: 0.505 V	ADC_A0_raw: 2703	V_adc_a0: 0.507 V	ADC_A1_raw: 2677	V_adc_a1: 0.502 V
Position: 9	DAC_Bits: 372	V_set_dac: 0.454 V	V_set_pot: 0.455 V	ADC_A0_raw: 2432	V_adc_a0: 0.456 V	ADC_A1_raw: 2413	V_adc_a1: 0.452 V
Position: 8	DAC_Bits: 330	V_set_dac: 0.403 V	V_set_pot: 0.404 V	ADC_A0_raw: 2165	V_adc_a0: 0.406 V	ADC_A1_raw: 2144	V_adc_a1: 0.402 V
Position: 7	DAC_Bits: 289	V_set_dac: 0.353 V	V_set_pot: 0.354 V	ADC_A0_raw: 1892	V_adc_a0: 0.355 V	ADC_A1_raw: 1878	V_adc_a1: 0.352 V
Position: 6	DAC_Bits: 248	V_set_dac: 0.303 V	V_set_pot: 0.303 V	ADC_A0_raw: 1622	V_adc_a0: 0.304 V	ADC_A1_raw: 1611	V_adc_a1: 0.302 V
Position: 5	DAC_Bits: 206	V_set_dac: 0.252 V	V_set_pot: 0.253 V	ADC_A0_raw: 1348	V_adc_a0: 0.253 V	ADC_A1_raw: 1338	V_adc_a1: 0.251 V
Position: 4	DAC_Bits: 165	V_set_dac: 0.201 V	V_set_pot: 0.202 V	ADC_A0_raw: 1078	V_adc_a0: 0.202 V	ADC_A1_raw: 1069	V_adc_a1: 0.200 V
Position: 3	DAC_Bits: 124	V_set_dac: 0.151 V	V_set_pot: 0.152 V	ADC_A0_raw: 809	V_adc_a0: 0.152 V	ADC_A1_raw: 798	V_adc_a1: 0.150 V
Position: 2	DAC_Bits: 82	V_set_dac: 0.100 V	V_set_pot: 0.101 V	ADC_A0_raw: 536	V_adc_a0: 0.101 V	ADC_A1_raw: 527	V_adc_a1: 0.099 V
Position: 1	DAC_Bits: 41	V_set_dac: 0.050 V	V_set_pot: 0.051 V	ADC_A0_raw: 263	V_adc_a0: 0.049 V	ADC_A1_raw: 261	V_adc_a1: 0.049 V
Position: 0	DAC_Bits: 0	V_set_dac: 0.000 V	V_set_pot: 0.000 V	ADC_A0_raw: -6	V_adc_a0: -0.001 V	ADC_A1_raw: 0	V_adc_a1: 0.000 V
Position: 0	DAC_Bits: 0	V_set_dac: 0.000 V	V_set_pot: 0.000 V	ADC_A0_raw: -7	V_adc_a0: -0.001 V	ADC_A1_raw: 0	V_adc_a1: 0.000 V
Position: 1	DAC_Bits: 41	V_set_dac: 0.050 V	V_set_pot: 0.051 V	ADC_A0_raw: 263	V_adc_a0: 0.049 V	ADC_A1_raw: 262	V_adc_a1: 0.049 V
Position: 2	DAC_Bits: 82	V_set_dac: 0.100 V	V_set_pot: 0.101 V	ADC_A0_raw: 535	V_adc_a0: 0.100 V	ADC_A1_raw: 527	V_adc_a1: 0.099 V
Position: 3	DAC_Bits: 124	V_set_dac: 0.151 V	V_set_pot: 0.152 V	ADC_A0_raw: 807	V_adc_a0: 0.151 V	ADC_A1_raw: 798	V_adc_a1: 0.150 V
Position: 4	DAC_Bits: 165	V_set_dac: 0.201 V	V_set_pot: 0.202 V	ADC_A0_raw: 1078	V_adc_a0: 0.202 V	ADC_A1_raw: 1069	V_adc_a1: 0.200 V
Position: 5	DAC_Bits: 206	V_set_dac: 0.252 V	V_set_pot: 0.253 V	ADC_A0_raw: 1350	V_adc_a0: 0.253 V	ADC_A1_raw: 1338	V_adc_a1: 0.251 V
Position: 6	DAC_Bits: 248	V_set_dac: 0.303 V	V_set_pot: 0.303 V	ADC_A0_raw: 1620	V_adc_a0: 0.304 V	ADC_A1_raw: 1611	V_adc_a1: 0.302 V
Position: 7	DAC_Bits: 289	V_set_dac: 0.353 V	V_set_pot: 0.354 V	ADC_A0_raw: 1892	V_adc_a0: 0.355 V	ADC_A1_raw: 1878	V_adc_a1: 0.352 V
Position: 8	DAC_Bits: 330	V_set_dac: 0.403 V	V_set_pot: 0.404 V	ADC_A0_raw: 2164	V_adc_a0: 0.406 V	ADC_A1_raw: 2143	V_adc_a1: 0.402 V
Position: 9	DAC_Bits: 372	V_set_dac: 0.454 V	V_set_pot: 0.455 V	ADC_A0_raw: 2431	V_adc_a0: 0.456 V	ADC_A1_raw: 2413	V_adc_a1: 0.452 V
Position: 10	DAC_Bits: 413	V_set_dac: 0.504 V	V_set_pot: 0.505 V	ADC_A0_raw: 2700	V_adc_a0: 0.506 V	ADC_A1_raw: 2676	V_adc_a1: 0.502 V
Position: 11	DAC_Bits: 455	V_set_dac: 0.556 V	V_set_pot: 0.556 V	ADC_A0_raw: 2978	V_adc_a0: 0.558 V	ADC_A1_raw: 2947	V_adc_a1: 0.553 V
Position: 12	DAC_Bits: 496	V_set_dac: 0.606 V	V_set_pot: 0.606 V	ADC_A0_raw: 3244	V_adc_a0: 0.608 V	ADC_A1_raw: 3221	V_adc_a1: 0.604 V
Position: 13	DAC_Bits: 537	V_set_dac: 0.656 V	V_set_pot: 0.657 V	ADC_A0_raw: 3516	V_adc_a0: 0.659 V	ADC_A1_raw: 3491	V_adc_a1: 0.655 V
Position: 14	DAC_Bits: 579	V_set_dac: 0.707 V	V_set_pot: 0.707 V	ADC_A0_raw: 3782	V_adc_a0: 0.709 V	ADC_A1_raw: 3763	V_adc_a1: 0.706 V
Position: 15	DAC_Bits: 620	V_set_dac: 0.757 V	V_set_pot: 0.758 V	ADC_A0_raw: 4056	V_adc_a0: 0.761 V	ADC_A1_raw: 4029	V_adc_a1: 0.755 V
Position: 16	DAC_Bits: 661	V_set_dac: 0.807 V	V_set_pot: 0.808 V	ADC_A0_raw: 4331	V_adc_a0: 0.812 V	ADC_A1_raw: 4294	V_adc_a1: 0.805 V
Position: 17	DAC_Bits: 703	V_set_dac: 0.858 V	V_set_pot: 0.859 V	ADC_A0_raw: 4600	V_adc_a0: 0.863 V	ADC_A1_raw: 4564	V_adc_a1: 0.856 V
Position: 18	DAC_Bits: 744	V_set_dac: 0.908 V	V_set_pot: 0.909 V	ADC_A0_raw: 4871	V_adc_a0: 0.913 V	ADC_A1_raw: 4829	V_adc_a1: 0.905 V
Position: 19	DAC_Bits: 785	V_set_dac: 0.958 V	V_set_pot: 0.960 V	ADC_A0_raw: 5141	V_adc_a0: 0.964 V	ADC_A1_raw: 5094	V_adc_a1: 0.955 V
Position: 20	DAC_Bits: 827	V_set_dac: 1.010 V	V_set_pot: 1.010 V	ADC_A0_raw: 5411	V_adc_a0: 1.015 V	ADC_A1_raw: 5369	V_adc_a1: 1.007 V
Position: 21	DAC_Bits: 868	V_set_dac: 1.060 V	V_set_pot: 1.061 V	ADC_A0_raw: 5686	V_adc_a0: 1.066 V	ADC_A1_raw: 5637	V_adc_a1: 1.057 V
Position: 22	DAC_Bits: 910	V_set_dac: 1.111 V	V_set_pot: 1.111 V	ADC_A0_raw: 5960	V_adc_a0: 1.118 V	ADC_A1_raw: 5913	V_adc_a1: 1.109 V
Position: 23	DAC_Bits: 951	V_set_dac: 1.161 V	V_set_pot: 1.162 V	ADC_A0_raw: 6230	V_adc_a0: 1.168 V	ADC_A1_raw: 6176	V_adc_a1: 1.158 V
Position: 24	DAC_Bits: 992	V_set_dac: 1.211 V	V_set_pot: 1.212 V	ADC_A0_raw: 6497	V_adc_a0: 1.218 V	ADC_A1_raw: 6449	V_adc_a1: 1.209 V
Position: 25	DAC_Bits: 1034	V_set_dac: 1.263 V	V_set_pot: 1.263 V	ADC_A0_raw: 6768	V_adc_a0: 1.269 V	ADC_A1_raw: 6731	V_adc_a1: 1.262 V
Position: 26	DAC_Bits: 1075	V_set_dac: 1.313 V	V_set_pot: 1.313 V	ADC_A0_raw: 7035	V_adc_a0: 1.319 V	ADC_A1_raw: 7000	V_adc_a1: 1.312 V
Position: 27	DAC_Bits: 1116	V_set_dac: 1.363 V	V_set_pot: 1.364 V	ADC_A0_raw: 7307	V_adc_a0: 1.370 V	ADC_A1_raw: 7267	V_adc_a1: 1.363 V
Position: 28	DAC_Bits: 1158	V_set_dac: 1.414 V	V_set_pot: 1.414 V	ADC_A0_raw: 7580	V_adc_a0: 1.421 V	ADC_A1_raw: 7540	V_adc_a1: 1.414 V
Position: 29	DAC_Bits: 1199	V_set_dac: 1.464 V	V_set_pot: 1.465 V	ADC_A0_raw: 7849	V_adc_a0: 1.472 V	ADC_A1_raw: 7806	V_adc_a1: 1.464 V
Position: 30	DAC_Bits: 1240	V_set_dac: 1.514 V	V_set_pot: 1.515 V	ADC_A0_raw: 8123	V_adc_a0: 1.523 V	ADC_A1_raw: 8070	V_adc_a1: 1.513 V
Position: 31	DAC_Bits: 1282	V_set_dac: 1.565 V	V_set_pot: 1.566 V	ADC_A0_raw: 8389	V_adc_a0: 1.573 V	ADC_A1_raw: 8342	V_adc_a1: 1.564 V
Position: 32	DAC_Bits: 1323	V_set_dac: 1.615 V	V_set_pot: 1.616 V	ADC_A0_raw: 8660	V_adc_a0: 1.624 V	ADC_A1_raw: 8607	V_adc_a1: 1.614 V
Position: 33	DAC_Bits: 1365	V_set_dac: 1.667 V	V_set_pot: 1.667 V	ADC_A0_raw: 8928	V_adc_a0: 1.674 V	ADC_A1_raw: 8880	V_adc_a1: 1.665 V
Position: 34	DAC_Bits: 1406	V_set_dac: 1.717 V	V_set_pot: 1.717 V	ADC_A0_raw: 9208	V_adc_a0: 1.727 V	ADC_A1_raw: 9150	V_adc_a1: 1.716 V
Position: 35	DAC_Bits: 1447	V_set_dac: 1.767 V	V_set_pot: 1.768 V	ADC_A0_raw: 9476	V_adc_a0: 1.777 V	ADC_A1_raw: 9418	V_adc_a1: 1.766 V
Position: 36	DAC_Bits: 1489	V_set_dac: 1.818 V	V_set_pot: 1.818 V	ADC_A0_raw: 9752	V_adc_a0: 1.829 V	ADC_A1_raw: 9694	V_adc_a1: 1.818 V
Position: 37	DAC_Bits: 1530	V_set_dac: 1.868 V	V_set_pot: 1.869 V	ADC_A0_raw: 10024	V_adc_a0: 1.880 V	ADC_A1_raw: 9965	V_adc_a1: 1.868 V
Position: 38	DAC_Bits: 1571	V_set_dac: 1.918 V	V_set_pot: 1.919 V	ADC_A0_raw: 10288	V_adc_a0: 1.929 V	ADC_A1_raw: 10229	V_adc_a1: 1.918 V
Position: 39	DAC_Bits: 1613	V_set_dac: 1.969 V	V_set_pot: 1.970 V	ADC_A0_raw: 10561	V_adc_a0: 1.980 V	ADC_A1_raw: 10499	V_adc_a1: 1.969 V
Position: 40	DAC_Bits: 1654	V_set_dac: 2.020 V	V_set_pot: 2.020 V	ADC_A0_raw: 10828	V_adc_a0: 2.030 V	ADC_A1_raw: 10759	V_adc_a1: 2.017 V
Position: 41	DAC_Bits: 1695	V_set_dac: 2.070 V	V_set_pot: 2.071 V	ADC_A0_raw: 11101	V_adc_a0: 2.081 V	ADC_A1_raw: 11026	V_adc_a1: 2.067 V
Position: 42	DAC_Bits: 1737	V_set_dac: 2.121 V	V_set_pot: 2.121 V	ADC_A0_raw: 11369	V_adc_a0: 2.132 V	ADC_A1_raw: 11299	V_adc_a1: 2.119 V
Position: 43	DAC_Bits: 1778	V_set_dac: 2.171 V	V_set_pot: 2.172 V	ADC_A0_raw: 11639	V_adc_a0: 2.182 V	ADC_A1_raw: 11563	V_adc_a1: 2.168 V
Position: 44	DAC_Bits: 1820	V_set_dac: 2.222 V	V_set_pot: 2.222 V	ADC_A0_raw: 11908	V_adc_a0: 2.233 V	ADC_A1_raw: 11839	V_adc_a1: 2.220 V
Position: 45	DAC_Bits: 1861	V_set_dac: 2.272 V	V_set_pot: 2.273 V	ADC_A0_raw: 12181	V_adc_a0: 2.284 V	ADC_A1_raw: 12107	V_adc_a1: 2.270 V
Position: 46	DAC_Bits: 1902	V_set_dac: 2.322 V	V_set_pot: 2.323 V	ADC_A0_raw: 12448	V_adc_a0: 2.334 V	ADC_A1_raw: 12374	V_adc_a1: 2.320 V
Position: 47	DAC_Bits: 1944	V_set_dac: 2.374 V	V_set_pot: 2.374 V	ADC_A0_raw: 12724	V_adc_a0: 2.386 V	ADC_A1_raw: 12647	V_adc_a1: 2.371 V
Position: 48	DAC_Bits: 1985	V_set_dac: 2.424 V	V_set_pot: 2.424 V	ADC_A0_raw: 12988	V_adc_a0: 2.435 V	ADC_A1_raw: 12909	V_adc_a1: 2.420 V
Position: 49	DAC_Bits: 2026	V_set_dac: 2.474 V	V_set_pot: 2.475 V	ADC_A0_raw: 13263	V_adc_a0: 2.487 V	ADC_A1_raw: 13186	V_adc_a1: 2.472 V
Position: 50	DAC_Bits: 2068	V_set_dac: 2.525 V	V_set_pot: 2.525 V	ADC_A0_raw: 13531	V_adc_a0: 2.537 V	ADC_A1_raw: 13465	V_adc_a1: 2.525 V
Position: 51	DAC_Bits: 2109	V_set_dac: 2.575 V	V_set_pot: 2.576 V	ADC_A0_raw: 13804	V_adc_a0: 2.588 V	ADC_A1_raw: 13733	V_adc_a1: 2.575 V
Position: 52	DAC_Bits: 2150	V_set_dac: 2.625 V	V_set_pot: 2.626 V	ADC_A0_raw: 14080	V_adc_a0: 2.640 V	ADC_A1_raw: 14005	V_adc_a1: 2.626 V
Position: 53	DAC_Bits: 2192	V_set_dac: 2.676 V	V_set_pot: 2.677 V	ADC_A0_raw: 14351	V_adc_a0: 2.691 V	ADC_A1_raw: 14279	V_adc_a1: 2.677 V
Position: 54	DAC_Bits: 2233	V_set_dac: 2.726 V	V_set_pot: 2.727 V	ADC_A0_raw: 14630	V_adc_a0: 2.743 V	ADC_A1_raw: 14545	V_adc_a1: 2.727 V
Position: 55	DAC_Bits: 2275	V_set_dac: 2.778 V	V_set_pot: 2.778 V	ADC_A0_raw: 14899	V_adc_a0: 2.794 V	ADC_A1_raw: 14820	V_adc_a1: 2.779 V
Position: 56	DAC_Bits: 2316	V_set_dac: 2.828 V	V_set_pot: 2.828 V	ADC_A0_raw: 15168	V_adc_a0: 2.844 V	ADC_A1_raw: 15091	V_adc_a1: 2.830 V
Position: 57	DAC_Bits: 2357	V_set_dac: 2.878 V	V_set_pot: 2.879 V	ADC_A0_raw: 15437	V_adc_a0: 2.894 V	ADC_A1_raw: 15357	V_adc_a1: 2.879 V
Position: 58	DAC_Bits: 2399	V_set_dac: 2.929 V	V_set_pot: 2.929 V	ADC_A0_raw: 15717	V_adc_a0: 2.947 V	ADC_A1_raw: 15630	V_adc_a1: 2.931 V
Position: 59	DAC_Bits: 2440	V_set_dac: 2.979 V	V_set_pot: 2.980 V	ADC_A0_raw: 15985	V_adc_a0: 2.997 V	ADC_A1_raw: 15901	V_adc_a1: 2.981 V
Position: 60	DAC_Bits: 2481	V_set_dac: 3.029 V	V_set_pot: 3.030 V	ADC_A0_raw: 16256	V_adc_a0: 3.048 V	ADC_A1_raw: 16171	V_adc_a1: 3.032 V
Position: 61	DAC_Bits: 2523	V_set_dac: 3.081 V	V_set_pot: 3.081 V	ADC_A0_raw: 16525	V_adc_a0: 3.098 V	ADC_A1_raw: 16452	V_adc_a1: 3.085 V
Position: 62	DAC_Bits: 2564	V_set_dac: 3.131 V	V_set_pot: 3.131 V	ADC_A0_raw: 16797	V_adc_a0: 3.149 V	ADC_A1_raw: 16728	V_adc_a1: 3.137 V
Position: 63	DAC_Bits: 2605	V_set_dac: 3.181 V	V_set_pot: 3.182 V	ADC_A0_raw: 17073	V_adc_a0: 3.201 V	ADC_A1_raw: 16996	V_adc_a1: 3.187 V
Position: 64	DAC_Bits: 2647	V_set_dac: 3.232 V	V_set_pot: 3.232 V	ADC_A0_raw: 17339	V_adc_a0: 3.251 V	ADC_A1_raw: 17271	V_adc_a1: 3.238 V
Position: 65	DAC_Bits: 2688	V_set_dac: 3.282 V	V_set_pot: 3.283 V	ADC_A0_raw: 17615	V_adc_a0: 3.303 V	ADC_A1_raw: 17541	V_adc_a1: 3.289 V
Position: 66	DAC_Bits: 2730	V_set_dac: 3.333 V	V_set_pot: 3.333 V	ADC_A0_raw: 17883	V_adc_a0: 3.353 V	ADC_A1_raw: 17816	V_adc_a1: 3.341 V
Position: 67	DAC_Bits: 2771	V_set_dac: 3.383 V	V_set_pot: 3.384 V	ADC_A0_raw: 18154	V_adc_a0: 3.404 V	ADC_A1_raw: 18085	V_adc_a1: 3.391 V
Position: 68	DAC_Bits: 2812	V_set_dac: 3.433 V	V_set_pot: 3.434 V	ADC_A0_raw: 18432	V_adc_a0: 3.456 V	ADC_A1_raw: 18354	V_adc_a1: 3.441 V
Position: 69	DAC_Bits: 2854	V_set_dac: 3.485 V	V_set_pot: 3.485 V	ADC_A0_raw: 18706	V_adc_a0: 3.507 V	ADC_A1_raw: 18624	V_adc_a1: 3.492 V
Position: 70	DAC_Bits: 2895	V_set_dac: 3.535 V	V_set_pot: 3.535 V	ADC_A0_raw: 18970	V_adc_a0: 3.557 V	ADC_A1_raw: 18889	V_adc_a1: 3.542 V
Position: 71	DAC_Bits: 2936	V_set_dac: 3.585 V	V_set_pot: 3.586 V	ADC_A0_raw: 19241	V_adc_a0: 3.608 V	ADC_A1_raw: 19154	V_adc_a1: 3.591 V
Position: 72	DAC_Bits: 2978	V_set_dac: 3.636 V	V_set_pot: 3.636 V	ADC_A0_raw: 19509	V_adc_a0: 3.658 V	ADC_A1_raw: 19425	V_adc_a1: 3.642 V
Position: 73	DAC_Bits: 3019	V_set_dac: 3.686 V	V_set_pot: 3.687 V	ADC_A0_raw: 19764	V_adc_a0: 3.706 V	ADC_A1_raw: 19689	V_adc_a1: 3.692 V
Position: 74	DAC_Bits: 3060	V_set_dac: 3.736 V	V_set_pot: 3.737 V	ADC_A0_raw: 19972	V_adc_a0: 3.745 V	ADC_A1_raw: 19933	V_adc_a1: 3.737 V
Position: 75	DAC_Bits: 3102	V_set_dac: 3.788 V	V_set_pot: 3.788 V	ADC_A0_raw: 20113	V_adc_a0: 3.771 V	ADC_A1_raw: 20121	V_adc_a1: 3.773 V
Position: 76	DAC_Bits: 3143	V_set_dac: 3.838 V	V_set_pot: 3.838 V	ADC_A0_raw: 20192	V_adc_a0: 3.786 V	ADC_A1_raw: 20221	V_adc_a1: 3.791 V
Position: 77	DAC_Bits: 3185	V_set_dac: 3.889 V	V_set_pot: 3.889 V	ADC_A0_raw: 20230	V_adc_a0: 3.793 V	ADC_A1_raw: 20270	V_adc_a1: 3.801 V
Position: 78	DAC_Bits: 3226	V_set_dac: 3.939 V	V_set_pot: 3.939 V	ADC_A0_raw: 20250	V_adc_a0: 3.797 V	ADC_A1_raw: 20250	V_adc_a1: 3.797 V
Position: 79	DAC_Bits: 3267	V_set_dac: 3.989 V	V_set_pot: 3.990 V	ADC_A0_raw: 20230	V_adc_a0: 3.793 V	ADC_A1_raw: 20230	V_adc_a1: 3.793 V
Position: 80	DAC_Bits: 3309	V_set_dac: 4.040 V	V_set_pot: 4.040 V	ADC_A0_raw: 20210	V_adc_a0: 3.789 V	ADC_A1_raw: 20149	V_adc_a1: 3.778 V
Position: 81	DAC_Bits: 3350	V_set_dac: 4.090 V	V_set_pot: 4.091 V	ADC_A0_raw: 20169	V_adc_a0: 3.782 V	ADC_A1_raw: 20108	V_adc_a1: 3.770 V
Position: 82	DAC_Bits: 3391	V_set_dac: 4.140 V	V_set_pot: 4.141 V	ADC_A0_raw: 20149	V_adc_a0: 3.778 V	ADC_A1_raw: 20027	V_adc_a1: 3.755 V
Position: 83	DAC_Bits: 3433	V_set_dac: 4.192 V	V_set_pot: 4.192 V	ADC_A0_raw: 20149	V_adc_a0: 3.778 V	ADC_A1_raw: 19967	V_adc_a1: 3.744 V
Position: 84	DAC_Bits: 3474	V_set_dac: 4.242 V	V_set_pot: 4.242 V	ADC_A0_raw: 20149	V_adc_a0: 3.778 V	ADC_A1_raw: 19967	V_adc_a1: 3.744 V
Position: 85	DAC_Bits: 3515	V_set_dac: 4.292 V	V_set_pot: 4.293 V	ADC_A0_raw: 20129	V_adc_a0: 3.774 V	ADC_A1_raw: 19946	V_adc_a1: 3.740 V
Position: 86	DAC_Bits: 3557	V_set_dac: 4.343 V	V_set_pot: 4.343 V	ADC_A0_raw: 20108	V_adc_a0: 3.770 V	ADC_A1_raw: 19946	V_adc_a1: 3.740 V
Position: 87	DAC_Bits: 3598	V_set_dac: 4.393 V	V_set_pot: 4.394 V	ADC_A0_raw: 20088	V_adc_a0: 3.766 V	ADC_A1_raw: 19926	V_adc_a1: 3.736 V
Position: 88	DAC_Bits: 3640	V_set_dac: 4.444 V	V_set_pot: 4.444 V	ADC_A0_raw: 20088	V_adc_a0: 3.766 V	ADC_A1_raw: 19926	V_adc_a1: 3.736 V
Position: 89	DAC_Bits: 3681	V_set_dac: 4.495 V	V_set_pot: 4.495 V	ADC_A0_raw: 20088	V_adc_a0: 3.766 V	ADC_A1_raw: 19906	V_adc_a1: 3.732 V
Position: 90	DAC_Bits: 3722	V_set_dac: 4.545 V	V_set_pot: 4.545 V	ADC_A0_raw: 20088	V_adc_a0: 3.766 V	ADC_A1_raw: 19906	V_adc_a1: 3.732 V
Position: 91	DAC_Bits: 3764	V_set_dac: 4.596 V	V_set_pot: 4.596 V	ADC_A0_raw: 20048	V_adc_a0: 3.759 V	ADC_A1_raw: 19886	V_adc_a1: 3.729 V
Position: 92	DAC_Bits: 3805	V_set_dac: 4.646 V	V_set_pot: 4.646 V	ADC_A0_raw: 20007	V_adc_a0: 3.751 V	ADC_A1_raw: 19865	V_adc_a1: 3.725 V
Position: 93	DAC_Bits: 3846	V_set_dac: 4.696 V	V_set_pot: 4.697 V	ADC_A0_raw: 19987	V_adc_a0: 3.748 V	ADC_A1_raw: 19865	V_adc_a1: 3.725 V
Position: 94	DAC_Bits: 3888	V_set_dac: 4.747 V	V_set_pot: 4.747 V	ADC_A0_raw: 19967	V_adc_a0: 3.744 V	ADC_A1_raw: 19865	V_adc_a1: 3.725 V
Position: 95	DAC_Bits: 3929	V_set_dac: 4.797 V	V_set_pot: 4.798 V	ADC_A0_raw: 19946	V_adc_a0: 3.740 V	ADC_A1_raw: 19845	V_adc_a1: 3.721 V
Position: 96	DAC_Bits: 3970	V_set_dac: 4.847 V	V_set_pot: 4.848 V	ADC_A0_raw: 19926	V_adc_a0: 3.736 V	ADC_A1_raw: 19825	V_adc_a1: 3.717 V
Position: 97	DAC_Bits: 4012	V_set_dac: 4.899 V	V_set_pot: 4.899 V	ADC_A0_raw: 19886	V_adc_a0: 3.729 V	ADC_A1_raw: 19825	V_adc_a1: 3.717 V
Position: 98	DAC_Bits: 4053	V_set_dac: 4.949 V	V_set_pot: 4.949 V	ADC_A0_raw: 19805	V_adc_a0: 3.713 V	ADC_A1_raw: 19764	V_adc_a1: 3.706 V
Position: 99	DAC_Bits: 4095	V_set_dac: 5.000 V	V_set_pot: 5.000 V	ADC_A0_raw: 19541	V_adc_a0: 3.664 V	ADC_A1_raw: 19724	V_adc_a1: 3.698 V
Position: 99	DAC_Bits: 4095	V_set_dac: 5.000 V	V_set_pot: 5.000 V	ADC_A0_raw: 19602	V_adc_a0: 3.675 V	ADC_A1_raw: 19703	V_adc_a1: 3.694 V
Position: 98	DAC_Bits: 4053	V_set_dac: 4.949 V	V_set_pot: 4.949 V	ADC_A0_raw: 19805	V_adc_a0: 3.713 V	ADC_A1_raw: 19784	V_adc_a1: 3.710 V
Position: 97	DAC_Bits: 4012	V_set_dac: 4.899 V	V_set_pot: 4.899 V	ADC_A0_raw: 19865	V_adc_a0: 3.725 V	ADC_A1_raw: 19784	V_adc_a1: 3.710 V
Position: 96	DAC_Bits: 3970	V_set_dac: 4.847 V	V_set_pot: 4.848 V	ADC_A0_raw: 19906	V_adc_a0: 3.732 V	ADC_A1_raw: 19825	V_adc_a1: 3.717 V
Position: 95	DAC_Bits: 3929	V_set_dac: 4.797 V	V_set_pot: 4.798 V	ADC_A0_raw: 19926	V_adc_a0: 3.736 V	ADC_A1_raw: 19845	V_adc_a1: 3.721 V
Position: 94	DAC_Bits: 3888	V_set_dac: 4.747 V	V_set_pot: 4.747 V	ADC_A0_raw: 19967	V_adc_a0: 3.744 V	ADC_A1_raw: 19845	V_adc_a1: 3.721 V
Position: 93	DAC_Bits: 3846	V_set_dac: 4.696 V	V_set_pot: 4.697 V	ADC_A0_raw: 19987	V_adc_a0: 3.748 V	ADC_A1_raw: 19845	V_adc_a1: 3.721 V
Position: 92	DAC_Bits: 3805	V_set_dac: 4.646 V	V_set_pot: 4.646 V	ADC_A0_raw: 20027	V_adc_a0: 3.755 V	ADC_A1_raw: 19865	V_adc_a1: 3.725 V
Position: 91	DAC_Bits: 3764	V_set_dac: 4.596 V	V_set_pot: 4.596 V	ADC_A0_raw: 20048	V_adc_a0: 3.759 V	ADC_A1_raw: 19886	V_adc_a1: 3.729 V
Position: 90	DAC_Bits: 3722	V_set_dac: 4.545 V	V_set_pot: 4.545 V	ADC_A0_raw: 20088	V_adc_a0: 3.766 V	ADC_A1_raw: 19886	V_adc_a1: 3.729 V
Position: 89	DAC_Bits: 3681	V_set_dac: 4.495 V	V_set_pot: 4.495 V	ADC_A0_raw: 20088	V_adc_a0: 3.766 V	ADC_A1_raw: 19906	V_adc_a1: 3.732 V
Position: 88	DAC_Bits: 3640	V_set_dac: 4.444 V	V_set_pot: 4.444 V	ADC_A0_raw: 20088	V_adc_a0: 3.766 V	ADC_A1_raw: 19906	V_adc_a1: 3.732 V
Position: 87	DAC_Bits: 3598	V_set_dac: 4.393 V	V_set_pot: 4.394 V	ADC_A0_raw: 20068	V_adc_a0: 3.763 V	ADC_A1_raw: 19926	V_adc_a1: 3.736 V
Position: 86	DAC_Bits: 3557	V_set_dac: 4.343 V	V_set_pot: 4.343 V	ADC_A0_raw: 20068	V_adc_a0: 3.763 V	ADC_A1_raw: 19926	V_adc_a1: 3.736 V
Position: 85	DAC_Bits: 3515	V_set_dac: 4.292 V	V_set_pot: 4.293 V	ADC_A0_raw: 20088	V_adc_a0: 3.766 V	ADC_A1_raw: 19946	V_adc_a1: 3.740 V
Position: 84	DAC_Bits: 3474	V_set_dac: 4.242 V	V_set_pot: 4.242 V	ADC_A0_raw: 20108	V_adc_a0: 3.770 V	ADC_A1_raw: 19946	V_adc_a1: 3.740 V
Position: 83	DAC_Bits: 3433	V_set_dac: 4.192 V	V_set_pot: 4.192 V	ADC_A0_raw: 20129	V_adc_a0: 3.774 V	ADC_A1_raw: 19967	V_adc_a1: 3.744 V
Position: 82	DAC_Bits: 3391	V_set_dac: 4.140 V	V_set_pot: 4.141 V	ADC_A0_raw: 20129	V_adc_a0: 3.774 V	ADC_A1_raw: 19987	V_adc_a1: 3.748 V
Position: 81	DAC_Bits: 3350	V_set_dac: 4.090 V	V_set_pot: 4.091 V	ADC_A0_raw: 20129	V_adc_a0: 3.774 V	ADC_A1_raw: 20088	V_adc_a1: 3.766 V
Position: 80	DAC_Bits: 3309	V_set_dac: 4.040 V	V_set_pot: 4.040 V	ADC_A0_raw: 20189	V_adc_a0: 3.785 V	ADC_A1_raw: 20129	V_adc_a1: 3.774 V
Position: 79	DAC_Bits: 3267	V_set_dac: 3.989 V	V_set_pot: 3.990 V	ADC_A0_raw: 20210	V_adc_a0: 3.789 V	ADC_A1_raw: 20189	V_adc_a1: 3.785 V
Position: 78	DAC_Bits: 3226	V_set_dac: 3.939 V	V_set_pot: 3.939 V	ADC_A0_raw: 20210	V_adc_a0: 3.789 V	ADC_A1_raw: 20230	V_adc_a1: 3.793 V
Position: 77	DAC_Bits: 3185	V_set_dac: 3.889 V	V_set_pot: 3.889 V	ADC_A0_raw: 20189	V_adc_a0: 3.785 V	ADC_A1_raw: 20230	V_adc_a1: 3.793 V
Position: 76	DAC_Bits: 3143	V_set_dac: 3.838 V	V_set_pot: 3.838 V	ADC_A0_raw: 20172	V_adc_a0: 3.782 V	ADC_A1_raw: 20208	V_adc_a1: 3.789 V
Position: 75	DAC_Bits: 3102	V_set_dac: 3.788 V	V_set_pot: 3.788 V	ADC_A0_raw: 20097	V_adc_a0: 3.768 V	ADC_A1_raw: 20112	V_adc_a1: 3.771 V
Position: 74	DAC_Bits: 3060	V_set_dac: 3.736 V	V_set_pot: 3.737 V	ADC_A0_raw: 19968	V_adc_a0: 3.744 V	ADC_A1_raw: 19931	V_adc_a1: 3.737 V
Position: 73	DAC_Bits: 3019	V_set_dac: 3.686 V	V_set_pot: 3.687 V	ADC_A0_raw: 19763	V_adc_a0: 3.706 V	ADC_A1_raw: 19690	V_adc_a1: 3.692 V
Position: 72	DAC_Bits: 2978	V_set_dac: 3.636 V	V_set_pot: 3.636 V	ADC_A0_raw: 19511	V_adc_a0: 3.658 V	ADC_A1_raw: 19429	V_adc_a1: 3.643 V
Position: 71	DAC_Bits: 2936	V_set_dac: 3.585 V	V_set_pot: 3.586 V	ADC_A0_raw: 19242	V_adc_a0: 3.608 V	ADC_A1_raw: 19155	V_adc_a1: 3.592 V
Position: 70	DAC_Bits: 2895	V_set_dac: 3.535 V	V_set_pot: 3.535 V	ADC_A0_raw: 18968	V_adc_a0: 3.556 V	ADC_A1_raw: 18888	V_adc_a1: 3.542 V
Position: 69	DAC_Bits: 2854	V_set_dac: 3.485 V	V_set_pot: 3.485 V	ADC_A0_raw: 18702	V_adc_a0: 3.507 V	ADC_A1_raw: 18626	V_adc_a1: 3.492 V
Position: 68	DAC_Bits: 2812	V_set_dac: 3.433 V	V_set_pot: 3.434 V	ADC_A0_raw: 18427	V_adc_a0: 3.455 V	ADC_A1_raw: 18354	V_adc_a1: 3.441 V
Position: 67	DAC_Bits: 2771	V_set_dac: 3.383 V	V_set_pot: 3.384 V	ADC_A0_raw: 18160	V_adc_a0: 3.405 V	ADC_A1_raw: 18086	V_adc_a1: 3.391 V
Position: 66	DAC_Bits: 2730	V_set_dac: 3.333 V	V_set_pot: 3.333 V	ADC_A0_raw: 17889	V_adc_a0: 3.354 V	ADC_A1_raw: 17816	V_adc_a1: 3.341 V
Position: 65	DAC_Bits: 2688	V_set_dac: 3.282 V	V_set_pot: 3.283 V	ADC_A0_raw: 17614	V_adc_a0: 3.303 V	ADC_A1_raw: 17539	V_adc_a1: 3.289 V
Position: 64	DAC_Bits: 2647	V_set_dac: 3.232 V	V_set_pot: 3.232 V	ADC_A0_raw: 17342	V_adc_a0: 3.252 V	ADC_A1_raw: 17272	V_adc_a1: 3.239 V
Position: 63	DAC_Bits: 2605	V_set_dac: 3.181 V	V_set_pot: 3.182 V	ADC_A0_raw: 17066	V_adc_a0: 3.200 V	ADC_A1_raw: 16997	V_adc_a1: 3.187 V
Position: 62	DAC_Bits: 2564	V_set_dac: 3.131 V	V_set_pot: 3.131 V	ADC_A0_raw: 16797	V_adc_a0: 3.149 V	ADC_A1_raw: 16729	V_adc_a1: 3.137 V
Position: 61	DAC_Bits: 2523	V_set_dac: 3.081 V	V_set_pot: 3.081 V	ADC_A0_raw: 16526	V_adc_a0: 3.099 V	ADC_A1_raw: 16453	V_adc_a1: 3.085 V
Position: 60	DAC_Bits: 2481	V_set_dac: 3.029 V	V_set_pot: 3.030 V	ADC_A0_raw: 16257	V_adc_a0: 3.048 V	ADC_A1_raw: 16170	V_adc_a1: 3.032 V
Position: 59	DAC_Bits: 2440	V_set_dac: 2.979 V	V_set_pot: 2.980 V	ADC_A0_raw: 15988	V_adc_a0: 2.998 V	ADC_A1_raw: 15900	V_adc_a1: 2.981 V
Position: 58	DAC_Bits: 2399	V_set_dac: 2.929 V	V_set_pot: 2.929 V	ADC_A0_raw: 15711	V_adc_a0: 2.946 V	ADC_A1_raw: 15631	V_adc_a1: 2.931 V
Position: 57	DAC_Bits: 2357	V_set_dac: 2.878 V	V_set_pot: 2.879 V	ADC_A0_raw: 15443	V_adc_a0: 2.896 V	ADC_A1_raw: 15357	V_adc_a1: 2.879 V
Position: 56	DAC_Bits: 2316	V_set_dac: 2.828 V	V_set_pot: 2.828 V	ADC_A0_raw: 15163	V_adc_a0: 2.843 V	ADC_A1_raw: 15089	V_adc_a1: 2.829 V
Position: 55	DAC_Bits: 2275	V_set_dac: 2.778 V	V_set_pot: 2.778 V	ADC_A0_raw: 14898	V_adc_a0: 2.793 V	ADC_A1_raw: 14819	V_adc_a1: 2.779 V
Position: 54	DAC_Bits: 2233	V_set_dac: 2.726 V	V_set_pot: 2.727 V	ADC_A0_raw: 14627	V_adc_a0: 2.743 V	ADC_A1_raw: 14545	V_adc_a1: 2.727 V
Position: 53	DAC_Bits: 2192	V_set_dac: 2.676 V	V_set_pot: 2.677 V	ADC_A0_raw: 14354	V_adc_a0: 2.691 V	ADC_A1_raw: 14281	V_adc_a1: 2.678 V
Position: 52	DAC_Bits: 2150	V_set_dac: 2.625 V	V_set_pot: 2.626 V	ADC_A0_raw: 14082	V_adc_a0: 2.640 V	ADC_A1_raw: 14006	V_adc_a1: 2.626 V
Position: 51	DAC_Bits: 2109	V_set_dac: 2.575 V	V_set_pot: 2.576 V	ADC_A0_raw: 13805	V_adc_a0: 2.588 V	ADC_A1_raw: 13733	V_adc_a1: 2.575 V
Position: 50	DAC_Bits: 2068	V_set_dac: 2.525 V	V_set_pot: 2.525 V	ADC_A0_raw: 13539	V_adc_a0: 2.539 V	ADC_A1_raw: 13465	V_adc_a1: 2.525 V
Position: 49	DAC_Bits: 2026	V_set_dac: 2.474 V	V_set_pot: 2.475 V	ADC_A0_raw: 13263	V_adc_a0: 2.487 V	ADC_A1_raw: 13184	V_adc_a1: 2.472 V
Position: 48	DAC_Bits: 1985	V_set_dac: 2.424 V	V_set_pot: 2.424 V	ADC_A0_raw: 12996	V_adc_a0: 2.437 V	ADC_A1_raw: 12910	V_adc_a1: 2.421 V
Position: 47	DAC_Bits: 1944	V_set_dac: 2.374 V	V_set_pot: 2.374 V	ADC_A0_raw: 12720	V_adc_a0: 2.385 V	ADC_A1_raw: 12646	V_adc_a1: 2.371 V
Position: 46	DAC_Bits: 1902	V_set_dac: 2.322 V	V_set_pot: 2.323 V	ADC_A0_raw: 12450	V_adc_a0: 2.334 V	ADC_A1_raw: 12374	V_adc_a1: 2.320 V
Position: 45	DAC_Bits: 1861	V_set_dac: 2.272 V	V_set_pot: 2.273 V	ADC_A0_raw: 12186	V_adc_a0: 2.285 V	ADC_A1_raw: 12108	V_adc_a1: 2.270 V
Position: 44	DAC_Bits: 1820	V_set_dac: 2.222 V	V_set_pot: 2.222 V	ADC_A0_raw: 11908	V_adc_a0: 2.233 V	ADC_A1_raw: 11839	V_adc_a1: 2.220 V
Position: 43	DAC_Bits: 1778	V_set_dac: 2.171 V	V_set_pot: 2.172 V	ADC_A0_raw: 11641	V_adc_a0: 2.183 V	ADC_A1_raw: 11564	V_adc_a1: 2.168 V
Position: 42	DAC_Bits: 1737	V_set_dac: 2.121 V	V_set_pot: 2.121 V	ADC_A0_raw: 11365	V_adc_a0: 2.131 V	ADC_A1_raw: 11301	V_adc_a1: 2.119 V
Position: 41	DAC_Bits: 1695	V_set_dac: 2.070 V	V_set_pot: 2.071 V	ADC_A0_raw: 11095	V_adc_a0: 2.080 V	ADC_A1_raw: 11026	V_adc_a1: 2.067 V
Position: 40	DAC_Bits: 1654	V_set_dac: 2.020 V	V_set_pot: 2.020 V	ADC_A0_raw: 10830	V_adc_a0: 2.031 V	ADC_A1_raw: 10759	V_adc_a1: 2.017 V
Position: 39	DAC_Bits: 1613	V_set_dac: 1.969 V	V_set_pot: 1.970 V	ADC_A0_raw: 10558	V_adc_a0: 1.980 V	ADC_A1_raw: 10497	V_adc_a1: 1.968 V
Position: 38	DAC_Bits: 1571	V_set_dac: 1.918 V	V_set_pot: 1.919 V	ADC_A0_raw: 10283	V_adc_a0: 1.928 V	ADC_A1_raw: 10228	V_adc_a1: 1.918 V
Position: 37	DAC_Bits: 1530	V_set_dac: 1.868 V	V_set_pot: 1.869 V	ADC_A0_raw: 10021	V_adc_a0: 1.879 V	ADC_A1_raw: 9964	V_adc_a1: 1.868 V
Position: 36	DAC_Bits: 1489	V_set_dac: 1.818 V	V_set_pot: 1.818 V	ADC_A0_raw: 9749	V_adc_a0: 1.828 V	ADC_A1_raw: 9692	V_adc_a1: 1.817 V
Position: 35	DAC_Bits: 1447	V_set_dac: 1.767 V	V_set_pot: 1.768 V	ADC_A0_raw: 9479	V_adc_a0: 1.777 V	ADC_A1_raw: 9417	V_adc_a1: 1.766 V
Position: 34	DAC_Bits: 1406	V_set_dac: 1.717 V	V_set_pot: 1.717 V	ADC_A0_raw: 9202	V_adc_a0: 1.725 V	ADC_A1_raw: 9149	V_adc_a1: 1.715 V
Position: 33	DAC_Bits: 1365	V_set_dac: 1.667 V	V_set_pot: 1.667 V	ADC_A0_raw: 8933	V_adc_a0: 1.675 V	ADC_A1_raw: 8880	V_adc_a1: 1.665 V
Position: 32	DAC_Bits: 1323	V_set_dac: 1.615 V	V_set_pot: 1.616 V	ADC_A0_raw: 8659	V_adc_a0: 1.624 V	ADC_A1_raw: 8607	V_adc_a1: 1.614 V
Position: 31	DAC_Bits: 1282	V_set_dac: 1.565 V	V_set_pot: 1.566 V	ADC_A0_raw: 8390	V_adc_a0: 1.573 V	ADC_A1_raw: 8341	V_adc_a1: 1.564 V
Position: 30	DAC_Bits: 1240	V_set_dac: 1.514 V	V_set_pot: 1.515 V	ADC_A0_raw: 8121	V_adc_a0: 1.523 V	ADC_A1_raw: 8071	V_adc_a1: 1.513 V
Position: 29	DAC_Bits: 1199	V_set_dac: 1.464 V	V_set_pot: 1.465 V	ADC_A0_raw: 7846	V_adc_a0: 1.471 V	ADC_A1_raw: 7807	V_adc_a1: 1.464 V
Position: 28	DAC_Bits: 1158	V_set_dac: 1.414 V	V_set_pot: 1.414 V	ADC_A0_raw: 7579	V_adc_a0: 1.421 V	ADC_A1_raw: 7541	V_adc_a1: 1.414 V
Position: 27	DAC_Bits: 1116	V_set_dac: 1.363 V	V_set_pot: 1.364 V	ADC_A0_raw: 7307	V_adc_a0: 1.370 V	ADC_A1_raw: 7268	V_adc_a1: 1.363 V
Position: 26	DAC_Bits: 1075	V_set_dac: 1.313 V	V_set_pot: 1.313 V	ADC_A0_raw: 7032	V_adc_a0: 1.319 V	ADC_A1_raw: 7000	V_adc_a1: 1.312 V
Position: 25	DAC_Bits: 1034	V_set_dac: 1.263 V	V_set_pot: 1.263 V	ADC_A0_raw: 6767	V_adc_a0: 1.269 V	ADC_A1_raw: 6732	V_adc_a1: 1.262 V
Position: 24	DAC_Bits: 992	V_set_dac: 1.211 V	V_set_pot: 1.212 V	ADC_A0_raw: 6501	V_adc_a0: 1.219 V	ADC_A1_raw: 6450	V_adc_a1: 1.209 V
Position: 23	DAC_Bits: 951	V_set_dac: 1.161 V	V_set_pot: 1.162 V	ADC_A0_raw: 6228	V_adc_a0: 1.168 V	ADC_A1_raw: 6176	V_adc_a1: 1.158 V
Position: 22	DAC_Bits: 910	V_set_dac: 1.111 V	V_set_pot: 1.111 V	ADC_A0_raw: 5952	V_adc_a0: 1.116 V	ADC_A1_raw: 5913	V_adc_a1: 1.109 V
Position: 21	DAC_Bits: 868	V_set_dac: 1.060 V	V_set_pot: 1.061 V	ADC_A0_raw: 5692	V_adc_a0: 1.067 V	ADC_A1_raw: 5638	V_adc_a1: 1.057 V
Position: 20	DAC_Bits: 827	V_set_dac: 1.010 V	V_set_pot: 1.010 V	ADC_A0_raw: 5415	V_adc_a0: 1.015 V	ADC_A1_raw: 5369	V_adc_a1: 1.007 V
Position: 19	DAC_Bits: 785	V_set_dac: 0.958 V	V_set_pot: 0.960 V	ADC_A0_raw: 5141	V_adc_a0: 0.964 V	ADC_A1_raw: 5095	V_adc_a1: 0.955 V
Position: 18	DAC_Bits: 744	V_set_dac: 0.908 V	V_set_pot: 0.909 V	ADC_A0_raw: 4871	V_adc_a0: 0.913 V	ADC_A1_raw: 4830	V_adc_a1: 0.906 V
Position: 17	DAC_Bits: 703	V_set_dac: 0.858 V	V_set_pot: 0.859 V	ADC_A0_raw: 4599	V_adc_a0: 0.862 V	ADC_A1_raw: 4564	V_adc_a1: 0.856 V
Position: 16	DAC_Bits: 661	V_set_dac: 0.807 V	V_set_pot: 0.808 V	ADC_A0_raw: 4329	V_adc_a0: 0.812 V	ADC_A1_raw: 4293	V_adc_a1: 0.805 V
Position: 15	DAC_Bits: 620	V_set_dac: 0.757 V	V_set_pot: 0.758 V	ADC_A0_raw: 4057	V_adc_a0: 0.761 V	ADC_A1_raw: 4029	V_adc_a1: 0.755 V
Position: 14	DAC_Bits: 579	V_set_dac: 0.707 V	V_set_pot: 0.707 V	ADC_A0_raw: 3783	V_adc_a0: 0.709 V	ADC_A1_raw: 3763	V_adc_a1: 0.706 V
Position: 13	DAC_Bits: 537	V_set_dac: 0.656 V	V_set_pot: 0.657 V	ADC_A0_raw: 3514	V_adc_a0: 0.659 V	ADC_A1_raw: 3491	V_adc_a1: 0.655 V
Position: 12	DAC_Bits: 496	V_set_dac: 0.606 V	V_set_pot: 0.606 V	ADC_A0_raw: 3247	V_adc_a0: 0.609 V	ADC_A1_raw: 3222	V_adc_a1: 0.604 V
Position: 11	DAC_Bits: 455	V_set_dac: 0.556 V	V_set_pot: 0.556 V	ADC_A0_raw: 2975	V_adc_a0: 0.558 V	ADC_A1_raw: 2948	V_adc_a1: 0.553 V
Position: 10	DAC_Bits: 413	V_set_dac: 0.504 V	V_set_pot: 0.505 V	ADC_A0_raw: 2704	V_adc_a0: 0.507 V	ADC_A1_raw: 2677	V_adc_a1: 0.502 V
Position: 9	DAC_Bits: 372	V_set_dac: 0.454 V	V_set_pot: 0.455 V	ADC_A0_raw: 2434	V_adc_a0: 0.456 V	ADC_A1_raw: 2413	V_adc_a1: 0.452 V
Position: 8	DAC_Bits: 330	V_set_dac: 0.403 V	V_set_pot: 0.404 V	ADC_A0_raw: 2162	V_adc_a0: 0.405 V	ADC_A1_raw: 2143	V_adc_a1: 0.402 V
Position: 7	DAC_Bits: 289	V_set_dac: 0.353 V	V_set_pot: 0.354 V	ADC_A0_raw: 1893	V_adc_a0: 0.355 V	ADC_A1_raw: 1878	V_adc_a1: 0.352 V
Position: 6	DAC_Bits: 248	V_set_dac: 0.303 V	V_set_pot: 0.303 V	ADC_A0_raw: 1620	V_adc_a0: 0.304 V	ADC_A1_raw: 1612	V_adc_a1: 0.302 V
Position: 5	DAC_Bits: 206	V_set_dac: 0.252 V	V_set_pot: 0.253 V	ADC_A0_raw: 1348	V_adc_a0: 0.253 V	ADC_A1_raw: 1339	V_adc_a1: 0.251 V
Position: 4	DAC_Bits: 165	V_set_dac: 0.201 V	V_set_pot: 0.202 V	ADC_A0_raw: 1077	V_adc_a0: 0.202 V	ADC_A1_raw: 1070	V_adc_a1: 0.201 V
Position: 3	DAC_Bits: 124	V_set_dac: 0.151 V	V_set_pot: 0.152 V	ADC_A0_raw: 808	V_adc_a0: 0.152 V	ADC_A1_raw: 798	V_adc_a1: 0.150 V
Position: 2	DAC_Bits: 82	V_set_dac: 0.100 V	V_set_pot: 0.101 V	ADC_A0_raw: 535	V_adc_a0: 0.100 V	ADC_A1_raw: 528	V_adc_a1: 0.099 V
Position: 1	DAC_Bits: 41	V_set_dac: 0.050 V	V_set_pot: 0.051 V	ADC_A0_raw: 264	V_adc_a0: 0.049 V	ADC_A1_raw: 262	V_adc_a1: 0.049 V
Position: 0	DAC_Bits: 0	V_set_dac: 0.000 V	V_set_pot: 0.000 V	ADC_A0_raw: -7	V_adc_a0: -0.001 V	ADC_A1_raw: 0	V_adc_a1: 0.000 V
Position: 0	DAC_Bits: 0	V_set_dac: 0.000 V	V_set_pot: 0.000 V	ADC_A0_raw: -7	V_adc_a0: -0.001 V	ADC_A1_raw: 0	V_adc_a1: 0.000 V
Position: 1	DAC_Bits: 41	V_set_dac: 0.050 V	V_set_pot: 0.051 V	ADC_A0_raw: 263	V_adc_a0: 0.049 V	ADC_A1_raw: 262	V_adc_a1: 0.049 V
Position: 2	DAC_Bits: 82	V_set_dac: 0.100 V	V_set_pot: 0.101 V	ADC_A0_raw: 536	V_adc_a0: 0.101 V	ADC_A1_raw: 527	V_adc_a1: 0.099 V
Position: 3	DAC_Bits: 124	V_set_dac: 0.151 V	V_set_pot: 0.152 V	ADC_A0_raw: 807	V_adc_a0: 0.151 V	ADC_A1_raw: 798	V_adc_a1: 0.150 V
Position: 4	DAC_Bits: 165	V_set_dac: 0.201 V	V_set_pot: 0.202 V	ADC_A0_raw: 1078	V_adc_a0: 0.202 V	ADC_A1_raw: 1070	V_adc_a1: 0.201 V
Position: 5	DAC_Bits: 206	V_set_dac: 0.252 V	V_set_pot: 0.253 V	ADC_A0_raw: 1348	V_adc_a0: 0.253 V	ADC_A1_raw: 1338	V_adc_a1: 0.251 V
Position: 6	DAC_Bits: 248	V_set_dac: 0.303 V	V_set_pot: 0.303 V	ADC_A0_raw: 1622	V_adc_a0: 0.304 V	ADC_A1_raw: 1611	V_adc_a1: 0.302 V
Position: 7	DAC_Bits: 289	V_set_dac: 0.353 V	V_set_pot: 0.354 V	ADC_A0_raw: 1893	V_adc_a0: 0.355 V	ADC_A1_raw: 1878	V_adc_a1: 0.352 V
Position: 8	DAC_Bits: 330	V_set_dac: 0.403 V	V_set_pot: 0.404 V	ADC_A0_raw: 2160	V_adc_a0: 0.405 V	ADC_A1_raw: 2143	V_adc_a1: 0.402 V
Position: 9	DAC_Bits: 372	V_set_dac: 0.454 V	V_set_pot: 0.455 V	ADC_A0_raw: 2432	V_adc_a0: 0.456 V	ADC_A1_raw: 2414	V_adc_a1: 0.453 V
Position: 10	DAC_Bits: 413	V_set_dac: 0.504 V	V_set_pot: 0.505 V	ADC_A0_raw: 2705	V_adc_a0: 0.507 V	ADC_A1_raw: 2676	V_adc_a1: 0.502 V
Position: 11	DAC_Bits: 455	V_set_dac: 0.556 V	V_set_pot: 0.556 V	ADC_A0_raw: 2973	V_adc_a0: 0.557 V	ADC_A1_raw: 2948	V_adc_a1: 0.553 V
Position: 12	DAC_Bits: 496	V_set_dac: 0.606 V	V_set_pot: 0.606 V	ADC_A0_raw: 3246	V_adc_a0: 0.609 V	ADC_A1_raw: 3220	V_adc_a1: 0.604 V
Position: 13	DAC_Bits: 537	V_set_dac: 0.656 V	V_set_pot: 0.657 V	ADC_A0_raw: 3515	V_adc_a0: 0.659 V	ADC_A1_raw: 3491	V_adc_a1: 0.655 V
Position: 14	DAC_Bits: 579	V_set_dac: 0.707 V	V_set_pot: 0.707 V	ADC_A0_raw: 3786	V_adc_a0: 0.710 V	ADC_A1_raw: 3764	V_adc_a1: 0.706 V
Position: 15	DAC_Bits: 620	V_set_dac: 0.757 V	V_set_pot: 0.758 V	ADC_A0_raw: 4056	V_adc_a0: 0.761 V	ADC_A1_raw: 4030	V_adc_a1: 0.756 V
Position: 16	DAC_Bits: 661	V_set_dac: 0.807 V	V_set_pot: 0.808 V	ADC_A0_raw: 4331	V_adc_a0: 0.812 V	ADC_A1_raw: 4295	V_adc_a1: 0.805 V
Position: 17	DAC_Bits: 703	V_set_dac: 0.858 V	V_set_pot: 0.859 V	ADC_A0_raw: 4597	V_adc_a0: 0.862 V	ADC_A1_raw: 4565	V_adc_a1: 0.856 V
Position: 18	DAC_Bits: 744	V_set_dac: 0.908 V	V_set_pot: 0.909 V	ADC_A0_raw: 4872	V_adc_a0: 0.914 V	ADC_A1_raw: 4829	V_adc_a1: 0.905 V
Position: 19	DAC_Bits: 785	V_set_dac: 0.958 V	V_set_pot: 0.960 V	ADC_A0_raw: 5145	V_adc_a0: 0.965 V	ADC_A1_raw: 5095	V_adc_a1: 0.955 V
Position: 20	DAC_Bits: 827	V_set_dac: 1.010 V	V_set_pot: 1.010 V	ADC_A0_raw: 5412	V_adc_a0: 1.015 V	ADC_A1_raw: 5369	V_adc_a1: 1.007 V
Position: 21	DAC_Bits: 868	V_set_dac: 1.060 V	V_set_pot: 1.061 V	ADC_A0_raw: 5685	V_adc_a0: 1.066 V	ADC_A1_raw: 5638	V_adc_a1: 1.057 V
Position: 22	DAC_Bits: 910	V_set_dac: 1.111 V	V_set_pot: 1.111 V	ADC_A0_raw: 5955	V_adc_a0: 1.117 V	ADC_A1_raw: 5913	V_adc_a1: 1.109 V
Position: 23	DAC_Bits: 951	V_set_dac: 1.161 V	V_set_pot: 1.162 V	ADC_A0_raw: 6227	V_adc_a0: 1.168 V	ADC_A1_raw: 6177	V_adc_a1: 1.158 V
Position: 24	DAC_Bits: 992	V_set_dac: 1.211 V	V_set_pot: 1.212 V	ADC_A0_raw: 6496	V_adc_a0: 1.218 V	ADC_A1_raw: 6450	V_adc_a1: 1.209 V
Position: 25	DAC_Bits: 1034	V_set_dac: 1.263 V	V_set_pot: 1.263 V	ADC_A0_raw: 6766	V_adc_a0: 1.269 V	ADC_A1_raw: 6732	V_adc_a1: 1.262 V
Position: 26	DAC_Bits: 1075	V_set_dac: 1.313 V	V_set_pot: 1.313 V	ADC_A0_raw: 7035	V_adc_a0: 1.319 V	ADC_A1_raw: 7000	V_adc_a1: 1.312 V
Position: 27	DAC_Bits: 1116	V_set_dac: 1.363 V	V_set_pot: 1.364 V	ADC_A0_raw: 7310	V_adc_a0: 1.371 V	ADC_A1_raw: 7267	V_adc_a1: 1.363 V
Position: 28	DAC_Bits: 1158	V_set_dac: 1.414 V	V_set_pot: 1.414 V	ADC_A0_raw: 7578	V_adc_a0: 1.421 V	ADC_A1_raw: 7540	V_adc_a1: 1.414 V
Position: 29	DAC_Bits: 1199	V_set_dac: 1.464 V	V_set_pot: 1.465 V	ADC_A0_raw: 7853	V_adc_a0: 1.472 V	ADC_A1_raw: 7807	V_adc_a1: 1.464 V
Position: 30	DAC_Bits: 1240	V_set_dac: 1.514 V	V_set_pot: 1.515 V	ADC_A0_raw: 8116	V_adc_a0: 1.522 V	ADC_A1_raw: 8070	V_adc_a1: 1.513 V
Position: 31	DAC_Bits: 1282	V_set_dac: 1.565 V	V_set_pot: 1.566 V	ADC_A0_raw: 8389	V_adc_a0: 1.573 V	ADC_A1_raw: 8341	V_adc_a1: 1.564 V
Position: 32	DAC_Bits: 1323	V_set_dac: 1.615 V	V_set_pot: 1.616 V	ADC_A0_raw: 8661	V_adc_a0: 1.624 V	ADC_A1_raw: 8606	V_adc_a1: 1.614 V
Position: 33	DAC_Bits: 1365	V_set_dac: 1.667 V	V_set_pot: 1.667 V	ADC_A0_raw: 8937	V_adc_a0: 1.676 V	ADC_A1_raw: 8880	V_adc_a1: 1.665 V
Position: 34	DAC_Bits: 1406	V_set_dac: 1.717 V	V_set_pot: 1.717 V	ADC_A0_raw: 9205	V_adc_a0: 1.726 V	ADC_A1_raw: 9149	V_adc_a1: 1.715 V
Position: 35	DAC_Bits: 1447	V_set_dac: 1.767 V	V_set_pot: 1.768 V	ADC_A0_raw: 9479	V_adc_a0: 1.777 V	ADC_A1_raw: 9418	V_adc_a1: 1.766 V
Position: 36	DAC_Bits: 1489	V_set_dac: 1.818 V	V_set_pot: 1.818 V	ADC_A0_raw: 9745	V_adc_a0: 1.827 V	ADC_A1_raw: 9693	V_adc_a1: 1.817 V
Position: 37	DAC_Bits: 1530	V_set_dac: 1.868 V	V_set_pot: 1.869 V	ADC_A0_raw: 10018	V_adc_a0: 1.878 V	ADC_A1_raw: 9964	V_adc_a1: 1.868 V
Position: 38	DAC_Bits: 1571	V_set_dac: 1.918 V	V_set_pot: 1.919 V	ADC_A0_raw: 10285	V_adc_a0: 1.928 V	ADC_A1_raw: 10229	V_adc_a1: 1.918 V
Position: 39	DAC_Bits: 1613	V_set_dac: 1.969 V	V_set_pot: 1.970 V	ADC_A0_raw: 10558	V_adc_a0: 1.980 V	ADC_A1_raw: 10497	V_adc_a1: 1.968 V
Position: 40	DAC_Bits: 1654	V_set_dac: 2.020 V	V_set_pot: 2.020 V	ADC_A0_raw: 10830	V_adc_a0: 2.031 V	ADC_A1_raw: 10760	V_adc_a1: 2.017 V
Position: 41	DAC_Bits: 1695	V_set_dac: 2.070 V	V_set_pot: 2.071 V	ADC_A0_raw: 11099	V_adc_a0: 2.081 V	ADC_A1_raw: 11027	V_adc_a1: 2.068 V
Position: 42	DAC_Bits: 1737	V_set_dac: 2.121 V	V_set_pot: 2.121 V	ADC_A0_raw: 11368	V_adc_a0: 2.132 V	ADC_A1_raw: 11300	V_adc_a1: 2.119 V
Position: 43	DAC_Bits: 1778	V_set_dac: 2.171 V	V_set_pot: 2.172 V	ADC_A0_raw: 11637	V_adc_a0: 2.182 V	ADC_A1_raw: 11565	V_adc_a1: 2.168 V
Position: 44	DAC_Bits: 1820	V_set_dac: 2.222 V	V_set_pot: 2.222 V	ADC_A0_raw: 11911	V_adc_a0: 2.233 V	ADC_A1_raw: 11838	V_adc_a1: 2.220 V
Position: 45	DAC_Bits: 1861	V_set_dac: 2.272 V	V_set_pot: 2.273 V	ADC_A0_raw: 12186	V_adc_a0: 2.285 V	ADC_A1_raw: 12108	V_adc_a1: 2.270 V
Position: 46	DAC_Bits: 1902	V_set_dac: 2.322 V	V_set_pot: 2.323 V	ADC_A0_raw: 12451	V_adc_a0: 2.335 V	ADC_A1_raw: 12375	V_adc_a1: 2.320 V
Position: 47	DAC_Bits: 1944	V_set_dac: 2.374 V	V_set_pot: 2.374 V	ADC_A0_raw: 12723	V_adc_a0: 2.386 V	ADC_A1_raw: 12648	V_adc_a1: 2.372 V
Position: 48	DAC_Bits: 1985	V_set_dac: 2.424 V	V_set_pot: 2.424 V	ADC_A0_raw: 12994	V_adc_a0: 2.436 V	ADC_A1_raw: 12912	V_adc_a1: 2.421 V
Position: 49	DAC_Bits: 2026	V_set_dac: 2.474 V	V_set_pot: 2.475 V	ADC_A0_raw: 13262	V_adc_a0: 2.487 V	ADC_A1_raw: 13184	V_adc_a1: 2.472 V
Position: 50	DAC_Bits: 2068	V_set_dac: 2.525 V	V_set_pot: 2.525 V	ADC_A0_raw: 13536	V_adc_a0: 2.538 V	ADC_A1_raw: 13465	V_adc_a1: 2.525 V
Position: 51	DAC_Bits: 2109	V_set_dac: 2.575 V	V_set_pot: 2.576 V	ADC_A0_raw: 13808	V_adc_a0: 2.589 V	ADC_A1_raw: 13733	V_adc_a1: 2.575 V
Position: 52	DAC_Bits: 2150	V_set_dac: 2.625 V	V_set_pot: 2.626 V	ADC_A0_raw: 14079	V_adc_a0: 2.640 V	ADC_A1_raw: 14005	V_adc_a1: 2.626 V
Position: 53	DAC_Bits: 2192	V_set_dac: 2.676 V	V_set_pot: 2.677 V	ADC_A0_raw: 14355	V_adc_a0: 2.692 V	ADC_A1_raw: 14281	V_adc_a1: 2.678 V
Position: 54	DAC_Bits: 2233	V_set_dac: 2.726 V	V_set_pot: 2.727 V	ADC_A0_raw: 14629	V_adc_a0: 2.743 V	ADC_A1_raw: 14543	V_adc_a1: 2.727 V
Position: 55	DAC_Bits: 2275	V_set_dac: 2.778 V	V_set_pot: 2.778 V	ADC_A0_raw: 14896	V_adc_a0: 2.793 V	ADC_A1_raw: 14822	V_adc_a1: 2.779 V
Position: 56	DAC_Bits: 2316	V_set_dac: 2.828 V	V_set_pot: 2.828 V	ADC_A0_raw: 15166	V_adc_a0: 2.844 V	ADC_A1_raw: 15091	V_adc_a1: 2.830 V
Position: 57	DAC_Bits: 2357	V_set_dac: 2.878 V	V_set_pot: 2.879 V	ADC_A0_raw: 15442	V_adc_a0: 2.895 V	ADC_A1_raw: 15357	V_adc_a1: 2.879 V
Position: 58	DAC_Bits: 2399	V_set_dac: 2.929 V	V_set_pot: 2.929 V	ADC_A0_raw: 15714	V_adc_a0: 2.946 V	ADC_A1_raw: 15632	V_adc_a1: 2.931 V
Position: 59	DAC_Bits: 2440	V_set_dac: 2.979 V	V_set_pot: 2.980 V	ADC_A0_raw: 15986	V_adc_a0: 2.997 V	ADC_A1_raw: 15899	V_adc_a1: 2.981 V
Position: 60	DAC_Bits: 2481	V_set_dac: 3.029 V	V_set_pot: 3.030 V	ADC_A0_raw: 16255	V_adc_a0: 3.048 V	ADC_A1_raw: 16172	V_adc_a1: 3.032 V
Position: 61	DAC_Bits: 2523	V_set_dac: 3.081 V	V_set_pot: 3.081 V	ADC_A0_raw: 16530	V_adc_a0: 3.099 V	ADC_A1_raw: 16453	V_adc_a1: 3.085 V
Position: 62	DAC_Bits: 2564	V_set_dac: 3.131 V	V_set_pot: 3.131 V	ADC_A0_raw: 16800	V_adc_a0: 3.150 V	ADC_A1_raw: 16728	V_adc_a1: 3.137 V
Position: 63	DAC_Bits: 2605	V_set_dac: 3.181 V	V_set_pot: 3.182 V	ADC_A0_raw: 17068	V_adc_a0: 3.200 V	ADC_A1_raw: 16997	V_adc_a1: 3.187 V
Position: 64	DAC_Bits: 2647	V_set_dac: 3.232 V	V_set_pot: 3.232 V	ADC_A0_raw: 17345	V_adc_a0: 3.252 V	ADC_A1_raw: 17270	V_adc_a1: 3.238 V
Position: 65	DAC_Bits: 2688	V_set_dac: 3.282 V	V_set_pot: 3.283 V	ADC_A0_raw: 17614	V_adc_a0: 3.303 V	ADC_A1_raw: 17542	V_adc_a1: 3.289 V
Position: 66	DAC_Bits: 2730	V_set_dac: 3.333 V	V_set_pot: 3.333 V	ADC_A0_raw: 17886	V_adc_a0: 3.354 V	ADC_A1_raw: 17817	V_adc_a1: 3.341 V
Position: 67	DAC_Bits: 2771	V_set_dac: 3.383 V	V_set_pot: 3.384 V	ADC_A0_raw: 18162	V_adc_a0: 3.405 V	ADC_A1_raw: 18087	V_adc_a1: 3.391 V
Position: 68	DAC_Bits: 2812	V_set_dac: 3.433 V	V_set_pot: 3.434 V	ADC_A0_raw: 18428	V_adc_a0: 3.455 V	ADC_A1_raw: 18354	V_adc_a1: 3.441 V
Position: 69	DAC_Bits: 2854	V_set_dac: 3.485 V	V_set_pot: 3.485 V	ADC_A0_raw: 18699	V_adc_a0: 3.506 V	ADC_A1_raw: 18625	V_adc_a1: 3.492 V
Position: 70	DAC_Bits: 2895	V_set_dac: 3.535 V	V_set_pot: 3.535 V	ADC_A0_raw: 18971	V_adc_a0: 3.557 V	ADC_A1_raw: 18890	V_adc_a1: 3.542 V
Position: 71	DAC_Bits: 2936	V_set_dac: 3.585 V	V_set_pot: 3.586 V	ADC_A0_raw: 19244	V_adc_a0: 3.608 V	ADC_A1_raw: 19155	V_adc_a1: 3.592 V
Position: 72	DAC_Bits: 2978	V_set_dac: 3.636 V	V_set_pot: 3.636 V	ADC_A0_raw: 19513	V_adc_a0: 3.659 V	ADC_A1_raw: 19428	V_adc_a1: 3.643 V
Position: 73	DAC_Bits: 3019	V_set_dac: 3.686 V	V_set_pot: 3.687 V	ADC_A0_raw: 19764	V_adc_a0: 3.706 V	ADC_A1_raw: 19690	V_adc_a1: 3.692 V
Position: 74	DAC_Bits: 3060	V_set_dac: 3.736 V	V_set_pot: 3.737 V	ADC_A0_raw: 19975	V_adc_a0: 3.745 V	ADC_A1_raw: 19934	V_adc_a1: 3.738 V
Position: 75	DAC_Bits: 3102	V_set_dac: 3.788 V	V_set_pot: 3.788 V	ADC_A0_raw: 20113	V_adc_a0: 3.771 V	ADC_A1_raw: 20122	V_adc_a1: 3.773 V
Position: 76	DAC_Bits: 3143	V_set_dac: 3.838 V	V_set_pot: 3.838 V	ADC_A0_raw: 20190	V_adc_a0: 3.786 V	ADC_A1_raw: 20221	V_adc_a1: 3.791 V
Position: 77	DAC_Bits: 3185	V_set_dac: 3.889 V	V_set_pot: 3.889 V	ADC_A0_raw: 20230	V_adc_a0: 3.793 V	ADC_A1_raw: 20270	V_adc_a1: 3.801 V
Position: 78	DAC_Bits: 3226	V_set_dac: 3.939 V	V_set_pot: 3.939 V	ADC_A0_raw: 20250	V_adc_a0: 3.797 V	ADC_A1_raw: 20250	V_adc_a1: 3.797 V
Position: 79	DAC_Bits: 3267	V_set_dac: 3.989 V	V_set_pot: 3.990 V	ADC_A0_raw: 20230	V_adc_a0: 3.793 V	ADC_A1_raw: 20230	V_adc_a1: 3.793 V
Position: 80	DAC_Bits: 3309	V_set_dac: 4.040 V	V_set_pot: 4.040 V	ADC_A0_raw: 20189	V_adc_a0: 3.785 V	ADC_A1_raw: 20149	V_adc_a1: 3.778 V
Position: 81	DAC_Bits: 3350	V_set_dac: 4.090 V	V_set_pot: 4.091 V	ADC_A0_raw: 20169	V_adc_a0: 3.782 V	ADC_A1_raw: 20108	V_adc_a1: 3.770 V
Position: 82	DAC_Bits: 3391	V_set_dac: 4.140 V	V_set_pot: 4.141 V	ADC_A0_raw: 20149	V_adc_a0: 3.778 V	ADC_A1_raw: 20027	V_adc_a1: 3.755 V
Position: 83	DAC_Bits: 3433	V_set_dac: 4.192 V	V_set_pot: 4.192 V	ADC_A0_raw: 20149	V_adc_a0: 3.778 V	ADC_A1_raw: 19967	V_adc_a1: 3.744 V
Position: 84	DAC_Bits: 3474	V_set_dac: 4.242 V	V_set_pot: 4.242 V	ADC_A0_raw: 20149	V_adc_a0: 3.778 V	ADC_A1_raw: 19967	V_adc_a1: 3.744 V
Position: 85	DAC_Bits: 3515	V_set_dac: 4.292 V	V_set_pot: 4.293 V	ADC_A0_raw: 20129	V_adc_a0: 3.774 V	ADC_A1_raw: 19946	V_adc_a1: 3.740 V
Position: 86	DAC_Bits: 3557	V_set_dac: 4.343 V	V_set_pot: 4.343 V	ADC_A0_raw: 20108	V_adc_a0: 3.770 V	ADC_A1_raw: 19946	V_adc_a1: 3.740 V
Position: 87	DAC_Bits: 3598	V_set_dac: 4.393 V	V_set_pot: 4.394 V	ADC_A0_raw: 20088	V_adc_a0: 3.766 V	ADC_A1_raw: 19926	V_adc_a1: 3.736 V
Position: 88	DAC_Bits: 3640	V_set_dac: 4.444 V	V_set_pot: 4.444 V	ADC_A0_raw: 20088	V_adc_a0: 3.766 V	ADC_A1_raw: 19926	V_adc_a1: 3.736 V
Position: 89	DAC_Bits: 3681	V_set_dac: 4.495 V	V_set_pot: 4.495 V	ADC_A0_raw: 20088	V_adc_a0: 3.766 V	ADC_A1_raw: 19906	V_adc_a1: 3.732 V
Position: 90	DAC_Bits: 3722	V_set_dac: 4.545 V	V_set_pot: 4.545 V	ADC_A0_raw: 20088	V_adc_a0: 3.766 V	ADC_A1_raw: 19906	V_adc_a1: 3.732 V
Position: 91	DAC_Bits: 3764	V_set_dac: 4.596 V	V_set_pot: 4.596 V	ADC_A0_raw: 20048	V_adc_a0: 3.759 V	ADC_A1_raw: 19886	V_adc_a1: 3.729 V
Position: 92	DAC_Bits: 3805	V_set_dac: 4.646 V	V_set_pot: 4.646 V	ADC_A0_raw: 20027	V_adc_a0: 3.755 V	ADC_A1_raw: 19865	V_adc_a1: 3.725 V
Position: 93	DAC_Bits: 3846	V_set_dac: 4.696 V	V_set_pot: 4.697 V	ADC_A0_raw: 19987	V_adc_a0: 3.748 V	ADC_A1_raw: 19865	V_adc_a1: 3.725 V
Position: 94	DAC_Bits: 3888	V_set_dac: 4.747 V	V_set_pot: 4.747 V	ADC_A0_raw: 19967	V_adc_a0: 3.744 V	ADC_A1_raw: 19865	V_adc_a1: 3.725 V
Position: 95	DAC_Bits: 3929	V_set_dac: 4.797 V	V_set_pot: 4.798 V	ADC_A0_raw: 19946	V_adc_a0: 3.740 V	ADC_A1_raw: 19845	V_adc_a1: 3.721 V
Position: 96	DAC_Bits: 3970	V_set_dac: 4.847 V	V_set_pot: 4.848 V	ADC_A0_raw: 19926	V_adc_a0: 3.736 V	ADC_A1_raw: 19825	V_adc_a1: 3.717 V
Position: 97	DAC_Bits: 4012	V_set_dac: 4.899 V	V_set_pot: 4.899 V	ADC_A0_raw: 19886	V_adc_a0: 3.729 V	ADC_A1_raw: 19805	V_adc_a1: 3.713 V
Position: 98	DAC_Bits: 4053	V_set_dac: 4.949 V	V_set_pot: 4.949 V	ADC_A0_raw: 19805	V_adc_a0: 3.713 V	ADC_A1_raw: 19764	V_adc_a1: 3.706 V
Position: 99	DAC_Bits: 4095	V_set_dac: 5.000 V	V_set_pot: 5.000 V	ADC_A0_raw: 19541	V_adc_a0: 3.664 V	ADC_A1_raw: 19724	V_adc_a1: 3.698 V
Position: 99	DAC_Bits: 4095	V_set_dac: 5.000 V	V_set_pot: 5.000 V	ADC_A0_raw: 19582	V_adc_a0: 3.672 V	ADC_A1_raw: 19703	V_adc_a1: 3.694 V
Position: 98	DAC_Bits: 4053	V_set_dac: 4.949 V	V_set_pot: 4.949 V	ADC_A0_raw: 19805	V_adc_a0: 3.713 V	ADC_A1_raw: 19764	V_adc_a1: 3.706 V
Position: 97	DAC_Bits: 4012	V_set_dac: 4.899 V	V_set_pot: 4.899 V	ADC_A0_raw: 19865	V_adc_a0: 3.725 V	ADC_A1_raw: 19784	V_adc_a1: 3.710 V
Position: 96	DAC_Bits: 3970	V_set_dac: 4.847 V	V_set_pot: 4.848 V	ADC_A0_raw: 19886	V_adc_a0: 3.729 V	ADC_A1_raw: 19825	V_adc_a1: 3.717 V
Position: 95	DAC_Bits: 3929	V_set_dac: 4.797 V	V_set_pot: 4.798 V	ADC_A0_raw: 19926	V_adc_a0: 3.736 V	ADC_A1_raw: 19845	V_adc_a1: 3.721 V
Position: 94	DAC_Bits: 3888	V_set_dac: 4.747 V	V_set_pot: 4.747 V	ADC_A0_raw: 19967	V_adc_a0: 3.744 V	ADC_A1_raw: 19845	V_adc_a1: 3.721 V
Position: 93	DAC_Bits: 3846	V_set_dac: 4.696 V	V_set_pot: 4.697 V	ADC_A0_raw: 19987	V_adc_a0: 3.748 V	ADC_A1_raw: 19845	V_adc_a1: 3.721 V
Position: 92	DAC_Bits: 3805	V_set_dac: 4.646 V	V_set_pot: 4.646 V	ADC_A0_raw: 20027	V_adc_a0: 3.755 V	ADC_A1_raw: 19865	V_adc_a1: 3.725 V
Position: 91	DAC_Bits: 3764	V_set_dac: 4.596 V	V_set_pot: 4.596 V	ADC_A0_raw: 20048	V_adc_a0: 3.759 V	ADC_A1_raw: 19886	V_adc_a1: 3.729 V
Position: 90	DAC_Bits: 3722	V_set_dac: 4.545 V	V_set_pot: 4.545 V	ADC_A0_raw: 20088	V_adc_a0: 3.766 V	ADC_A1_raw: 19886	V_adc_a1: 3.729 V
Position: 89	DAC_Bits: 3681	V_set_dac: 4.495 V	V_set_pot: 4.495 V	ADC_A0_raw: 20088	V_adc_a0: 3.766 V	ADC_A1_raw: 19906	V_adc_a1: 3.732 V
Position: 88	DAC_Bits: 3640	V_set_dac: 4.444 V	V_set_pot: 4.444 V	ADC_A0_raw: 20088	V_adc_a0: 3.766 V	ADC_A1_raw: 19906	V_adc_a1: 3.732 V
Position: 87	DAC_Bits: 3598	V_set_dac: 4.393 V	V_set_pot: 4.394 V	ADC_A0_raw: 20068	V_adc_a0: 3.763 V	ADC_A1_raw: 19926	V_adc_a1: 3.736 V
Position: 86	DAC_Bits: 3557	V_set_dac: 4.343 V	V_set_pot: 4.343 V	ADC_A0_raw: 20068	V_adc_a0: 3.763 V	ADC_A1_raw: 19926	V_adc_a1: 3.736 V
Position: 85	DAC_Bits: 3515	V_set_dac: 4.292 V	V_set_pot: 4.293 V	ADC_A0_raw: 20088	V_adc_a0: 3.766 V	ADC_A1_raw: 19946	V_adc_a1: 3.740 V
Position: 84	DAC_Bits: 3474	V_set_dac: 4.242 V	V_set_pot: 4.242 V	ADC_A0_raw: 20108	V_adc_a0: 3.770 V	ADC_A1_raw: 19946	V_adc_a1: 3.740 V
Position: 83	DAC_Bits: 3433	V_set_dac: 4.192 V	V_set_pot: 4.192 V	ADC_A0_raw: 20129	V_adc_a0: 3.774 V	ADC_A1_raw: 19967	V_adc_a1: 3.744 V
Position: 82	DAC_Bits: 3391	V_set_dac: 4.140 V	V_set_pot: 4.141 V	ADC_A0_raw: 20129	V_adc_a0: 3.774 V	ADC_A1_raw: 19987	V_adc_a1: 3.748 V
Position: 81	DAC_Bits: 3350	V_set_dac: 4.090 V	V_set_pot: 4.091 V	ADC_A0_raw: 20129	V_adc_a0: 3.774 V	ADC_A1_raw: 20088	V_adc_a1: 3.766 V
Position: 80	DAC_Bits: 3309	V_set_dac: 4.040 V	V_set_pot: 4.040 V	ADC_A0_raw: 20169	V_adc_a0: 3.782 V	ADC_A1_raw: 20129	V_adc_a1: 3.774 V
Position: 79	DAC_Bits: 3267	V_set_dac: 3.989 V	V_set_pot: 3.990 V	ADC_A0_raw: 20210	V_adc_a0: 3.789 V	ADC_A1_raw: 20189	V_adc_a1: 3.785 V
Position: 78	DAC_Bits: 3226	V_set_dac: 3.939 V	V_set_pot: 3.939 V	ADC_A0_raw: 20210	V_adc_a0: 3.789 V	ADC_A1_raw: 20230	V_adc_a1: 3.793 V
Position: 77	DAC_Bits: 3185	V_set_dac: 3.889 V	V_set_pot: 3.889 V	ADC_A0_raw: 20210	V_adc_a0: 3.789 V	ADC_A1_raw: 20230	V_adc_a1: 3.793 V
Position: 76	DAC_Bits: 3143	V_set_dac: 3.838 V	V_set_pot: 3.838 V	ADC_A0_raw: 20174	V_adc_a0: 3.783 V	ADC_A1_raw: 20207	V_adc_a1: 3.789 V
Position: 75	DAC_Bits: 3102	V_set_dac: 3.788 V	V_set_pot: 3.788 V	ADC_A0_raw: 20102	V_adc_a0: 3.769 V	ADC_A1_raw: 20113	V_adc_a1: 3.771 V
Position: 74	DAC_Bits: 3060	V_set_dac: 3.736 V	V_set_pot: 3.737 V	ADC_A0_raw: 19968	V_adc_a0: 3.744 V	ADC_A1_raw: 19931	V_adc_a1: 3.737 V
Position: 73	DAC_Bits: 3019	V_set_dac: 3.686 V	V_set_pot: 3.687 V	ADC_A0_raw: 19765	V_adc_a0: 3.706 V	ADC_A1_raw: 19691	V_adc_a1: 3.692 V
Position: 72	DAC_Bits: 2978	V_set_dac: 3.636 V	V_set_pot: 3.636 V	ADC_A0_raw: 19513	V_adc_a0: 3.659 V	ADC_A1_raw: 19428	V_adc_a1: 3.643 V
Position: 71	DAC_Bits: 2936	V_set_dac: 3.585 V	V_set_pot: 3.586 V	ADC_A0_raw: 19247	V_adc_a0: 3.609 V	ADC_A1_raw: 19155	V_adc_a1: 3.592 V
Position: 70	DAC_Bits: 2895	V_set_dac: 3.535 V	V_set_pot: 3.535 V	ADC_A0_raw: 18973	V_adc_a0: 3.557 V	ADC_A1_raw: 18890	V_adc_a1: 3.542 V
Position: 69	DAC_Bits: 2854	V_set_dac: 3.485 V	V_set_pot: 3.485 V	ADC_A0_raw: 18701	V_adc_a0: 3.506 V	ADC_A1_raw: 18625	V_adc_a1: 3.492 V
Position: 68	DAC_Bits: 2812	V_set_dac: 3.433 V	V_set_pot: 3.434 V	ADC_A0_raw: 18434	V_adc_a0: 3.456 V	ADC_A1_raw: 18355	V_adc_a1: 3.442 V
Position: 67	DAC_Bits: 2771	V_set_dac: 3.383 V	V_set_pot: 3.384 V	ADC_A0_raw: 18161	V_adc_a0: 3.405 V	ADC_A1_raw: 18085	V_adc_a1: 3.391 V
Position: 66	DAC_Bits: 2730	V_set_dac: 3.333 V	V_set_pot: 3.333 V	ADC_A0_raw: 17888	V_adc_a0: 3.354 V	ADC_A1_raw: 17818	V_adc_a1: 3.341 V
Position: 65	DAC_Bits: 2688	V_set_dac: 3.282 V	V_set_pot: 3.283 V	ADC_A0_raw: 17616	V_adc_a0: 3.303 V	ADC_A1_raw: 17541	V_adc_a1: 3.289 V
Position: 64	DAC_Bits: 2647	V_set_dac: 3.232 V	V_set_pot: 3.232 V	ADC_A0_raw: 17340	V_adc_a0: 3.251 V	ADC_A1_raw: 17272	V_adc_a1: 3.239 V
Position: 63	DAC_Bits: 2605	V_set_dac: 3.181 V	V_set_pot: 3.182 V	ADC_A0_raw: 17071	V_adc_a0: 3.201 V	ADC_A1_raw: 16999	V_adc_a1: 3.187 V
Position: 62	DAC_Bits: 2564	V_set_dac: 3.131 V	V_set_pot: 3.131 V	ADC_A0_raw: 16802	V_adc_a0: 3.150 V	ADC_A1_raw: 16731	V_adc_a1: 3.137 V
Position: 61	DAC_Bits: 2523	V_set_dac: 3.081 V	V_set_pot: 3.081 V	ADC_A0_raw: 16531	V_adc_a0: 3.100 V	ADC_A1_raw: 16453	V_adc_a1: 3.085 V
Position: 60	DAC_Bits: 2481	V_set_dac: 3.029 V	V_set_pot: 3.030 V	ADC_A0_raw: 16258	V_adc_a0: 3.048 V	ADC_A1_raw: 16171	V_adc_a1: 3.032 V
Position: 59	DAC_Bits: 2440	V_set_dac: 2.979 V	V_set_pot: 2.980 V	ADC_A0_raw: 15986	V_adc_a0: 2.997 V	ADC_A1_raw: 15900	V_adc_a1: 2.981 V
Position: 58	DAC_Bits: 2399	V_set_dac: 2.929 V	V_set_pot: 2.929 V	ADC_A0_raw: 15715	V_adc_a0: 2.947 V	ADC_A1_raw: 15632	V_adc_a1: 2.931 V
Position: 57	DAC_Bits: 2357	V_set_dac: 2.878 V	V_set_pot: 2.879 V	ADC_A0_raw: 15440	V_adc_a0: 2.895 V	ADC_A1_raw: 15358	V_adc_a1: 2.880 V
Position: 56	DAC_Bits: 2316	V_set_dac: 2.828 V	V_set_pot: 2.828 V	ADC_A0_raw: 15167	V_adc_a0: 2.844 V	ADC_A1_raw: 15089	V_adc_a1: 2.829 V
Position: 55	DAC_Bits: 2275	V_set_dac: 2.778 V	V_set_pot: 2.778 V	ADC_A0_raw: 14898	V_adc_a0: 2.793 V	ADC_A1_raw: 14821	V_adc_a1: 2.779 V
Position: 54	DAC_Bits: 2233	V_set_dac: 2.726 V	V_set_pot: 2.727 V	ADC_A0_raw: 14628	V_adc_a0: 2.743 V	ADC_A1_raw: 14545	V_adc_a1: 2.727 V
Position: 53	DAC_Bits: 2192	V_set_dac: 2.676 V	V_set_pot: 2.677 V	ADC_A0_raw: 14359	V_adc_a0: 2.692 V	ADC_A1_raw: 14283	V_adc_a1: 2.678 V
Position: 52	DAC_Bits: 2150	V_set_dac: 2.625 V	V_set_pot: 2.626 V	ADC_A0_raw: 14081	V_adc_a0: 2.640 V	ADC_A1_raw: 14006	V_adc_a1: 2.626 V
Position: 51	DAC_Bits: 2109	V_set_dac: 2.575 V	V_set_pot: 2.576 V	ADC_A0_raw: 13809	V_adc_a0: 2.589 V	ADC_A1_raw: 13734	V_adc_a1: 2.575 V
Position: 50	DAC_Bits: 2068	V_set_dac: 2.525 V	V_set_pot: 2.525 V	ADC_A0_raw: 13537	V_adc_a0: 2.538 V	ADC_A1_raw: 13464	V_adc_a1: 2.525 V
Position: 49	DAC_Bits: 2026	V_set_dac: 2.474 V	V_set_pot: 2.475 V	ADC_A0_raw: 13262	V_adc_a0: 2.487 V	ADC_A1_raw: 13183	V_adc_a1: 2.472 V
Position: 48	DAC_Bits: 1985	V_set_dac: 2.424 V	V_set_pot: 2.424 V	ADC_A0_raw: 12993	V_adc_a0: 2.436 V	ADC_A1_raw: 12912	V_adc_a1: 2.421 V
Position: 47	DAC_Bits: 1944	V_set_dac: 2.374 V	V_set_pot: 2.374 V	ADC_A0_raw: 12716	V_adc_a0: 2.384 V	ADC_A1_raw: 12647	V_adc_a1: 2.371 V
Position: 46	DAC_Bits: 1902	V_set_dac: 2.322 V	V_set_pot: 2.323 V	ADC_A0_raw: 12451	V_adc_a0: 2.335 V	ADC_A1_raw: 12376	V_adc_a1: 2.321 V
Position: 45	DAC_Bits: 1861	V_set_dac: 2.272 V	V_set_pot: 2.273 V	ADC_A0_raw: 12179	V_adc_a0: 2.284 V	ADC_A1_raw: 12109	V_adc_a1: 2.270 V
Position: 44	DAC_Bits: 1820	V_set_dac: 2.222 V	V_set_pot: 2.222 V	ADC_A0_raw: 11910	V_adc_a0: 2.233 V	ADC_A1_raw: 11838	V_adc_a1: 2.220 V
Position: 43	DAC_Bits: 1778	V_set_dac: 2.171 V	V_set_pot: 2.172 V	ADC_A0_raw: 11642	V_adc_a0: 2.183 V	ADC_A1_raw: 11566	V_adc_a1: 2.169 V
Position: 42	DAC_Bits: 1737	V_set_dac: 2.121 V	V_set_pot: 2.121 V	ADC_A0_raw: 11367	V_adc_a0: 2.131 V	ADC_A1_raw: 11301	V_adc_a1: 2.119 V
Position: 41	DAC_Bits: 1695	V_set_dac: 2.070 V	V_set_pot: 2.071 V	ADC_A0_raw: 11098	V_adc_a0: 2.081 V	ADC_A1_raw: 11027	V_adc_a1: 2.068 V
Position: 40	DAC_Bits: 1654	V_set_dac: 2.020 V	V_set_pot: 2.020 V	ADC_A0_raw: 10828	V_adc_a0: 2.030 V	ADC_A1_raw: 10760	V_adc_a1: 2.017 V
Position: 39	DAC_Bits: 1613	V_set_dac: 1.969 V	V_set_pot: 1.970 V	ADC_A0_raw: 10560	V_adc_a0: 1.980 V	ADC_A1_raw: 10496	V_adc_a1: 1.968 V
Position: 38	DAC_Bits: 1571	V_set_dac: 1.918 V	V_set_pot: 1.919 V	ADC_A0_raw: 10287	V_adc_a0: 1.929 V	ADC_A1_raw: 10229	V_adc_a1: 1.918 V
Position: 37	DAC_Bits: 1530	V_set_dac: 1.868 V	V_set_pot: 1.869 V	ADC_A0_raw: 10019	V_adc_a0: 1.879 V	ADC_A1_raw: 9965	V_adc_a1: 1.868 V
Position: 36	DAC_Bits: 1489	V_set_dac: 1.818 V	V_set_pot: 1.818 V	ADC_A0_raw: 9751	V_adc_a0: 1.828 V	ADC_A1_raw: 9693	V_adc_a1: 1.817 V
Position: 35	DAC_Bits: 1447	V_set_dac: 1.767 V	V_set_pot: 1.768 V	ADC_A0_raw: 9475	V_adc_a0: 1.777 V	ADC_A1_raw: 9417	V_adc_a1: 1.766 V
Position: 34	DAC_Bits: 1406	V_set_dac: 1.717 V	V_set_pot: 1.717 V	ADC_A0_raw: 9206	V_adc_a0: 1.726 V	ADC_A1_raw: 9149	V_adc_a1: 1.715 V
Position: 33	DAC_Bits: 1365	V_set_dac: 1.667 V	V_set_pot: 1.667 V	ADC_A0_raw: 8932	V_adc_a0: 1.675 V	ADC_A1_raw: 8881	V_adc_a1: 1.665 V
Position: 32	DAC_Bits: 1323	V_set_dac: 1.615 V	V_set_pot: 1.616 V	ADC_A0_raw: 8661	V_adc_a0: 1.624 V	ADC_A1_raw: 8607	V_adc_a1: 1.614 V
Position: 31	DAC_Bits: 1282	V_set_dac: 1.565 V	V_set_pot: 1.566 V	ADC_A0_raw: 8393	V_adc_a0: 1.574 V	ADC_A1_raw: 8342	V_adc_a1: 1.564 V
Position: 30	DAC_Bits: 1240	V_set_dac: 1.514 V	V_set_pot: 1.515 V	ADC_A0_raw: 8124	V_adc_a0: 1.523 V	ADC_A1_raw: 8070	V_adc_a1: 1.513 V
Position: 29	DAC_Bits: 1199	V_set_dac: 1.464 V	V_set_pot: 1.465 V	ADC_A0_raw: 7850	V_adc_a0: 1.472 V	ADC_A1_raw: 7806	V_adc_a1: 1.464 V
Position: 28	DAC_Bits: 1158	V_set_dac: 1.414 V	V_set_pot: 1.414 V	ADC_A0_raw: 7579	V_adc_a0: 1.421 V	ADC_A1_raw: 7541	V_adc_a1: 1.414 V
Position: 27	DAC_Bits: 1116	V_set_dac: 1.363 V	V_set_pot: 1.364 V	ADC_A0_raw: 7307	V_adc_a0: 1.370 V	ADC_A1_raw: 7267	V_adc_a1: 1.363 V
Position: 26	DAC_Bits: 1075	V_set_dac: 1.313 V	V_set_pot: 1.313 V	ADC_A0_raw: 7035	V_adc_a0: 1.319 V	ADC_A1_raw: 7000	V_adc_a1: 1.312 V
Position: 25	DAC_Bits: 1034	V_set_dac: 1.263 V	V_set_pot: 1.263 V	ADC_A0_raw: 6764	V_adc_a0: 1.268 V	ADC_A1_raw: 6731	V_adc_a1: 1.262 V
Position: 24	DAC_Bits: 992	V_set_dac: 1.211 V	V_set_pot: 1.212 V	ADC_A0_raw: 6496	V_adc_a0: 1.218 V	ADC_A1_raw: 6448	V_adc_a1: 1.209 V
Position: 23	DAC_Bits: 951	V_set_dac: 1.161 V	V_set_pot: 1.162 V	ADC_A0_raw: 6228	V_adc_a0: 1.168 V	ADC_A1_raw: 6176	V_adc_a1: 1.158 V
Position: 22	DAC_Bits: 910	V_set_dac: 1.111 V	V_set_pot: 1.111 V	ADC_A0_raw: 5956	V_adc_a0: 1.117 V	ADC_A1_raw: 5913	V_adc_a1: 1.109 V
Position: 21	DAC_Bits: 868	V_set_dac: 1.060 V	V_set_pot: 1.061 V	ADC_A0_raw: 5689	V_adc_a0: 1.067 V	ADC_A1_raw: 5638	V_adc_a1: 1.057 V
Position: 20	DAC_Bits: 827	V_set_dac: 1.010 V	V_set_pot: 1.010 V	ADC_A0_raw: 5413	V_adc_a0: 1.015 V	ADC_A1_raw: 5368	V_adc_a1: 1.007 V
Position: 19	DAC_Bits: 785	V_set_dac: 0.958 V	V_set_pot: 0.960 V	ADC_A0_raw: 5143	V_adc_a0: 0.964 V	ADC_A1_raw: 5094	V_adc_a1: 0.955 V
Position: 18	DAC_Bits: 744	V_set_dac: 0.908 V	V_set_pot: 0.909 V	ADC_A0_raw: 4871	V_adc_a0: 0.913 V	ADC_A1_raw: 4829	V_adc_a1: 0.905 V
Position: 17	DAC_Bits: 703	V_set_dac: 0.858 V	V_set_pot: 0.859 V	ADC_A0_raw: 4599	V_adc_a0: 0.862 V	ADC_A1_raw: 4564	V_adc_a1: 0.856 V
Position: 16	DAC_Bits: 661	V_set_dac: 0.807 V	V_set_pot: 0.808 V	ADC_A0_raw: 4329	V_adc_a0: 0.812 V	ADC_A1_raw: 4294	V_adc_a1: 0.805 V
Position: 15	DAC_Bits: 620	V_set_dac: 0.757 V	V_set_pot: 0.758 V	ADC_A0_raw: 4058	V_adc_a0: 0.761 V	ADC_A1_raw: 4030	V_adc_a1: 0.756 V
Position: 14	DAC_Bits: 579	V_set_dac: 0.707 V	V_set_pot: 0.707 V	ADC_A0_raw: 3786	V_adc_a0: 0.710 V	ADC_A1_raw: 3763	V_adc_a1: 0.706 V
Position: 13	DAC_Bits: 537	V_set_dac: 0.656 V	V_set_pot: 0.657 V	ADC_A0_raw: 3515	V_adc_a0: 0.659 V	ADC_A1_raw: 3490	V_adc_a1: 0.654 V
Position: 12	DAC_Bits: 496	V_set_dac: 0.606 V	V_set_pot: 0.606 V	ADC_A0_raw: 3246	V_adc_a0: 0.609 V	ADC_A1_raw: 3221	V_adc_a1: 0.604 V
Position: 11	DAC_Bits: 455	V_set_dac: 0.556 V	V_set_pot: 0.556 V	ADC_A0_raw: 2973	V_adc_a0: 0.557 V	ADC_A1_raw: 2947	V_adc_a1: 0.553 V
Position: 10	DAC_Bits: 413	V_set_dac: 0.504 V	V_set_pot: 0.505 V	ADC_A0_raw: 2702	V_adc_a0: 0.507 V	ADC_A1_raw: 2677	V_adc_a1: 0.502 V
Position: 9	DAC_Bits: 372	V_set_dac: 0.454 V	V_set_pot: 0.455 V	ADC_A0_raw: 2432	V_adc_a0: 0.456 V	ADC_A1_raw: 2413	V_adc_a1: 0.452 V
Position: 8	DAC_Bits: 330	V_set_dac: 0.403 V	V_set_pot: 0.404 V	ADC_A0_raw: 2162	V_adc_a0: 0.405 V	ADC_A1_raw: 2142	V_adc_a1: 0.402 V
Position: 7	DAC_Bits: 289	V_set_dac: 0.353 V	V_set_pot: 0.354 V	ADC_A0_raw: 1893	V_adc_a0: 0.355 V	ADC_A1_raw: 1878	V_adc_a1: 0.352 V
Position: 6	DAC_Bits: 248	V_set_dac: 0.303 V	V_set_pot: 0.303 V	ADC_A0_raw: 1623	V_adc_a0: 0.304 V	ADC_A1_raw: 1610	V_adc_a1: 0.302 V
Position: 5	DAC_Bits: 206	V_set_dac: 0.252 V	V_set_pot: 0.253 V	ADC_A0_raw: 1349	V_adc_a0: 0.253 V	ADC_A1_raw: 1339	V_adc_a1: 0.251 V
Position: 4	DAC_Bits: 165	V_set_dac: 0.201 V	V_set_pot: 0.202 V	ADC_A0_raw: 1079	V_adc_a0: 0.202 V	ADC_A1_raw: 1070	V_adc_a1: 0.201 V
Position: 3	DAC_Bits: 124	V_set_dac: 0.151 V	V_set_pot: 0.152 V	ADC_A0_raw: 808	V_adc_a0: 0.152 V	ADC_A1_raw: 798	V_adc_a1: 0.150 V
Position: 2	DAC_Bits: 82	V_set_dac: 0.100 V	V_set_pot: 0.101 V	ADC_A0_raw: 536	V_adc_a0: 0.101 V	ADC_A1_raw: 527	V_adc_a1: 0.099 V
Position: 1	DAC_Bits: 41	V_set_dac: 0.050 V	V_set_pot: 0.051 V	ADC_A0_raw: 264	V_adc_a0: 0.049 V	ADC_A1_raw: 262	V_adc_a1: 0.049 V
Position: 0	DAC_Bits: 0	V_set_dac: 0.000 V	V_set_pot: 0.000 V	ADC_A0_raw: -6	V_adc_a0: -0.001 V	ADC_A1_raw: 0	V_adc_a1: 0.000 V
Position: 0	DAC_Bits: 0	V_set_dac: 0.000 V	V_set_pot: 0.000 V	ADC_A0_raw: -7	V_adc_a0: -0.001 V	ADC_A1_raw: -1	V_adc_a1: -0.000 V
Position: 1	DAC_Bits: 41	V_set_dac: 0.050 V	V_set_pot: 0.051 V	ADC_A0_raw: 263	V_adc_a0: 0.049 V	ADC_A1_raw: 262	V_adc_a1: 0.049 V
Position: 2	DAC_Bits: 82	V_set_dac: 0.100 V	V_set_pot: 0.101 V	ADC_A0_raw: 535	V_adc_a0: 0.100 V	ADC_A1_raw: 527	V_adc_a1: 0.099 V
Position: 3	DAC_Bits: 124	V_set_dac: 0.151 V	V_set_pot: 0.152 V	ADC_A0_raw: 808	V_adc_a0: 0.152 V	ADC_A1_raw: 798	V_adc_a1: 0.150 V
Position: 4	DAC_Bits: 165	V_set_dac: 0.201 V	V_set_pot: 0.202 V	ADC_A0_raw: 1079	V_adc_a0: 0.202 V	ADC_A1_raw: 1070	V_adc_a1: 0.201 V
Position: 5	DAC_Bits: 206	V_set_dac: 0.252 V	V_set_pot: 0.253 V	ADC_A0_raw: 1349	V_adc_a0: 0.253 V	ADC_A1_raw: 1339	V_adc_a1: 0.251 V
Position: 6	DAC_Bits: 248	V_set_dac: 0.303 V	V_set_pot: 0.303 V	ADC_A0_raw: 1621	V_adc_a0: 0.304 V	ADC_A1_raw: 1611	V_adc_a1: 0.302 V
Position: 7	DAC_Bits: 289	V_set_dac: 0.353 V	V_set_pot: 0.354 V	ADC_A0_raw: 1893	V_adc_a0: 0.355 V	ADC_A1_raw: 1878	V_adc_a1: 0.352 V
Position: 8	DAC_Bits: 330	V_set_dac: 0.403 V	V_set_pot: 0.404 V	ADC_A0_raw: 2165	V_adc_a0: 0.406 V	ADC_A1_raw: 2143	V_adc_a1: 0.402 V
Position: 9	DAC_Bits: 372	V_set_dac: 0.454 V	V_set_pot: 0.455 V	ADC_A0_raw: 2433	V_adc_a0: 0.456 V	ADC_A1_raw: 2413	V_adc_a1: 0.452 V
Position: 10	DAC_Bits: 413	V_set_dac: 0.504 V	V_set_pot: 0.505 V	ADC_A0_raw: 2704	V_adc_a0: 0.507 V	ADC_A1_raw: 2677	V_adc_a1: 0.502 V
Position: 11	DAC_Bits: 455	V_set_dac: 0.556 V	V_set_pot: 0.556 V	ADC_A0_raw: 2975	V_adc_a0: 0.558 V	ADC_A1_raw: 2948	V_adc_a1: 0.553 V
Position: 12	DAC_Bits: 496	V_set_dac: 0.606 V	V_set_pot: 0.606 V	ADC_A0_raw: 3247	V_adc_a0: 0.609 V	ADC_A1_raw: 3221	V_adc_a1: 0.604 V
Position: 13	DAC_Bits: 537	V_set_dac: 0.656 V	V_set_pot: 0.657 V	ADC_A0_raw: 3513	V_adc_a0: 0.659 V	ADC_A1_raw: 3490	V_adc_a1: 0.654 V
Position: 14	DAC_Bits: 579	V_set_dac: 0.707 V	V_set_pot: 0.707 V	ADC_A0_raw: 3785	V_adc_a0: 0.710 V	ADC_A1_raw: 3763	V_adc_a1: 0.706 V
Position: 15	DAC_Bits: 620	V_set_dac: 0.757 V	V_set_pot: 0.758 V	ADC_A0_raw: 4058	V_adc_a0: 0.761 V	ADC_A1_raw: 4030	V_adc_a1: 0.756 V
Position: 16	DAC_Bits: 661	V_set_dac: 0.807 V	V_set_pot: 0.808 V	ADC_A0_raw: 4330	V_adc_a0: 0.812 V	ADC_A1_raw: 4294	V_adc_a1: 0.805 V
Position: 17	DAC_Bits: 703	V_set_dac: 0.858 V	V_set_pot: 0.859 V	ADC_A0_raw: 4599	V_adc_a0: 0.862 V	ADC_A1_raw: 4564	V_adc_a1: 0.856 V
Position: 18	DAC_Bits: 744	V_set_dac: 0.908 V	V_set_pot: 0.909 V	ADC_A0_raw: 4869	V_adc_a0: 0.913 V	ADC_A1_raw: 4829	V_adc_a1: 0.905 V
Position: 19	DAC_Bits: 785	V_set_dac: 0.958 V	V_set_pot: 0.960 V	ADC_A0_raw: 5146	V_adc_a0: 0.965 V	ADC_A1_raw: 5095	V_adc_a1: 0.955 V
Position: 20	DAC_Bits: 827	V_set_dac: 1.010 V	V_set_pot: 1.010 V	ADC_A0_raw: 5414	V_adc_a0: 1.015 V	ADC_A1_raw: 5368	V_adc_a1: 1.007 V
Position: 21	DAC_Bits: 868	V_set_dac: 1.060 V	V_set_pot: 1.061 V	ADC_A0_raw: 5682	V_adc_a0: 1.065 V	ADC_A1_raw: 5637	V_adc_a1: 1.057 V
Position: 22	DAC_Bits: 910	V_set_dac: 1.111 V	V_set_pot: 1.111 V	ADC_A0_raw: 5957	V_adc_a0: 1.117 V	ADC_A1_raw: 5913	V_adc_a1: 1.109 V
Position: 23	DAC_Bits: 951	V_set_dac: 1.161 V	V_set_pot: 1.162 V	ADC_A0_raw: 6228	V_adc_a0: 1.168 V	ADC_A1_raw: 6176	V_adc_a1: 1.158 V
Position: 24	DAC_Bits: 992	V_set_dac: 1.211 V	V_set_pot: 1.212 V	ADC_A0_raw: 6498	V_adc_a0: 1.218 V	ADC_A1_raw: 6449	V_adc_a1: 1.209 V
Position: 25	DAC_Bits: 1034	V_set_dac: 1.263 V	V_set_pot: 1.263 V	ADC_A0_raw: 6769	V_adc_a0: 1.269 V	ADC_A1_raw: 6731	V_adc_a1: 1.262 V
Position: 26	DAC_Bits: 1075	V_set_dac: 1.313 V	V_set_pot: 1.313 V	ADC_A0_raw: 7035	V_adc_a0: 1.319 V	ADC_A1_raw: 7000	V_adc_a1: 1.312 V
Position: 27	DAC_Bits: 1116	V_set_dac: 1.363 V	V_set_pot: 1.364 V	ADC_A0_raw: 7305	V_adc_a0: 1.370 V	ADC_A1_raw: 7268	V_adc_a1: 1.363 V
Position: 28	DAC_Bits: 1158	V_set_dac: 1.414 V	V_set_pot: 1.414 V	ADC_A0_raw: 7580	V_adc_a0: 1.421 V	ADC_A1_raw: 7540	V_adc_a1: 1.414 V
Position: 29	DAC_Bits: 1199	V_set_dac: 1.464 V	V_set_pot: 1.465 V	ADC_A0_raw: 7854	V_adc_a0: 1.473 V	ADC_A1_raw: 7806	V_adc_a1: 1.464 V
Position: 30	DAC_Bits: 1240	V_set_dac: 1.514 V	V_set_pot: 1.515 V	ADC_A0_raw: 8120	V_adc_a0: 1.523 V	ADC_A1_raw: 8070	V_adc_a1: 1.513 V
Position: 31	DAC_Bits: 1282	V_set_dac: 1.565 V	V_set_pot: 1.566 V	ADC_A0_raw: 8391	V_adc_a0: 1.573 V	ADC_A1_raw: 8341	V_adc_a1: 1.564 V
Position: 32	DAC_Bits: 1323	V_set_dac: 1.615 V	V_set_pot: 1.616 V	ADC_A0_raw: 8664	V_adc_a0: 1.625 V	ADC_A1_raw: 8607	V_adc_a1: 1.614 V
Position: 33	DAC_Bits: 1365	V_set_dac: 1.667 V	V_set_pot: 1.667 V	ADC_A0_raw: 8932	V_adc_a0: 1.675 V	ADC_A1_raw: 8881	V_adc_a1: 1.665 V
Position: 34	DAC_Bits: 1406	V_set_dac: 1.717 V	V_set_pot: 1.717 V	ADC_A0_raw: 9207	V_adc_a0: 1.726 V	ADC_A1_raw: 9150	V_adc_a1: 1.716 V
Position: 35	DAC_Bits: 1447	V_set_dac: 1.767 V	V_set_pot: 1.768 V	ADC_A0_raw: 9481	V_adc_a0: 1.778 V	ADC_A1_raw: 9419	V_adc_a1: 1.766 V
Position: 36	DAC_Bits: 1489	V_set_dac: 1.818 V	V_set_pot: 1.818 V	ADC_A0_raw: 9749	V_adc_a0: 1.828 V	ADC_A1_raw: 9694	V_adc_a1: 1.818 V
Position: 37	DAC_Bits: 1530	V_set_dac: 1.868 V	V_set_pot: 1.869 V	ADC_A0_raw: 10019	V_adc_a0: 1.879 V	ADC_A1_raw: 9965	V_adc_a1: 1.868 V
Position: 38	DAC_Bits: 1571	V_set_dac: 1.918 V	V_set_pot: 1.919 V	ADC_A0_raw: 10291	V_adc_a0: 1.930 V	ADC_A1_raw: 10229	V_adc_a1: 1.918 V
Position: 39	DAC_Bits: 1613	V_set_dac: 1.969 V	V_set_pot: 1.970 V	ADC_A0_raw: 10558	V_adc_a0: 1.980 V	ADC_A1_raw: 10498	V_adc_a1: 1.968 V
Position: 40	DAC_Bits: 1654	V_set_dac: 2.020 V	V_set_pot: 2.020 V	ADC_A0_raw: 10830	V_adc_a0: 2.031 V	ADC_A1_raw: 10761	V_adc_a1: 2.018 V
Position: 41	DAC_Bits: 1695	V_set_dac: 2.070 V	V_set_pot: 2.071 V	ADC_A0_raw: 11093	V_adc_a0: 2.080 V	ADC_A1_raw: 11026	V_adc_a1: 2.067 V
Position: 42	DAC_Bits: 1737	V_set_dac: 2.121 V	V_set_pot: 2.121 V	ADC_A0_raw: 11368	V_adc_a0: 2.132 V	ADC_A1_raw: 11302	V_adc_a1: 2.119 V
Position: 43	DAC_Bits: 1778	V_set_dac: 2.171 V	V_set_pot: 2.172 V	ADC_A0_raw: 11640	V_adc_a0: 2.183 V	ADC_A1_raw: 11566	V_adc_a1: 2.169 V
Position: 44	DAC_Bits: 1820	V_set_dac: 2.222 V	V_set_pot: 2.222 V	ADC_A0_raw: 11913	V_adc_a0: 2.234 V	ADC_A1_raw: 11840	V_adc_a1: 2.220 V
Position: 45	DAC_Bits: 1861	V_set_dac: 2.272 V	V_set_pot: 2.273 V	ADC_A0_raw: 12184	V_adc_a0: 2.285 V	ADC_A1_raw: 12109	V_adc_a1: 2.270 V
Position: 46	DAC_Bits: 1902	V_set_dac: 2.322 V	V_set_pot: 2.323 V	ADC_A0_raw: 12451	V_adc_a0: 2.335 V	ADC_A1_raw: 12375	V_adc_a1: 2.320 V
Position: 47	DAC_Bits: 1944	V_set_dac: 2.374 V	V_set_pot: 2.374 V	ADC_A0_raw: 12727	V_adc_a0: 2.386 V	ADC_A1_raw: 12649	V_adc_a1: 2.372 V
Position: 48	DAC_Bits: 1985	V_set_dac: 2.424 V	V_set_pot: 2.424 V	ADC_A0_raw: 12994	V_adc_a0: 2.436 V	ADC_A1_raw: 12913	V_adc_a1: 2.421 V
Position: 49	DAC_Bits: 2026	V_set_dac: 2.474 V	V_set_pot: 2.475 V	ADC_A0_raw: 13266	V_adc_a0: 2.487 V	ADC_A1_raw: 13186	V_adc_a1: 2.472 V
Position: 50	DAC_Bits: 2068	V_set_dac: 2.525 V	V_set_pot: 2.525 V	ADC_A0_raw: 13538	V_adc_a0: 2.538 V	ADC_A1_raw: 13465	V_adc_a1: 2.525 V
Position: 51	DAC_Bits: 2109	V_set_dac: 2.575 V	V_set_pot: 2.576 V	ADC_A0_raw: 13810	V_adc_a0: 2.589 V	ADC_A1_raw: 13733	V_adc_a1: 2.575 V
Position: 52	DAC_Bits: 2150	V_set_dac: 2.625 V	V_set_pot: 2.626 V	ADC_A0_raw: 14082	V_adc_a0: 2.640 V	ADC_A1_raw: 14006	V_adc_a1: 2.626 V
Position: 53	DAC_Bits: 2192	V_set_dac: 2.676 V	V_set_pot: 2.677 V	ADC_A0_raw: 14351	V_adc_a0: 2.691 V	ADC_A1_raw: 14282	V_adc_a1: 2.678 V
Position: 54	DAC_Bits: 2233	V_set_dac: 2.726 V	V_set_pot: 2.727 V	ADC_A0_raw: 14630	V_adc_a0: 2.743 V	ADC_A1_raw: 14546	V_adc_a1: 2.727 V
Position: 55	DAC_Bits: 2275	V_set_dac: 2.778 V	V_set_pot: 2.778 V	ADC_A0_raw: 14899	V_adc_a0: 2.794 V	ADC_A1_raw: 14821	V_adc_a1: 2.779 V
Position: 56	DAC_Bits: 2316	V_set_dac: 2.828 V	V_set_pot: 2.828 V	ADC_A0_raw: 15169	V_adc_a0: 2.844 V	ADC_A1_raw: 15090	V_adc_a1: 2.829 V
Position: 57	DAC_Bits: 2357	V_set_dac: 2.878 V	V_set_pot: 2.879 V	ADC_A0_raw: 15441	V_adc_a0: 2.895 V	ADC_A1_raw: 15359	V_adc_a1: 2.880 V
Position: 58	DAC_Bits: 2399	V_set_dac: 2.929 V	V_set_pot: 2.929 V	ADC_A0_raw: 15718	V_adc_a0: 2.947 V	ADC_A1_raw: 15632	V_adc_a1: 2.931 V
Position: 59	DAC_Bits: 2440	V_set_dac: 2.979 V	V_set_pot: 2.980 V	ADC_A0_raw: 15984	V_adc_a0: 2.997 V	ADC_A1_raw: 15901	V_adc_a1: 2.981 V
Position: 60	DAC_Bits: 2481	V_set_dac: 3.029 V	V_set_pot: 3.030 V	ADC_A0_raw: 16256	V_adc_a0: 3.048 V	ADC_A1_raw: 16173	V_adc_a1: 3.032 V
Position: 61	DAC_Bits: 2523	V_set_dac: 3.081 V	V_set_pot: 3.081 V	ADC_A0_raw: 16532	V_adc_a0: 3.100 V	ADC_A1_raw: 16451	V_adc_a1: 3.085 V
Position: 62	DAC_Bits: 2564	V_set_dac: 3.131 V	V_set_pot: 3.131 V	ADC_A0_raw: 16801	V_adc_a0: 3.150 V	ADC_A1_raw: 16730	V_adc_a1: 3.137 V
Position: 63	DAC_Bits: 2605	V_set_dac: 3.181 V	V_set_pot: 3.182 V	ADC_A0_raw: 17071	V_adc_a0: 3.201 V	ADC_A1_raw: 16998	V_adc_a1: 3.187 V
Position: 64	DAC_Bits: 2647	V_set_dac: 3.232 V	V_set_pot: 3.232 V	ADC_A0_raw: 17345	V_adc_a0: 3.252 V	ADC_A1_raw: 17273	V_adc_a1: 3.239 V
Position: 65	DAC_Bits: 2688	V_set_dac: 3.282 V	V_set_pot: 3.283 V	ADC_A0_raw: 17615	V_adc_a0: 3.303 V	ADC_A1_raw: 17542	V_adc_a1: 3.289 V
Position: 66	DAC_Bits: 2730	V_set_dac: 3.333 V	V_set_pot: 3.333 V	ADC_A0_raw: 17888	V_adc_a0: 3.354 V	ADC_A1_raw: 17818	V_adc_a1: 3.341 V
Position: 67	DAC_Bits: 2771	V_set_dac: 3.383 V	V_set_pot: 3.384 V	ADC_A0_raw: 18161	V_adc_a0: 3.405 V	ADC_A1_raw: 18088	V_adc_a1: 3.391 V
Position: 68	DAC_Bits: 2812	V_set_dac: 3.433 V	V_set_pot: 3.434 V	ADC_A0_raw: 18432	V_adc_a0: 3.456 V	ADC_A1_raw: 18356	V_adc_a1: 3.442 V
Position: 69	DAC_Bits: 2854	V_set_dac: 3.485 V	V_set_pot: 3.485 V	ADC_A0_raw: 18705	V_adc_a0: 3.507 V	ADC_A1_raw: 18626	V_adc_a1: 3.492 V
Position: 70	DAC_Bits: 2895	V_set_dac: 3.535 V	V_set_pot: 3.535 V	ADC_A0_raw: 18971	V_adc_a0: 3.557 V	ADC_A1_raw: 18890	V_adc_a1: 3.542 V
Position: 71	DAC_Bits: 2936	V_set_dac: 3.585 V	V_set_pot: 3.586 V	ADC_A0_raw: 19246	V_adc_a0: 3.609 V	ADC_A1_raw: 19155	V_adc_a1: 3.592 V
Position: 72	DAC_Bits: 2978	V_set_dac: 3.636 V	V_set_pot: 3.636 V	ADC_A0_raw: 19512	V_adc_a0: 3.658 V	ADC_A1_raw: 19429	V_adc_a1: 3.643 V
Position: 73	DAC_Bits: 3019	V_set_dac: 3.686 V	V_set_pot: 3.687 V	ADC_A0_raw: 19765	V_adc_a0: 3.706 V	ADC_A1_raw: 19690	V_adc_a1: 3.692 V
Position: 74	DAC_Bits: 3060	V_set_dac: 3.736 V	V_set_pot: 3.737 V	ADC_A0_raw: 19975	V_adc_a0: 3.745 V	ADC_A1_raw: 19934	V_adc_a1: 3.738 V
Position: 75	DAC_Bits: 3102	V_set_dac: 3.788 V	V_set_pot: 3.788 V	ADC_A0_raw: 20113	V_adc_a0: 3.771 V	ADC_A1_raw: 20122	V_adc_a1: 3.773 V
Position: 76	DAC_Bits: 3143	V_set_dac: 3.838 V	V_set_pot: 3.838 V	ADC_A0_raw: 20188	V_adc_a0: 3.785 V	ADC_A1_raw: 20222	V_adc_a1: 3.792 V
Position: 77	DAC_Bits: 3185	V_set_dac: 3.889 V	V_set_pot: 3.889 V	ADC_A0_raw: 20230	V_adc_a0: 3.793 V	ADC_A1_raw: 20270	V_adc_a1: 3.801 V
Position: 78	DAC_Bits: 3226	V_set_dac: 3.939 V	V_set_pot: 3.939 V	ADC_A0_raw: 20250	V_adc_a0: 3.797 V	ADC_A1_raw: 20250	V_adc_a1: 3.797 V
Position: 79	DAC_Bits: 3267	V_set_dac: 3.989 V	V_set_pot: 3.990 V	ADC_A0_raw: 20230	V_adc_a0: 3.793 V	ADC_A1_raw: 20230	V_adc_a1: 3.793 V
Position: 80	DAC_Bits: 3309	V_set_dac: 4.040 V	V_set_pot: 4.040 V	ADC_A0_raw: 20189	V_adc_a0: 3.785 V	ADC_A1_raw: 20149	V_adc_a1: 3.778 V
Position: 81	DAC_Bits: 3350	V_set_dac: 4.090 V	V_set_pot: 4.091 V	ADC_A0_raw: 20169	V_adc_a0: 3.782 V	ADC_A1_raw: 20108	V_adc_a1: 3.770 V
Position: 82	DAC_Bits: 3391	V_set_dac: 4.140 V	V_set_pot: 4.141 V	ADC_A0_raw: 20149	V_adc_a0: 3.778 V	ADC_A1_raw: 20027	V_adc_a1: 3.755 V
Position: 83	DAC_Bits: 3433	V_set_dac: 4.192 V	V_set_pot: 4.192 V	ADC_A0_raw: 20149	V_adc_a0: 3.778 V	ADC_A1_raw: 19967	V_adc_a1: 3.744 V
Position: 84	DAC_Bits: 3474	V_set_dac: 4.242 V	V_set_pot: 4.242 V	ADC_A0_raw: 20149	V_adc_a0: 3.778 V	ADC_A1_raw: 19946	V_adc_a1: 3.740 V
Position: 85	DAC_Bits: 3515	V_set_dac: 4.292 V	V_set_pot: 4.293 V	ADC_A0_raw: 20129	V_adc_a0: 3.774 V	ADC_A1_raw: 19946	V_adc_a1: 3.740 V
Position: 86	DAC_Bits: 3557	V_set_dac: 4.343 V	V_set_pot: 4.343 V	ADC_A0_raw: 20108	V_adc_a0: 3.770 V	ADC_A1_raw: 19946	V_adc_a1: 3.740 V
Position: 87	DAC_Bits: 3598	V_set_dac: 4.393 V	V_set_pot: 4.394 V	ADC_A0_raw: 20088	V_adc_a0: 3.766 V	ADC_A1_raw: 19926	V_adc_a1: 3.736 V
Position: 88	DAC_Bits: 3640	V_set_dac: 4.444 V	V_set_pot: 4.444 V	ADC_A0_raw: 20088	V_adc_a0: 3.766 V	ADC_A1_raw: 19926	V_adc_a1: 3.736 V
Position: 89	DAC_Bits: 3681	V_set_dac: 4.495 V	V_set_pot: 4.495 V	ADC_A0_raw: 20088	V_adc_a0: 3.766 V	ADC_A1_raw: 19906	V_adc_a1: 3.732 V
Position: 90	DAC_Bits: 3722	V_set_dac: 4.545 V	V_set_pot: 4.545 V	ADC_A0_raw: 20088	V_adc_a0: 3.766 V	ADC_A1_raw: 19906	V_adc_a1: 3.732 V
Position: 91	DAC_Bits: 3764	V_set_dac: 4.596 V	V_set_pot: 4.596 V	ADC_A0_raw: 20048	V_adc_a0: 3.759 V	ADC_A1_raw: 19886	V_adc_a1: 3.729 V
Position: 92	DAC_Bits: 3805	V_set_dac: 4.646 V	V_set_pot: 4.646 V	ADC_A0_raw: 20027	V_adc_a0: 3.755 V	ADC_A1_raw: 19865	V_adc_a1: 3.725 V
Position: 93	DAC_Bits: 3846	V_set_dac: 4.696 V	V_set_pot: 4.697 V	ADC_A0_raw: 19987	V_adc_a0: 3.748 V	ADC_A1_raw: 19865	V_adc_a1: 3.725 V
Position: 94	DAC_Bits: 3888	V_set_dac: 4.747 V	V_set_pot: 4.747 V	ADC_A0_raw: 19967	V_adc_a0: 3.744 V	ADC_A1_raw: 19865	V_adc_a1: 3.725 V
Position: 95	DAC_Bits: 3929	V_set_dac: 4.797 V	V_set_pot: 4.798 V	ADC_A0_raw: 19946	V_adc_a0: 3.740 V	ADC_A1_raw: 19845	V_adc_a1: 3.721 V
Position: 96	DAC_Bits: 3970	V_set_dac: 4.847 V	V_set_pot: 4.848 V	ADC_A0_raw: 19926	V_adc_a0: 3.736 V	ADC_A1_raw: 19825	V_adc_a1: 3.717 V
Position: 97	DAC_Bits: 4012	V_set_dac: 4.899 V	V_set_pot: 4.899 V	ADC_A0_raw: 19886	V_adc_a0: 3.729 V	ADC_A1_raw: 19825	V_adc_a1: 3.717 V
Position: 98	DAC_Bits: 4053	V_set_dac: 4.949 V	V_set_pot: 4.949 V	ADC_A0_raw: 19805	V_adc_a0: 3.713 V	ADC_A1_raw: 19764	V_adc_a1: 3.706 V
Position: 99	DAC_Bits: 4095	V_set_dac: 5.000 V	V_set_pot: 5.000 V	ADC_A0_raw: 19521	V_adc_a0: 3.660 V	ADC_A1_raw: 19724	V_adc_a1: 3.698 V
Position: 99	DAC_Bits: 4095	V_set_dac: 5.000 V	V_set_pot: 5.000 V	ADC_A0_raw: 19582	V_adc_a0: 3.672 V	ADC_A1_raw: 19703	V_adc_a1: 3.694 V
Position: 98	DAC_Bits: 4053	V_set_dac: 4.949 V	V_set_pot: 4.949 V	ADC_A0_raw: 19805	V_adc_a0: 3.713 V	ADC_A1_raw: 19784	V_adc_a1: 3.710 V
Position: 97	DAC_Bits: 4012	V_set_dac: 4.899 V	V_set_pot: 4.899 V	ADC_A0_raw: 19865	V_adc_a0: 3.725 V	ADC_A1_raw: 19784	V_adc_a1: 3.710 V
Position: 96	DAC_Bits: 3970	V_set_dac: 4.847 V	V_set_pot: 4.848 V	ADC_A0_raw: 19886	V_adc_a0: 3.729 V	ADC_A1_raw: 19825	V_adc_a1: 3.717 V
Position: 95	DAC_Bits: 3929	V_set_dac: 4.797 V	V_set_pot: 4.798 V	ADC_A0_raw: 19926	V_adc_a0: 3.736 V	ADC_A1_raw: 19845	V_adc_a1: 3.721 V
Position: 94	DAC_Bits: 3888	V_set_dac: 4.747 V	V_set_pot: 4.747 V	ADC_A0_raw: 19967	V_adc_a0: 3.744 V	ADC_A1_raw: 19845	V_adc_a1: 3.721 V
Position: 93	DAC_Bits: 3846	V_set_dac: 4.696 V	V_set_pot: 4.697 V	ADC_A0_raw: 19987	V_adc_a0: 3.748 V	ADC_A1_raw: 19845	V_adc_a1: 3.721 V
Position: 92	DAC_Bits: 3805	V_set_dac: 4.646 V	V_set_pot: 4.646 V	ADC_A0_raw: 20007	V_adc_a0: 3.751 V	ADC_A1_raw: 19865	V_adc_a1: 3.725 V
Position: 91	DAC_Bits: 3764	V_set_dac: 4.596 V	V_set_pot: 4.596 V	ADC_A0_raw: 20048	V_adc_a0: 3.759 V	ADC_A1_raw: 19886	V_adc_a1: 3.729 V
Position: 90	DAC_Bits: 3722	V_set_dac: 4.545 V	V_set_pot: 4.545 V	ADC_A0_raw: 20088	V_adc_a0: 3.766 V	ADC_A1_raw: 19886	V_adc_a1: 3.729 V
Position: 89	DAC_Bits: 3681	V_set_dac: 4.495 V	V_set_pot: 4.495 V	ADC_A0_raw: 20088	V_adc_a0: 3.766 V	ADC_A1_raw: 19906	V_adc_a1: 3.732 V
Position: 88	DAC_Bits: 3640	V_set_dac: 4.444 V	V_set_pot: 4.444 V	ADC_A0_raw: 20088	V_adc_a0: 3.766 V	ADC_A1_raw: 19906	V_adc_a1: 3.732 V
Position: 87	DAC_Bits: 3598	V_set_dac: 4.393 V	V_set_pot: 4.394 V	ADC_A0_raw: 20068	V_adc_a0: 3.763 V	ADC_A1_raw: 19926	V_adc_a1: 3.736 V
Position: 86	DAC_Bits: 3557	V_set_dac: 4.343 V	V_set_pot: 4.343 V	ADC_A0_raw: 20068	V_adc_a0: 3.763 V	ADC_A1_raw: 19926	V_adc_a1: 3.736 V
Position: 85	DAC_Bits: 3515	V_set_dac: 4.292 V	V_set_pot: 4.293 V	ADC_A0_raw: 20088	V_adc_a0: 3.766 V	ADC_A1_raw: 19946	V_adc_a1: 3.740 V
Position: 84	DAC_Bits: 3474	V_set_dac: 4.242 V	V_set_pot: 4.242 V	ADC_A0_raw: 20108	V_adc_a0: 3.770 V	ADC_A1_raw: 19946	V_adc_a1: 3.740 V
Position: 83	DAC_Bits: 3433	V_set_dac: 4.192 V	V_set_pot: 4.192 V	ADC_A0_raw: 20129	V_adc_a0: 3.774 V	ADC_A1_raw: 19967	V_adc_a1: 3.744 V
Position: 82	DAC_Bits: 3391	V_set_dac: 4.140 V	V_set_pot: 4.141 V	ADC_A0_raw: 20129	V_adc_a0: 3.774 V	ADC_A1_raw: 19987	V_adc_a1: 3.748 V
Position: 81	DAC_Bits: 3350	V_set_dac: 4.090 V	V_set_pot: 4.091 V	ADC_A0_raw: 20129	V_adc_a0: 3.774 V	ADC_A1_raw: 20088	V_adc_a1: 3.766 V
Position: 80	DAC_Bits: 3309	V_set_dac: 4.040 V	V_set_pot: 4.040 V	ADC_A0_raw: 20189	V_adc_a0: 3.785 V	ADC_A1_raw: 20129	V_adc_a1: 3.774 V
Position: 79	DAC_Bits: 3267	V_set_dac: 3.989 V	V_set_pot: 3.990 V	ADC_A0_raw: 20210	V_adc_a0: 3.789 V	ADC_A1_raw: 20189	V_adc_a1: 3.785 V
Position: 78	DAC_Bits: 3226	V_set_dac: 3.939 V	V_set_pot: 3.939 V	ADC_A0_raw: 20210	V_adc_a0: 3.789 V	ADC_A1_raw: 20230	V_adc_a1: 3.793 V
Position: 77	DAC_Bits: 3185	V_set_dac: 3.889 V	V_set_pot: 3.889 V	ADC_A0_raw: 20210	V_adc_a0: 3.789 V	ADC_A1_raw: 20230	V_adc_a1: 3.793 V
Position: 76	DAC_Bits: 3143	V_set_dac: 3.838 V	V_set_pot: 3.838 V	ADC_A0_raw: 20172	V_adc_a0: 3.782 V	ADC_A1_raw: 20206	V_adc_a1: 3.789 V
Position: 75	DAC_Bits: 3102	V_set_dac: 3.788 V	V_set_pot: 3.788 V	ADC_A0_raw: 20101	V_adc_a0: 3.769 V	ADC_A1_raw: 20114	V_adc_a1: 3.771 V
Position: 74	DAC_Bits: 3060	V_set_dac: 3.736 V	V_set_pot: 3.737 V	ADC_A0_raw: 19966	V_adc_a0: 3.744 V	ADC_A1_raw: 19931	V_adc_a1: 3.737 V
Position: 73	DAC_Bits: 3019	V_set_dac: 3.686 V	V_set_pot: 3.687 V	ADC_A0_raw: 19764	V_adc_a0: 3.706 V	ADC_A1_raw: 19691	V_adc_a1: 3.692 V
Position: 72	DAC_Bits: 2978	V_set_dac: 3.636 V	V_set_pot: 3.636 V	ADC_A0_raw: 19511	V_adc_a0: 3.658 V	ADC_A1_raw: 19429	V_adc_a1: 3.643 V
Position: 71	DAC_Bits: 2936	V_set_dac: 3.585 V	V_set_pot: 3.586 V	ADC_A0_raw: 19245	V_adc_a0: 3.608 V	ADC_A1_raw: 19156	V_adc_a1: 3.592 V
Position: 70	DAC_Bits: 2895	V_set_dac: 3.535 V	V_set_pot: 3.535 V	ADC_A0_raw: 18971	V_adc_a0: 3.557 V	ADC_A1_raw: 18891	V_adc_a1: 3.542 V
Position: 69	DAC_Bits: 2854	V_set_dac: 3.485 V	V_set_pot: 3.485 V	ADC_A0_raw: 18700	V_adc_a0: 3.506 V	ADC_A1_raw: 18626	V_adc_a1: 3.492 V
Position: 68	DAC_Bits: 2812	V_set_dac: 3.433 V	V_set_pot: 3.434 V	ADC_A0_raw: 18429	V_adc_a0: 3.455 V	ADC_A1_raw: 18354	V_adc_a1: 3.441 V
Position: 67	DAC_Bits: 2771	V_set_dac: 3.383 V	V_set_pot: 3.384 V	ADC_A0_raw: 18156	V_adc_a0: 3.404 V	ADC_A1_raw: 18086	V_adc_a1: 3.391 V
Position: 66	DAC_Bits: 2730	V_set_dac: 3.333 V	V_set_pot: 3.333 V	ADC_A0_raw: 17889	V_adc_a0: 3.354 V	ADC_A1_raw: 17819	V_adc_a1: 3.341 V
Position: 65	DAC_Bits: 2688	V_set_dac: 3.282 V	V_set_pot: 3.283 V	ADC_A0_raw: 17614	V_adc_a0: 3.303 V	ADC_A1_raw: 17542	V_adc_a1: 3.289 V
Position: 64	DAC_Bits: 2647	V_set_dac: 3.232 V	V_set_pot: 3.232 V	ADC_A0_raw: 17343	V_adc_a0: 3.252 V	ADC_A1_raw: 17272	V_adc_a1: 3.239 V
Position: 63	DAC_Bits: 2605	V_set_dac: 3.181 V	V_set_pot: 3.182 V	ADC_A0_raw: 17072	V_adc_a0: 3.201 V	ADC_A1_raw: 16998	V_adc_a1: 3.187 V
Position: 62	DAC_Bits: 2564	V_set_dac: 3.131 V	V_set_pot: 3.131 V	ADC_A0_raw: 16800	V_adc_a0: 3.150 V	ADC_A1_raw: 16729	V_adc_a1: 3.137 V
Position: 61	DAC_Bits: 2523	V_set_dac: 3.081 V	V_set_pot: 3.081 V	ADC_A0_raw: 16532	V_adc_a0: 3.100 V	ADC_A1_raw: 16455	V_adc_a1: 3.085 V
Position: 60	DAC_Bits: 2481	V_set_dac: 3.029 V	V_set_pot: 3.030 V	ADC_A0_raw: 16259	V_adc_a0: 3.049 V	ADC_A1_raw: 16171	V_adc_a1: 3.032 V
Position: 59	DAC_Bits: 2440	V_set_dac: 2.979 V	V_set_pot: 2.980 V	ADC_A0_raw: 15989	V_adc_a0: 2.998 V	ADC_A1_raw: 15900	V_adc_a1: 2.981 V
Position: 58	DAC_Bits: 2399	V_set_dac: 2.929 V	V_set_pot: 2.929 V	ADC_A0_raw: 15715	V_adc_a0: 2.947 V	ADC_A1_raw: 15631	V_adc_a1: 2.931 V
Position: 57	DAC_Bits: 2357	V_set_dac: 2.878 V	V_set_pot: 2.879 V	ADC_A0_raw: 15443	V_adc_a0: 2.896 V	ADC_A1_raw: 15358	V_adc_a1: 2.880 V
Position: 56	DAC_Bits: 2316	V_set_dac: 2.828 V	V_set_pot: 2.828 V	ADC_A0_raw: 15167	V_adc_a0: 2.844 V	ADC_A1_raw: 15091	V_adc_a1: 2.830 V
Position: 55	DAC_Bits: 2275	V_set_dac: 2.778 V	V_set_pot: 2.778 V	ADC_A0_raw: 14896	V_adc_a0: 2.793 V	ADC_A1_raw: 14821	V_adc_a1: 2.779 V
Position: 54	DAC_Bits: 2233	V_set_dac: 2.726 V	V_set_pot: 2.727 V	ADC_A0_raw: 14628	V_adc_a0: 2.743 V	ADC_A1_raw: 14546	V_adc_a1: 2.727 V
Position: 53	DAC_Bits: 2192	V_set_dac: 2.676 V	V_set_pot: 2.677 V	ADC_A0_raw: 14355	V_adc_a0: 2.692 V	ADC_A1_raw: 14283	V_adc_a1: 2.678 V
Position: 52	DAC_Bits: 2150	V_set_dac: 2.625 V	V_set_pot: 2.626 V	ADC_A0_raw: 14081	V_adc_a0: 2.640 V	ADC_A1_raw: 14006	V_adc_a1: 2.626 V
Position: 51	DAC_Bits: 2109	V_set_dac: 2.575 V	V_set_pot: 2.576 V	ADC_A0_raw: 13811	V_adc_a0: 2.590 V	ADC_A1_raw: 13734	V_adc_a1: 2.575 V
Position: 50	DAC_Bits: 2068	V_set_dac: 2.525 V	V_set_pot: 2.525 V	ADC_A0_raw: 13537	V_adc_a0: 2.538 V	ADC_A1_raw: 13464	V_adc_a1: 2.525 V
Position: 49	DAC_Bits: 2026	V_set_dac: 2.474 V	V_set_pot: 2.475 V	ADC_A0_raw: 13265	V_adc_a0: 2.487 V	ADC_A1_raw: 13185	V_adc_a1: 2.472 V
Position: 48	DAC_Bits: 1985	V_set_dac: 2.424 V	V_set_pot: 2.424 V	ADC_A0_raw: 12994	V_adc_a0: 2.436 V	ADC_A1_raw: 12912	V_adc_a1: 2.421 V
Position: 47	DAC_Bits: 1944	V_set_dac: 2.374 V	V_set_pot: 2.374 V	ADC_A0_raw: 12723	V_adc_a0: 2.386 V	ADC_A1_raw: 12647	V_adc_a1: 2.371 V
Position: 46	DAC_Bits: 1902	V_set_dac: 2.322 V	V_set_pot: 2.323 V	ADC_A0_raw: 12452	V_adc_a0: 2.335 V	ADC_A1_raw: 12376	V_adc_a1: 2.321 V
Position: 45	DAC_Bits: 1861	V_set_dac: 2.272 V	V_set_pot: 2.273 V	ADC_A0_raw: 12184	V_adc_a0: 2.285 V	ADC_A1_raw: 12109	V_adc_a1: 2.270 V
Position: 44	DAC_Bits: 1820	V_set_dac: 2.222 V	V_set_pot: 2.222 V	ADC_A0_raw: 11911	V_adc_a0: 2.233 V	ADC_A1_raw: 11839	V_adc_a1: 2.220 V
Position: 43	DAC_Bits: 1778	V_set_dac: 2.171 V	V_set_pot: 2.172 V	ADC_A0_raw: 11638	V_adc_a0: 2.182 V	ADC_A1_raw: 11565	V_adc_a1: 2.168 V
Position: 42	DAC_Bits: 1737	V_set_dac: 2.121 V	V_set_pot: 2.121 V	ADC_A0_raw: 11367	V_adc_a0: 2.131 V	ADC_A1_raw: 11301	V_adc_a1: 2.119 V
Position: 41	DAC_Bits: 1695	V_set_dac: 2.070 V	V_set_pot: 2.071 V	ADC_A0_raw: 11099	V_adc_a0: 2.081 V	ADC_A1_raw: 11027	V_adc_a1: 2.068 V
Position: 40	DAC_Bits: 1654	V_set_dac: 2.020 V	V_set_pot: 2.020 V	ADC_A0_raw: 10830	V_adc_a0: 2.031 V	ADC_A1_raw: 10760	V_adc_a1: 2.017 V
Position: 39	DAC_Bits: 1613	V_set_dac: 1.969 V	V_set_pot: 1.970 V	ADC_A0_raw: 10560	V_adc_a0: 1.980 V	ADC_A1_raw: 10498	V_adc_a1: 1.968 V
Position: 38	DAC_Bits: 1571	V_set_dac: 1.918 V	V_set_pot: 1.919 V	ADC_A0_raw: 10288	V_adc_a0: 1.929 V	ADC_A1_raw: 10230	V_adc_a1: 1.918 V
Position: 37	DAC_Bits: 1530	V_set_dac: 1.868 V	V_set_pot: 1.869 V	ADC_A0_raw: 10018	V_adc_a0: 1.878 V	ADC_A1_raw: 9964	V_adc_a1: 1.868 V
Position: 36	DAC_Bits: 1489	V_set_dac: 1.818 V	V_set_pot: 1.818 V	ADC_A0_raw: 9748	V_adc_a0: 1.828 V	ADC_A1_raw: 9695	V_adc_a1: 1.818 V
Position: 35	DAC_Bits: 1447	V_set_dac: 1.767 V	V_set_pot: 1.768 V	ADC_A0_raw: 9477	V_adc_a0: 1.777 V	ADC_A1_raw: 9418	V_adc_a1: 1.766 V
Position: 34	DAC_Bits: 1406	V_set_dac: 1.717 V	V_set_pot: 1.717 V	ADC_A0_raw: 9206	V_adc_a0: 1.726 V	ADC_A1_raw: 9151	V_adc_a1: 1.716 V
Position: 33	DAC_Bits: 1365	V_set_dac: 1.667 V	V_set_pot: 1.667 V	ADC_A0_raw: 8933	V_adc_a0: 1.675 V	ADC_A1_raw: 8882	V_adc_a1: 1.665 V
Position: 32	DAC_Bits: 1323	V_set_dac: 1.615 V	V_set_pot: 1.616 V	ADC_A0_raw: 8662	V_adc_a0: 1.624 V	ADC_A1_raw: 8607	V_adc_a1: 1.614 V
Position: 31	DAC_Bits: 1282	V_set_dac: 1.565 V	V_set_pot: 1.566 V	ADC_A0_raw: 8393	V_adc_a0: 1.574 V	ADC_A1_raw: 8343	V_adc_a1: 1.564 V
Position: 30	DAC_Bits: 1240	V_set_dac: 1.514 V	V_set_pot: 1.515 V	ADC_A0_raw: 8121	V_adc_a0: 1.523 V	ADC_A1_raw: 8071	V_adc_a1: 1.513 V
Position: 29	DAC_Bits: 1199	V_set_dac: 1.464 V	V_set_pot: 1.465 V	ADC_A0_raw: 7850	V_adc_a0: 1.472 V	ADC_A1_raw: 7807	V_adc_a1: 1.464 V
Position: 28	DAC_Bits: 1158	V_set_dac: 1.414 V	V_set_pot: 1.414 V	ADC_A0_raw: 7580	V_adc_a0: 1.421 V	ADC_A1_raw: 7541	V_adc_a1: 1.414 V
Position: 27	DAC_Bits: 1116	V_set_dac: 1.363 V	V_set_pot: 1.364 V	ADC_A0_raw: 7309	V_adc_a0: 1.370 V	ADC_A1_raw: 7267	V_adc_a1: 1.363 V
Position: 26	DAC_Bits: 1075	V_set_dac: 1.313 V	V_set_pot: 1.313 V	ADC_A0_raw: 7037	V_adc_a0: 1.319 V	ADC_A1_raw: 7000	V_adc_a1: 1.312 V
Position: 25	DAC_Bits: 1034	V_set_dac: 1.263 V	V_set_pot: 1.263 V	ADC_A0_raw: 6767	V_adc_a0: 1.269 V	ADC_A1_raw: 6731	V_adc_a1: 1.262 V
Position: 24	DAC_Bits: 992	V_set_dac: 1.211 V	V_set_pot: 1.212 V	ADC_A0_raw: 6497	V_adc_a0: 1.218 V	ADC_A1_raw: 6450	V_adc_a1: 1.209 V
Position: 23	DAC_Bits: 951	V_set_dac: 1.161 V	V_set_pot: 1.162 V	ADC_A0_raw: 6226	V_adc_a0: 1.167 V	ADC_A1_raw: 6176	V_adc_a1: 1.158 V
Position: 22	DAC_Bits: 910	V_set_dac: 1.111 V	V_set_pot: 1.111 V	ADC_A0_raw: 5952	V_adc_a0: 1.116 V	ADC_A1_raw: 5910	V_adc_a1: 1.108 V
Position: 21	DAC_Bits: 868	V_set_dac: 1.060 V	V_set_pot: 1.061 V	ADC_A0_raw: 5681	V_adc_a0: 1.065 V	ADC_A1_raw: 5635	V_adc_a1: 1.057 V
Position: 20	DAC_Bits: 827	V_set_dac: 1.010 V	V_set_pot: 1.010 V	ADC_A0_raw: 5411	V_adc_a0: 1.015 V	ADC_A1_raw: 5366	V_adc_a1: 1.006 V
Position: 19	DAC_Bits: 785	V_set_dac: 0.958 V	V_set_pot: 0.960 V	ADC_A0_raw: 5139	V_adc_a0: 0.964 V	ADC_A1_raw: 5092	V_adc_a1: 0.955 V
Position: 18	DAC_Bits: 744	V_set_dac: 0.908 V	V_set_pot: 0.909 V	ADC_A0_raw: 4869	V_adc_a0: 0.913 V	ADC_A1_raw: 4826	V_adc_a1: 0.905 V
Position: 17	DAC_Bits: 703	V_set_dac: 0.858 V	V_set_pot: 0.859 V	ADC_A0_raw: 4596	V_adc_a0: 0.862 V	ADC_A1_raw: 4561	V_adc_a1: 0.855 V
Position: 16	DAC_Bits: 661	V_set_dac: 0.807 V	V_set_pot: 0.808 V	ADC_A0_raw: 4325	V_adc_a0: 0.811 V	ADC_A1_raw: 4291	V_adc_a1: 0.805 V
Position: 15	DAC_Bits: 620	V_set_dac: 0.757 V	V_set_pot: 0.758 V	ADC_A0_raw: 4055	V_adc_a0: 0.760 V	ADC_A1_raw: 4027	V_adc_a1: 0.755 V
Position: 14	DAC_Bits: 579	V_set_dac: 0.707 V	V_set_pot: 0.707 V	ADC_A0_raw: 3783	V_adc_a0: 0.709 V	ADC_A1_raw: 3761	V_adc_a1: 0.705 V
Position: 13	DAC_Bits: 537	V_set_dac: 0.656 V	V_set_pot: 0.657 V	ADC_A0_raw: 3512	V_adc_a0: 0.659 V	ADC_A1_raw: 3488	V_adc_a1: 0.654 V
Position: 12	DAC_Bits: 496	V_set_dac: 0.606 V	V_set_pot: 0.606 V	ADC_A0_raw: 3243	V_adc_a0: 0.608 V	ADC_A1_raw: 3219	V_adc_a1: 0.604 V
Position: 11	DAC_Bits: 455	V_set_dac: 0.556 V	V_set_pot: 0.556 V	ADC_A0_raw: 2974	V_adc_a0: 0.558 V	ADC_A1_raw: 2946	V_adc_a1: 0.552 V
Position: 10	DAC_Bits: 413	V_set_dac: 0.504 V	V_set_pot: 0.505 V	ADC_A0_raw: 2702	V_adc_a0: 0.507 V	ADC_A1_raw: 2675	V_adc_a1: 0.502 V
Position: 9	DAC_Bits: 372	V_set_dac: 0.454 V	V_set_pot: 0.455 V	ADC_A0_raw: 2434	V_adc_a0: 0.456 V	ADC_A1_raw: 2411	V_adc_a1: 0.452 V
Position: 8	DAC_Bits: 330	V_set_dac: 0.403 V	V_set_pot: 0.404 V	ADC_A0_raw: 2162	V_adc_a0: 0.405 V	ADC_A1_raw: 2141	V_adc_a1: 0.401 V
Position: 7	DAC_Bits: 289	V_set_dac: 0.353 V	V_set_pot: 0.354 V	ADC_A0_raw: 1892	V_adc_a0: 0.355 V	ADC_A1_raw: 1876	V_adc_a1: 0.352 V
