Shawez17/iseg_6kV_controlSystem/mcu_tests/pico-raspi/raspi_info.md

Monitor port settings:
  baudrate=115200
  bits=8
  dtr=on
  parity=none
  rts=on
  stop_bits=1

Connecting to /dev/cu.usbmodem1201. Press CTRL-C to exit.
========================================
      RP2040 BOARD INFORMATION
========================================
Chip: RP2040
Flash size: 2 MB
Unique Board ID: E66038B713203430
Pico SDK Version: 2.3.0
CPU Frequency: 200 MHz
CPU Cores: 2
Chip ID register: 0x10002927
========================================
