Shawez17/iseg_6kV_controlSystem/mcu_tests/pico-raspi/plot_data_dac2.csv

Vset expected  : 0.05439 V
Vdac measured  : 0.05277 V
Vset - Vdac    : 0.00162 V
Dac bits       : 45
analogPot     :0.79
Vset expected  : 0.11218 V
Vdac measured  : 0.11025 V
Vset - Vdac    : 0.00193 V
Dac bits       : 90
analogPot     :0.80
Vset expected  : 0.16827 V
Vdac measured  : 0.16461 V
Vset - Vdac    : 0.00366 V
Dac bits       : 135
analogPot     :0.80
Vset expected  : 0.22438 V
Vdac measured  : 0.22128 V
Vset - Vdac    : 0.00310 V
Dac bits       : 180
analogPot     :0.80
Vset expected  : 0.28047 V
Vdac measured  : 0.27525 V
Vset - Vdac    : 0.00522 V
Dac bits       : 225
analogPot     :0.80
Vset expected  : 0.33655 V
Vdac measured  : 0.33222 V
Vset - Vdac    : 0.00433 V
Dac bits       : 270
analogPot     :0.80
Vset expected  : 0.39265 V
Vdac measured  : 0.38607 V
Vset - Vdac    : 0.00658 V
Dac bits       : 315
analogPot     :0.80
Vset expected  : 0.44869 V
Vdac measured  : 0.44088 V
Vset - Vdac    : 0.00781 V
Dac bits       : 360
analogPot     :0.80
Vset expected  : 0.50481 V
Vdac measured  : 0.49539 V
Vset - Vdac    : 0.00942 V
Dac bits       : 405
analogPot     :0.80
Vset expected  : 0.56092 V
Vdac measured  : 0.54933 V
Vset - Vdac    : 0.01159 V
Dac bits       : 450
analogPot     :0.80
Vset expected  : 0.61701 V
Vdac measured  : 0.60762 V
Vset - Vdac    : 0.00939 V
Dac bits       : 495
analogPot     :0.79
Vset expected  : 0.67311 V
Vdac measured  : 0.66234 V
Vset - Vdac    : 0.01077 V
Dac bits       : 540
analogPot     :0.72
Vset expected  : 0.72923 V
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
Dac bits       : 3960
analogPot     :0.79
Vset expected  : 4.84356 V
Vdac measured  : 4.79808 V
Vset - Vdac    : 0.04548 V
Dac bits       : 4005
analogPot     :0.80
Vset expected  : 4.89629 V
Vdac measured  : 4.86045 V
Vset - Vdac    : 0.03584 V
Dac bits       : 4050
analogPot     :0.79
