Shawez17/iseg_6kV_controlSystem/mcu_tests/pico-raspi/plot_data_span_dac1.csv

Vset expected  : 0.11216 V
Vdac measured  : 0.11643 V
Vset - Vdac    : -0.00427 V
Dac bits       : 90
analogPot     :0.79
Vset expected  : 0.16824 V
Vdac measured  : 0.17187 V
Vset - Vdac    : -0.00363 V
Dac bits       : 135
analogPot     :0.80
Vset expected  : 0.22433 V
Vdac measured  : 0.22662 V
Vset - Vdac    : -0.00229 V
Dac bits       : 180
analogPot     :0.80
Vset expected  : 0.33657 V
Vdac measured  : 0.33750 V
Vset - Vdac    : -0.00093 V
Dac bits       : 270
analogPot     :0.80
Vset expected  : 0.39261 V
Vdac measured  : 0.38970 V
Vset - Vdac    : 0.00291 V
Dac bits       : 315
analogPot     :0.80
Vset expected  : 0.44879 V
Vdac measured  : 0.44685 V
Vset - Vdac    : 0.00194 V
Dac bits       : 360
analogPot     :0.80
Vset expected  : 0.50494 V
Vdac measured  : 0.50112 V
Vset - Vdac    : 0.00382 V
Dac bits       : 405
analogPot     :0.79
Vset expected  : 0.56098 V
Vdac measured  : 0.55422 V
Vset - Vdac    : 0.00676 V
Dac bits       : 450
analogPot     :0.80
Vset expected  : 0.61716 V
Vdac measured  : 0.61230 V
Vset - Vdac    : 0.00486 V
Dac bits       : 495
analogPot     :0.80
Vset expected  : 0.67321 V
Vdac measured  : 0.66618 V
Vset - Vdac    : 0.00703 V
Dac bits       : 540
analogPot     :0.79
Vset expected  : 0.72919 V
Vdac measured  : 0.72204 V
Vset - Vdac    : 0.00715 V
Dac bits       : 585
analogPot     :0.81
Vset expected  : 0.78523 V
Vdac measured  : 0.77781 V
Vset - Vdac    : 0.00742 V
Dac bits       : 630
analogPot     :0.80
Vset expected  : 0.84141 V
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
analogPot     :0.81
Vset expected  : 0.44879 V
Vdac measured  : 0.44679 V
Vset - Vdac    : 0.00200 V
Dac bits       : 360
analogPot     :0.81
Vset expected  : 0.50489 V
Vdac measured  : 0.50130 V
Vset - Vdac    : 0.00359 V
Dac bits       : 405
analogPot     :0.81
Vset expected  : 0.56100 V
Vdac measured  : 0.55446 V
Vset - Vdac    : 0.00654 V
Dac bits       : 450
analogPot     :0.79
Vset expected  : 0.61710 V
Vdac measured  : 0.61227 V
Vset - Vdac    : 0.00483 V
Dac bits       : 495
analogPot     :0.80
