Shawez17/iseg_6kV_controlSystem/mcu_tests/pico-raspi-ethernet/01-09-26_stability_DNL.csv

DAC0_V | DAC1_V | Diff0_V | Diff1_V | ADS0_V | ADS1_V | ADS0_Raw | ADS1_Raw | DAC0_Raw | DAC1_Raw | Vref
0.01533 | 0.01533 | -0.00169 | -0.00064 | 0.01703 | 0.01598 | 90.80 | 85.20 | 100 | 100 | 5.02470
0.03067 | 0.03067 | -0.00196 | -0.00083 | 0.03263 | 0.03150 | 174.00 | 168.00 | 200 | 200 | 5.02410
0.04597 | 0.04597 | -0.00107 | -0.00132 | 0.04704 | 0.04729 | 250.90 | 252.20 | 300 | 300 | 5.02093
0.06126 | 0.06126 | -0.00161 | -0.00201 | 0.06287 | 0.06326 | 335.30 | 337.40 | 400 | 400 | 5.01803
0.07654 | 0.07654 | -0.00090 | -0.00140 | 0.07744 | 0.07794 | 413.00 | 415.70 | 500 | 500 | 5.01592
0.09181 | 0.09181 | -0.00182 | -0.00227 | 0.09364 | 0.09409 | 499.40 | 501.80 | 600 | 600 | 5.01409
0.10709 | 0.10709 | -0.00119 | -0.00170 | 0.10828 | 0.10879 | 577.50 | 580.20 | 700 | 700 | 5.01274
0.12232 | 0.12232 | -0.00184 | -0.00355 | 0.12416 | 0.12587 | 662.20 | 671.30 | 800 | 800 | 5.01009
0.13758 | 0.13758 | -0.00119 | -0.00296 | 0.13877 | 0.14053 | 740.10 | 749.50 | 900 | 900 | 5.00884
0.15282 | 0.15282 | -0.00171 | -0.00355 | 0.15454 | 0.15638 | 824.20 | 834.00 | 1000 | 1000 | 5.00756
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
