Shawez17/iseg_6kV_controlSystem/mcu_tests/pico-raspi/blockdiagram.png

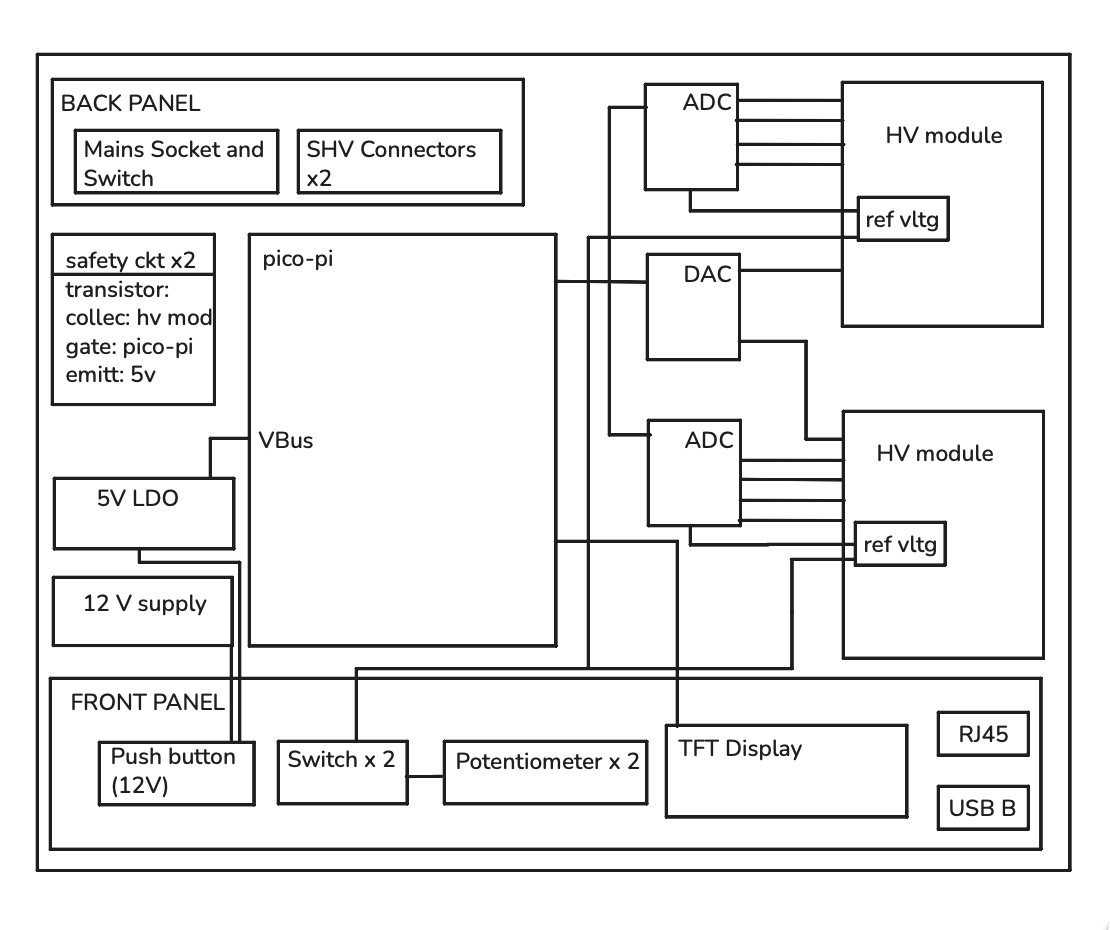
mcu_tests/pico-raspi/blockdiagram.png
