Shawez17/iseg_6kV_controlSystem/mcu_tests/pico-raspi/dac1.png

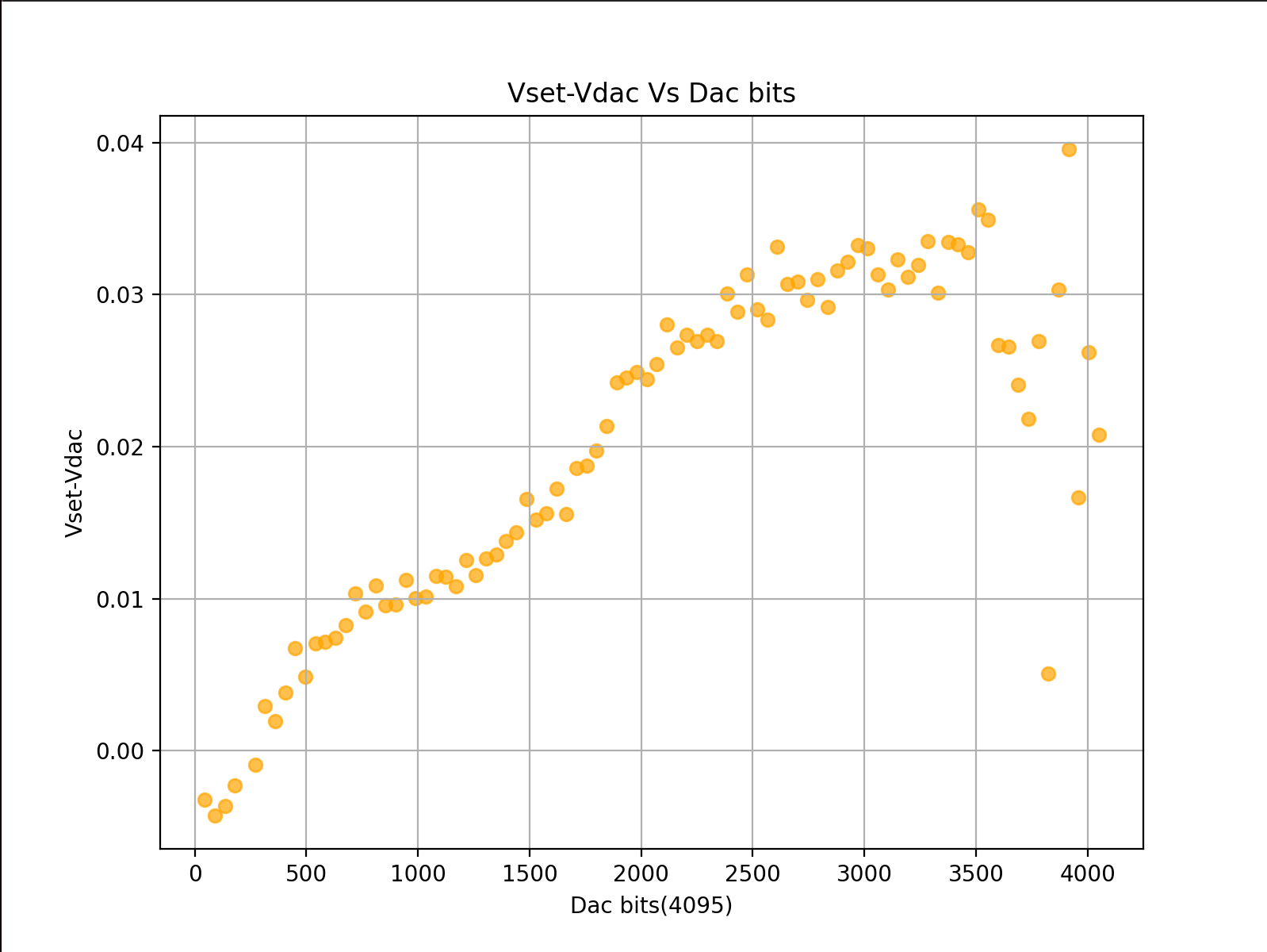
mcu_tests/pico-raspi/dac1.png
