Shawez17/iseg_6kV_controlSystem/mcu_tests/pico-raspi/dac2.png

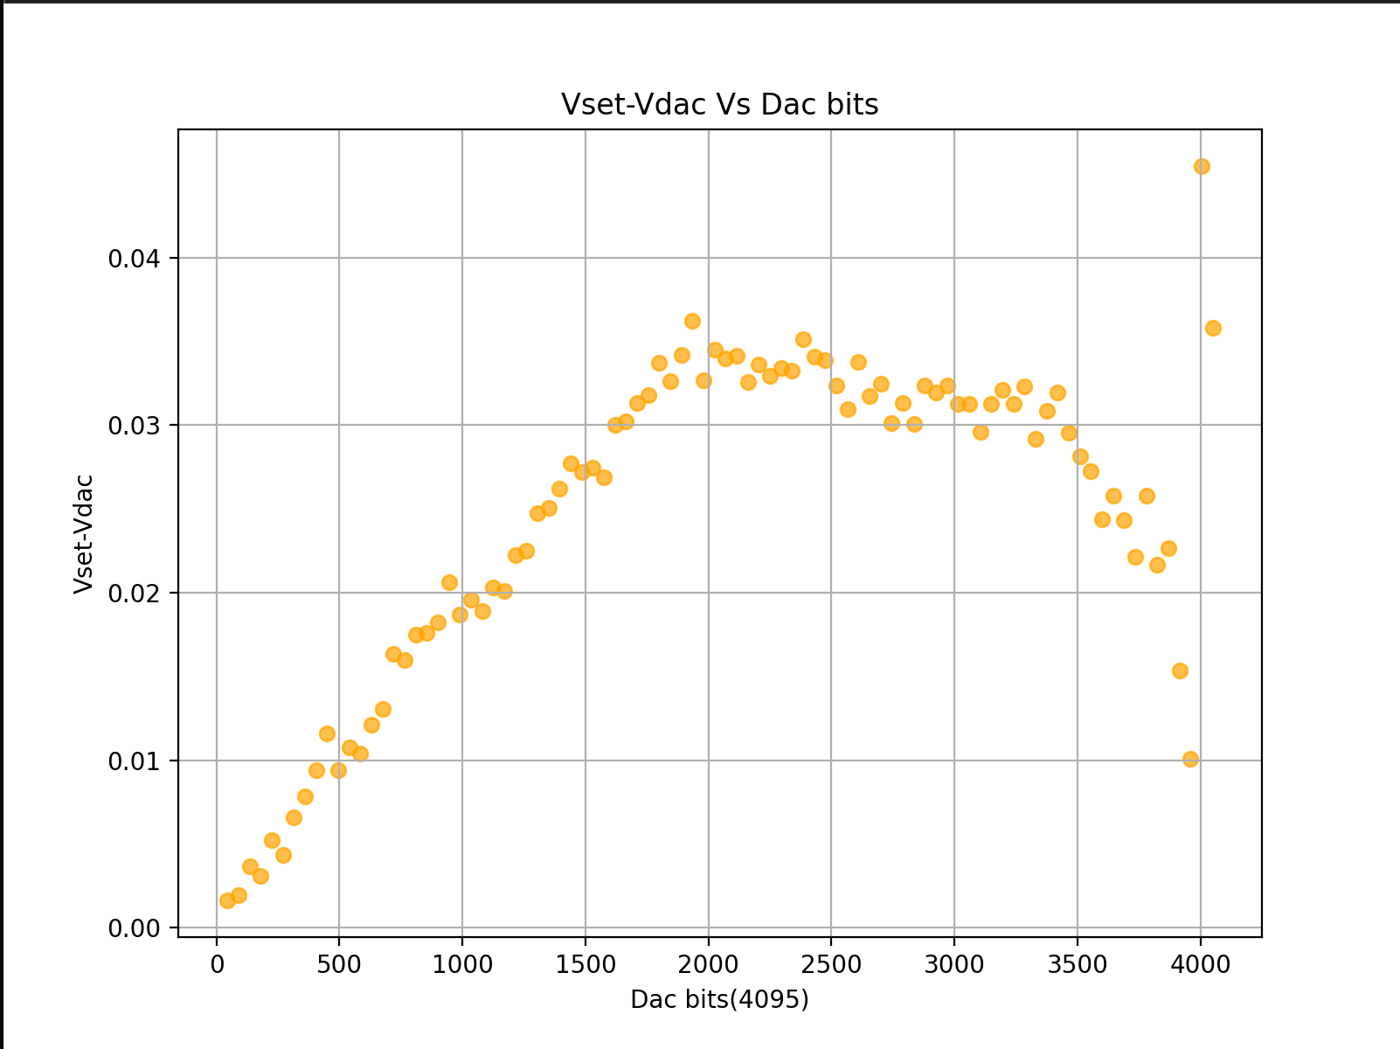
mcu_tests/pico-raspi/dac2.png
