Shawez17/iseg_6kV_controlSystem/mcu_tests/pico-raspi/plot.png

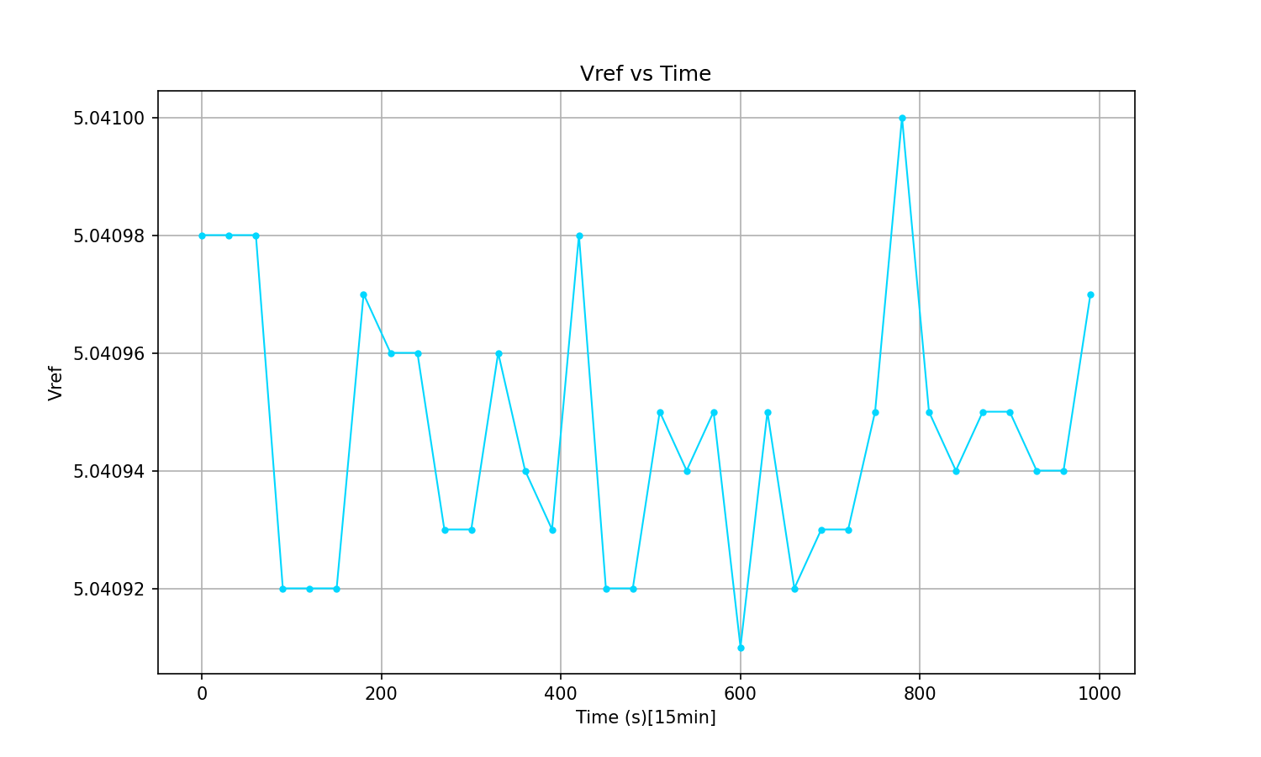
mcu_tests/pico-raspi/plot.png
