Shawez17/iseg_6kV_controlSystem/mcu_tests/pico-raspi/plot_col1.png

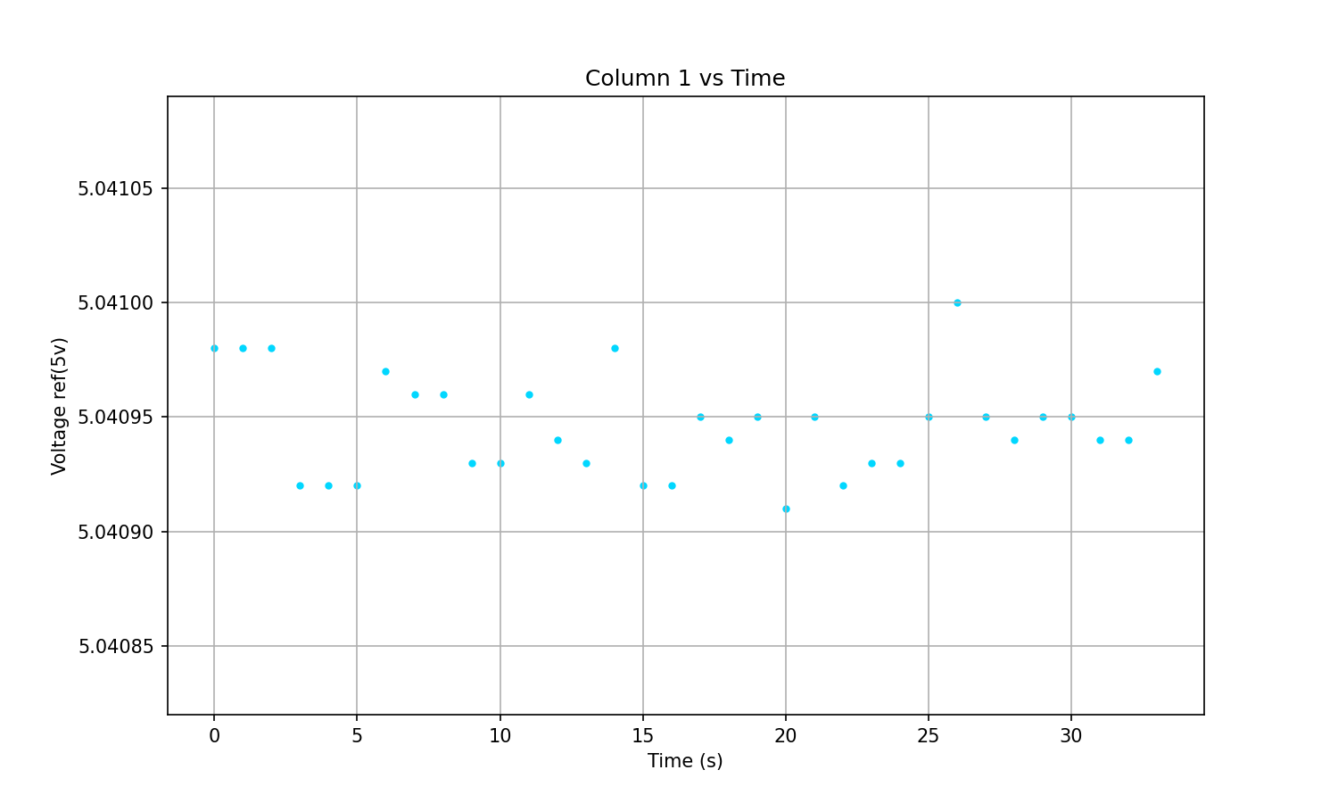
mcu_tests/pico-raspi/plot_col1.png
