Shawez17/iseg_6kV_controlSystem/mcu_tests/pico-raspi/plot_col2.png

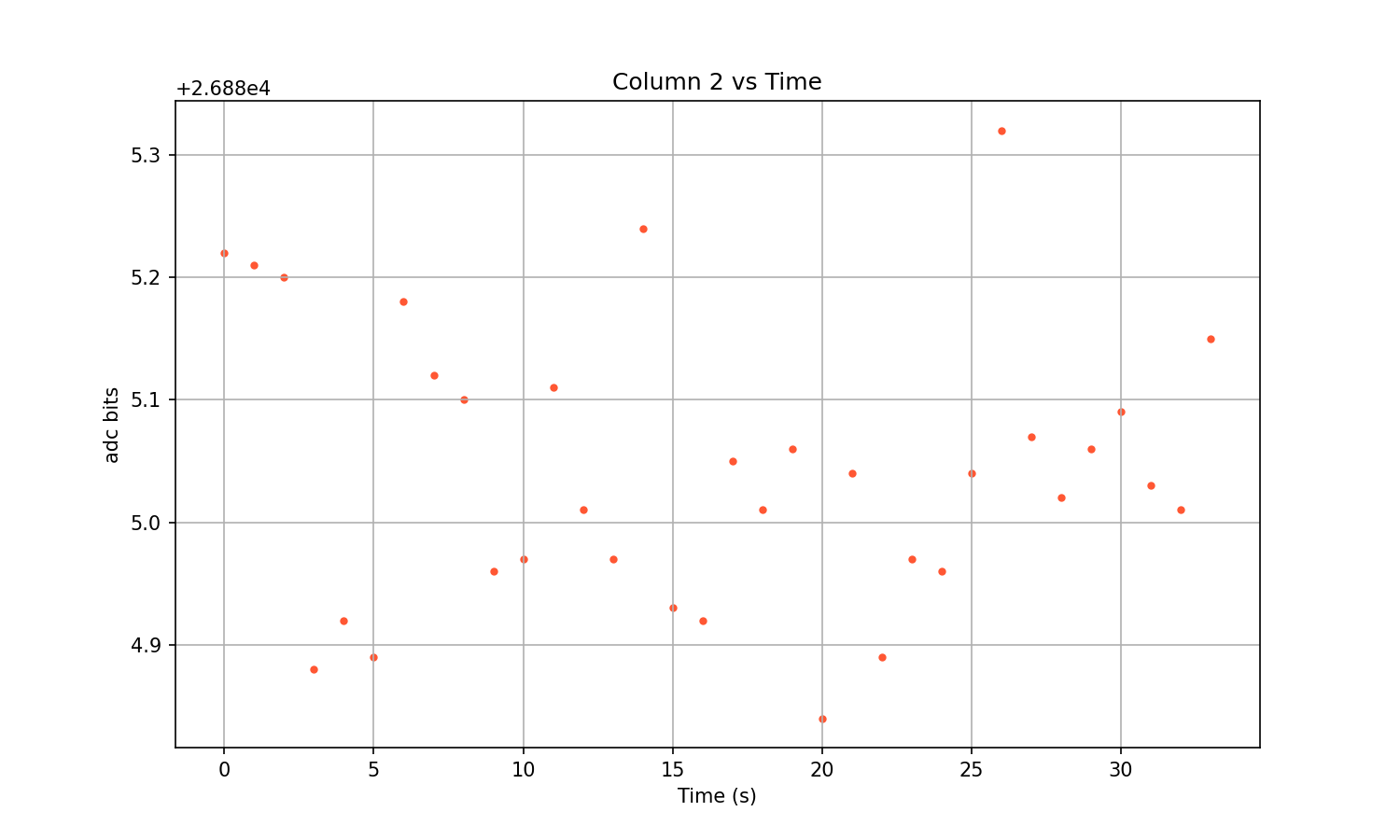
mcu_tests/pico-raspi/plot_col2.png
