Shawez17/iseg_6kV_controlSystem/mcu_tests/pico-raspi/vset_vdac_plot.png

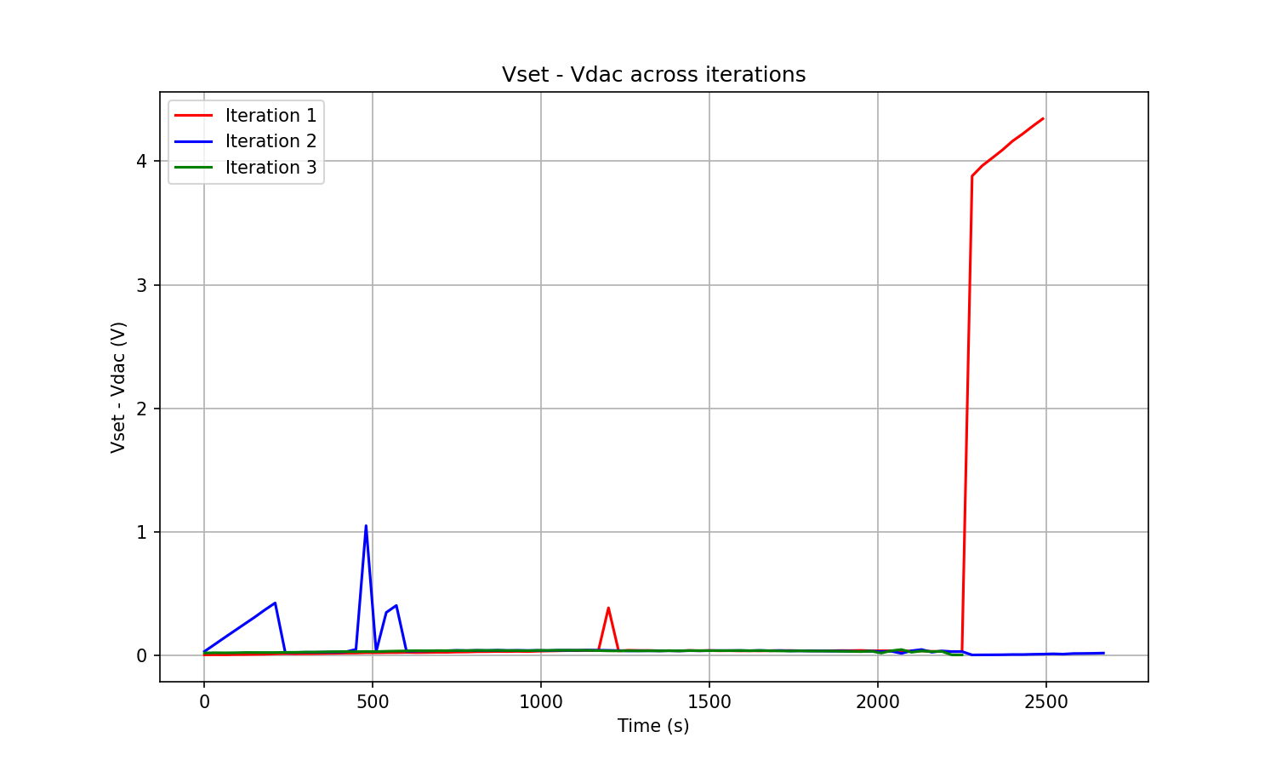
mcu_tests/pico-raspi/vset_vdac_plot.png
