Shawez17/iseg_6kV_controlSystem/control-system/ethernet_communication.h

#pragma once

#include <Arduino.h>

#include "state.h"

void initializeEthernetCommunication();
void pollEthernetCommunication(SystemState& state);
bool ethernetInterfaceReady();
IPAddress ethernetLocalIP();
