Shawez17/iseg_6kV_controlSystem/(commit log)

2026-08-20 Initialtes stability_check
    [partitions.csv]
2026-08-24 Initialtes pico-stabilityTest_Code
2026-09-01 Initialtes update
    [plot_data_dac2.csv, plot_data_dac2_1.csv, plot_data_span_dac1.csv, plot_data_span_dac1_1.csv, plot_data_span_third.csv, plot_vref.csv, plot_vref_1.csv, plot_vref_2.csv]
2026-09-01 Initialtes update_vijay
    [stability#1_2o5_5o0.csv]
2026-09-04 Initialtes 04-09-26
    [01-09-26_stability_DNL.csv, stability#2_ver1.csv]
2026-09-09 intial commit with new structure.
    [01-09-26_stability_DNL.csv, partitions.csv, plot_data_dac2.csv, plot_data_dac2_1.csv, plot_data_span_dac1.csv, plot_data_span_dac1_1.csv, plot_data_span_third.csv, plot_vref.csv]
2026-09-12 adc reading function not working, for some reason
    [control-system.ino, display_ui.cpp, hardware_i2c.cpp, hardware_i2c.h]
2026-09-16 updated and bug free -v1
    [config.h, display_ui.cpp, display_ui.h, serial_communication.cpp]
2026-09-16 working code with ethernet connection using toggle switch
